damoreluc/ITEM_2223_git_V7/README.md

# Hardware progetto ITEM
## ISIS Bassa Friulana Cervignano del Friuli - ISIS Malignani Udine - Danieli 

Progetto hardware delle schede del sistema di acquisizione dati del _Banco di prova per riduttori meccanici_<br>
Il progetto è realizzato con il cad Eagle.
