damoreluc/ITEM_2223_git_V7/item_2022_Frontend_02_V7_SCH.pdf

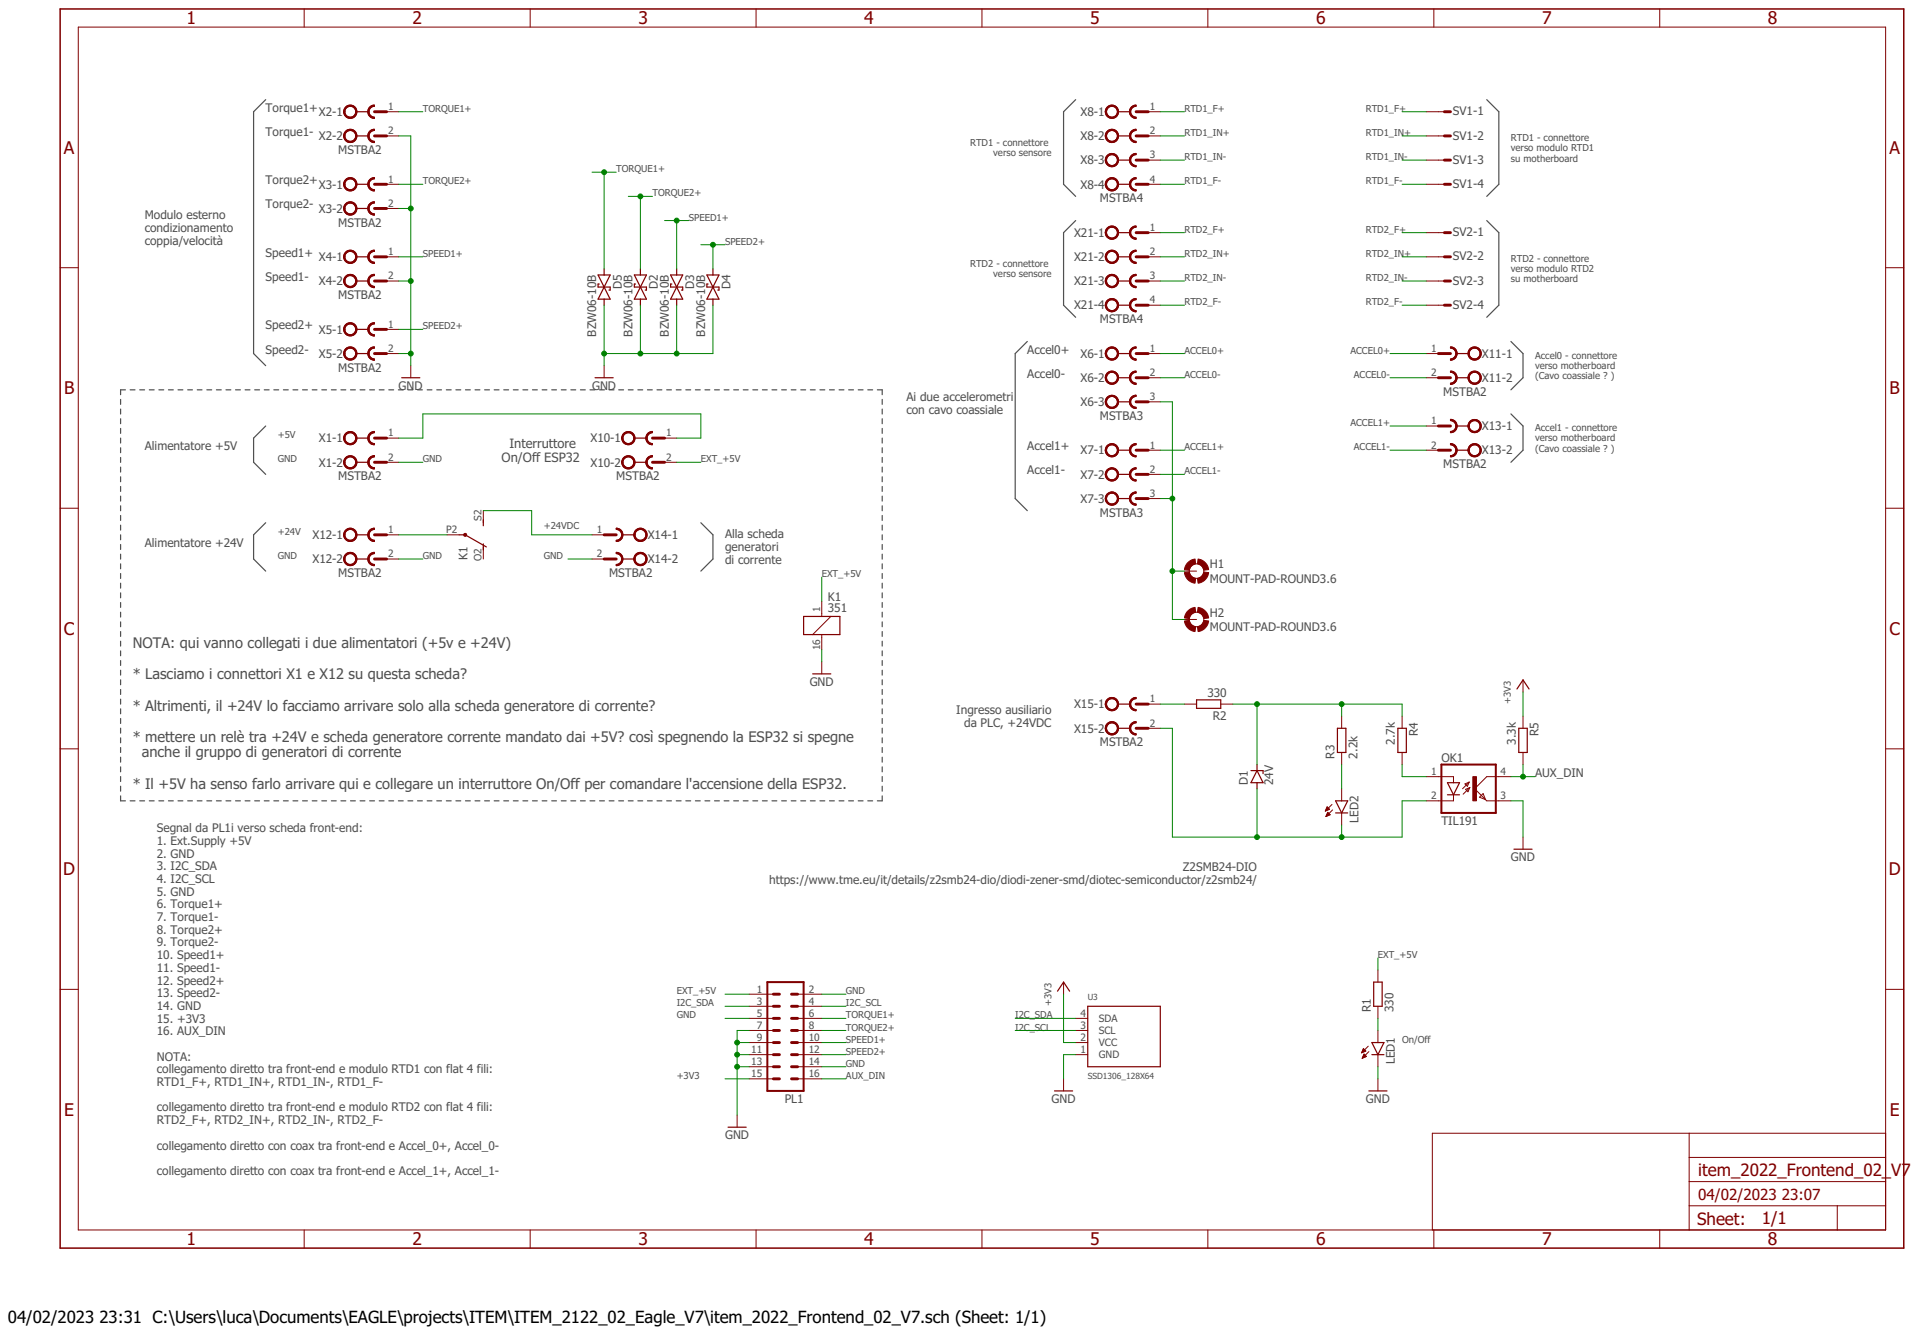
[picture p1: page 1]

TORQUE1+

Ai due accelerometri con cavo coassiale

NOTA: qui vanno collegati i due alimentatori (+5v e +24V) * Lasciamo i connettori X1 e X12 su questa scheda? * Altrimenti, il +24V lo facciamo arrivare solo alla scheda generatore di corrente? * mettere un relè tra +24V e scheda generatore corrente mandato dai +5V? così spegnendo la ESP32 si spegne

Ingresso ausiliario da PLC, +24VDC

anche il gruppo di generatori di corrente * Il +5V ha senso farlo arrivare qui e collegare un interruttore On/Off per comandare l'accensione della ESP32.

Segnal da PL1i verso scheda front-end: 1. Ext.Supply +5V

https://www.tme.eu/it/details/z2smb24-dio/diodi-zener-smd/diotec-semiconductor/z2smb24/

NOTA: collegamento diretto tra front-end e modulo RTD1 con flat 4 fili: RTD1_F+, RTD1_IN+, RTD1_IN-, RTD1_F- collegamento diretto tra front-end e modulo RTD2 con flat 4 fili: RTD2_F+, RTD2_IN+, RTD2_IN-, RTD2_F- collegamento diretto con coax tra front-end e Accel_0+, Accel_0- collegamento diretto con coax tra front-end e Accel_1+, Accel_1-

04/02/2023 23:31 C:\Users\luca\Documents\EAGLE\projects\ITEM\ITEM_2122_02_Eagle_V7\item_2022_Frontend_02_V7.sch (Sheet: 1/1)
