damoreluc/ITEM_2223_git_V7/item_2022_Motherboard_04_V8_SCH.pdf

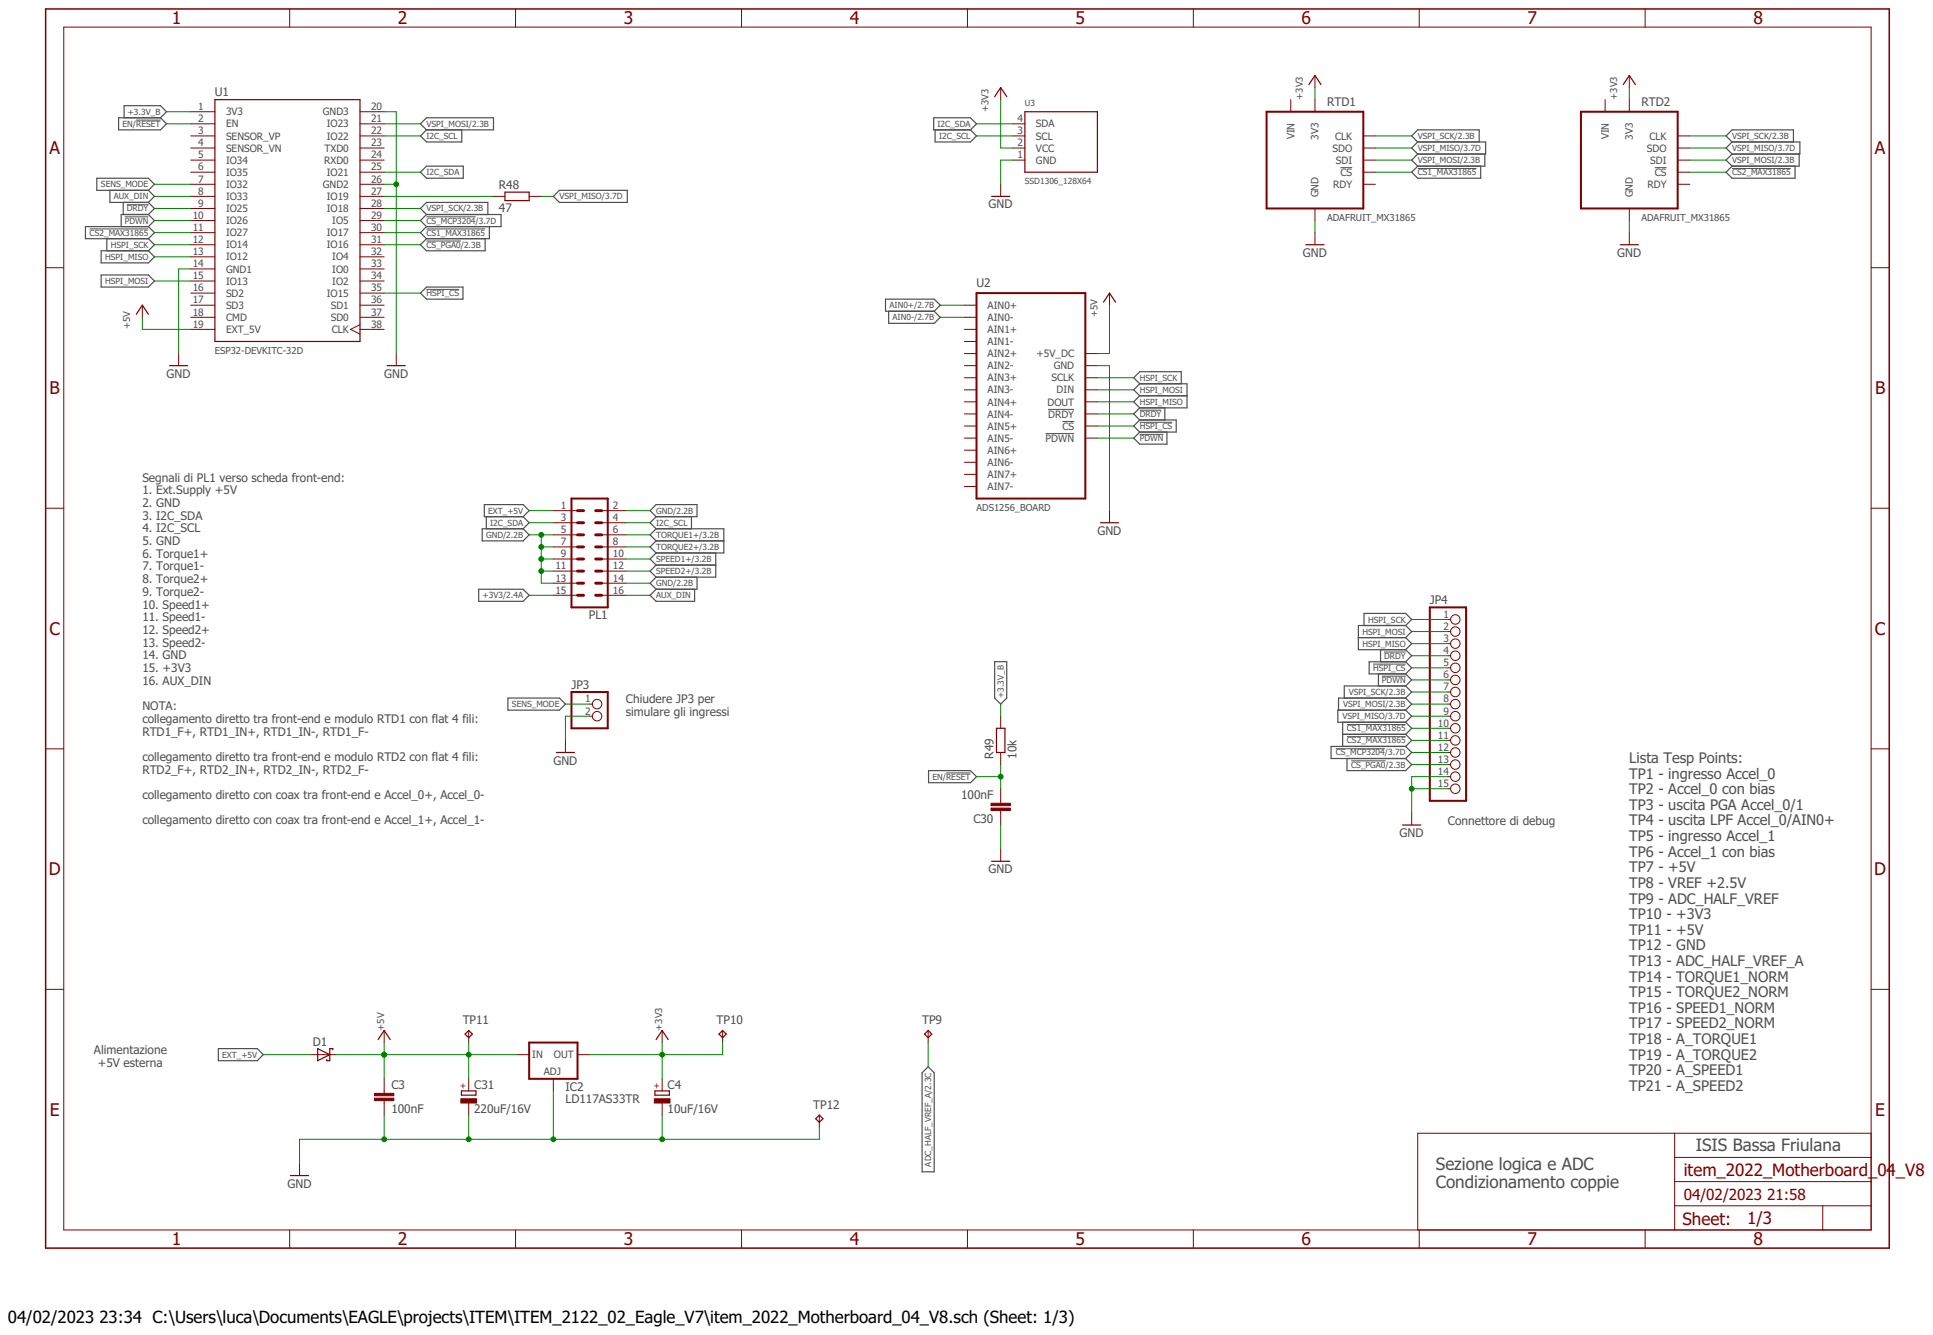
[picture p2: page 1]

Segnali di PL1 verso scheda front-end: 1. Ext.Supply +5V

NOTA: collegamento diretto tra front-end e modulo RTD1 con flat 4 fili: RTD1_F+, RTD1_IN+, RTD1_IN-, RTD1_F- collegamento diretto tra front-end e modulo RTD2 con flat 4 fili: RTD2_F+, RTD2_IN+, RTD2_IN-, RTD2_F- collegamento diretto con coax tra front-end e Accel_0+, Accel_0- collegamento diretto con coax tra front-end e Accel_1+, Accel_1-

Chiudere JP3 per simulare gli ingressi

04/02/2023 23:34 C:\Users\luca\Documents\EAGLE\projects\ITEM\ITEM_2122_02_Eagle_V7\item_2022_Motherboard_04_V8.sch (Sheet: 1/3)

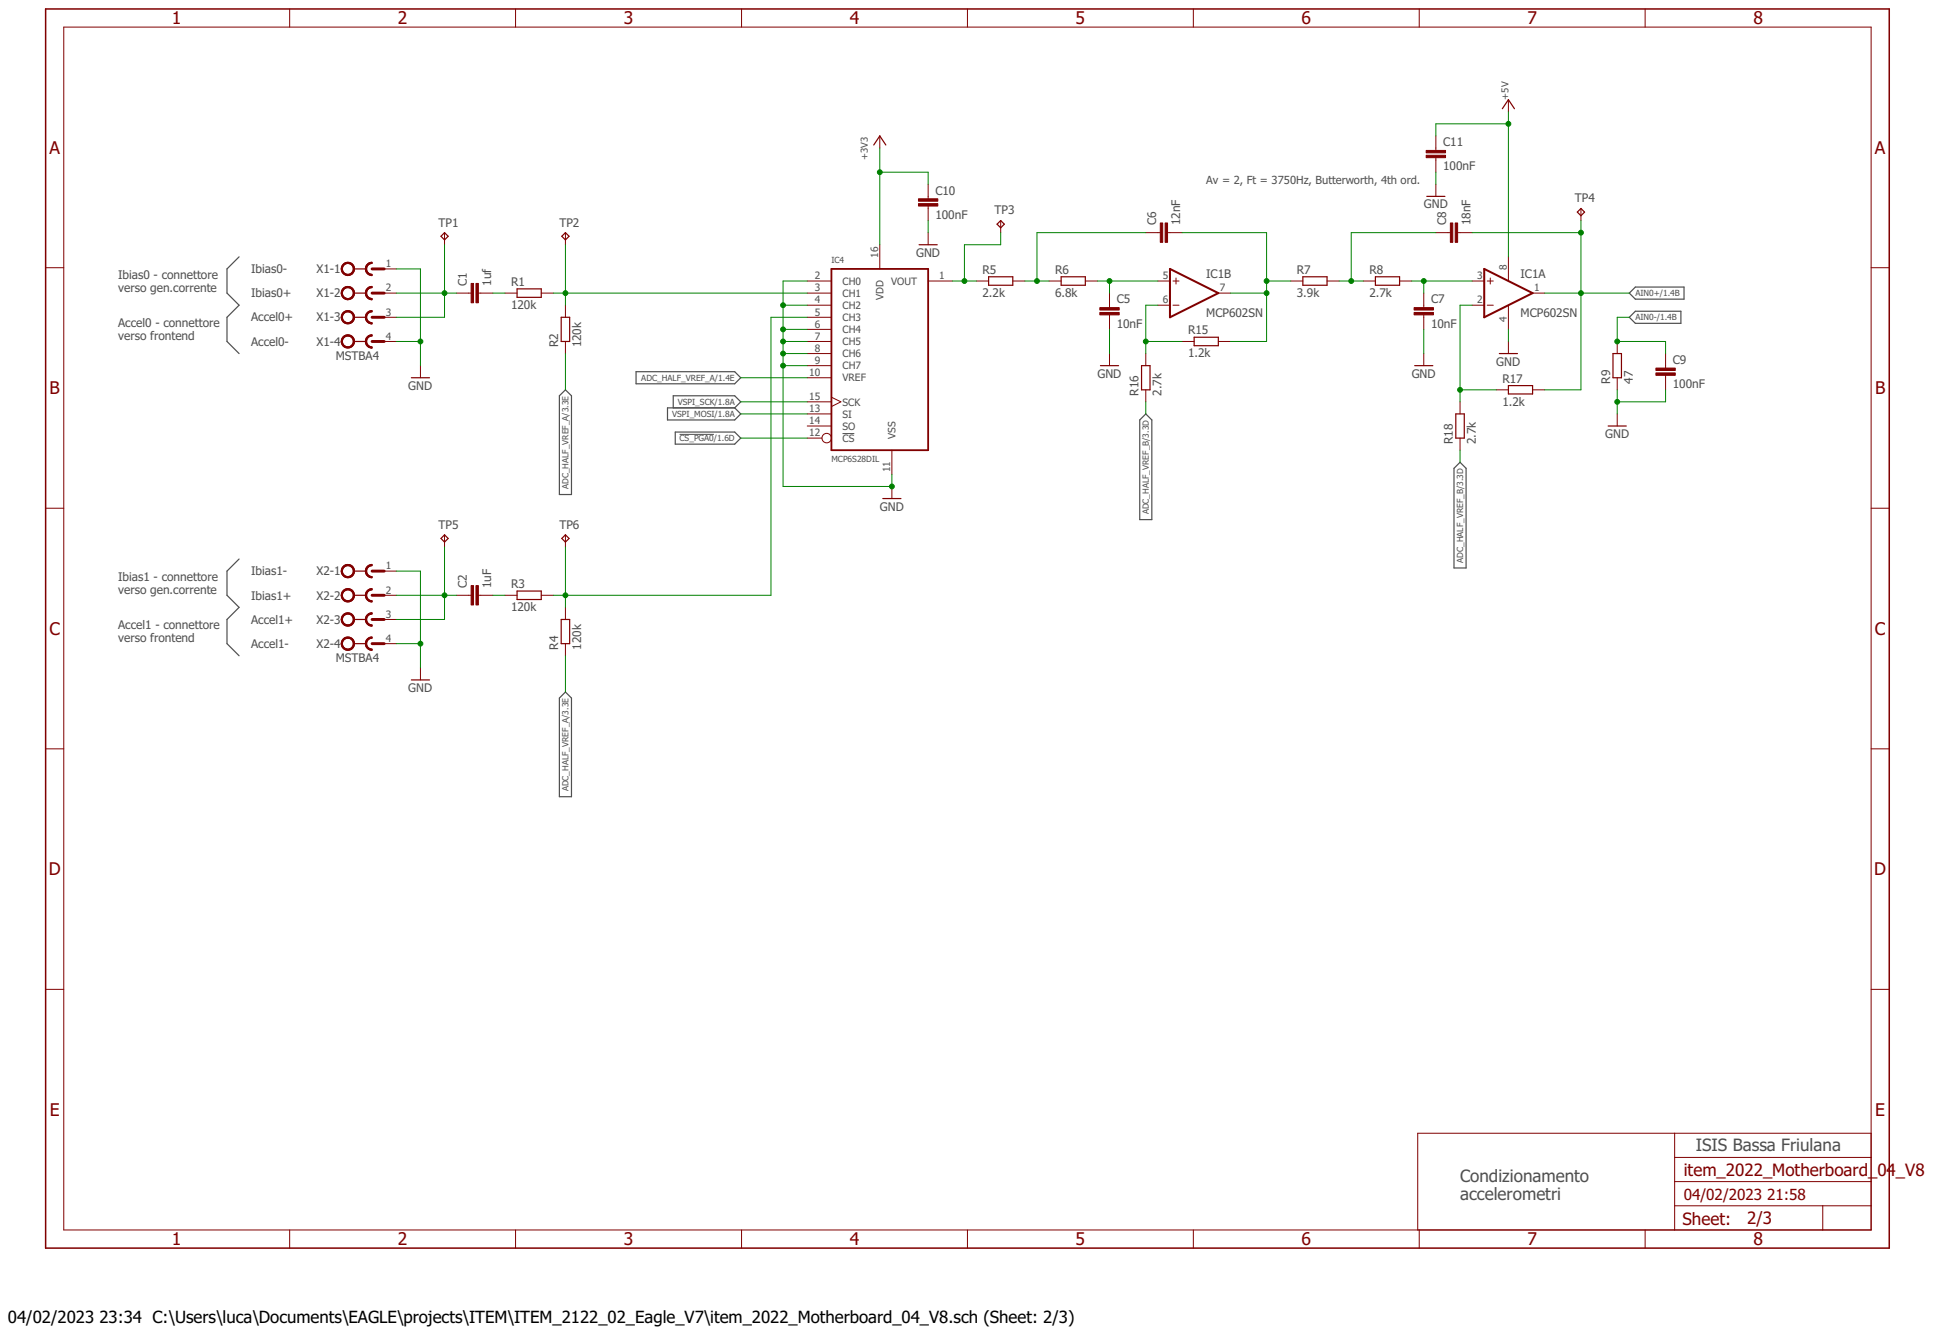
[picture p3: page 2]

Av = 2, Ft = 3750Hz, Butterworth, 4th ord.

15
SI 13

04/02/2023 23:34 C:\Users\luca\Documents\EAGLE\projects\ITEM\ITEM_2122_02_Eagle_V7\item_2022_Motherboard_04_V8.sch (Sheet: 2/3)

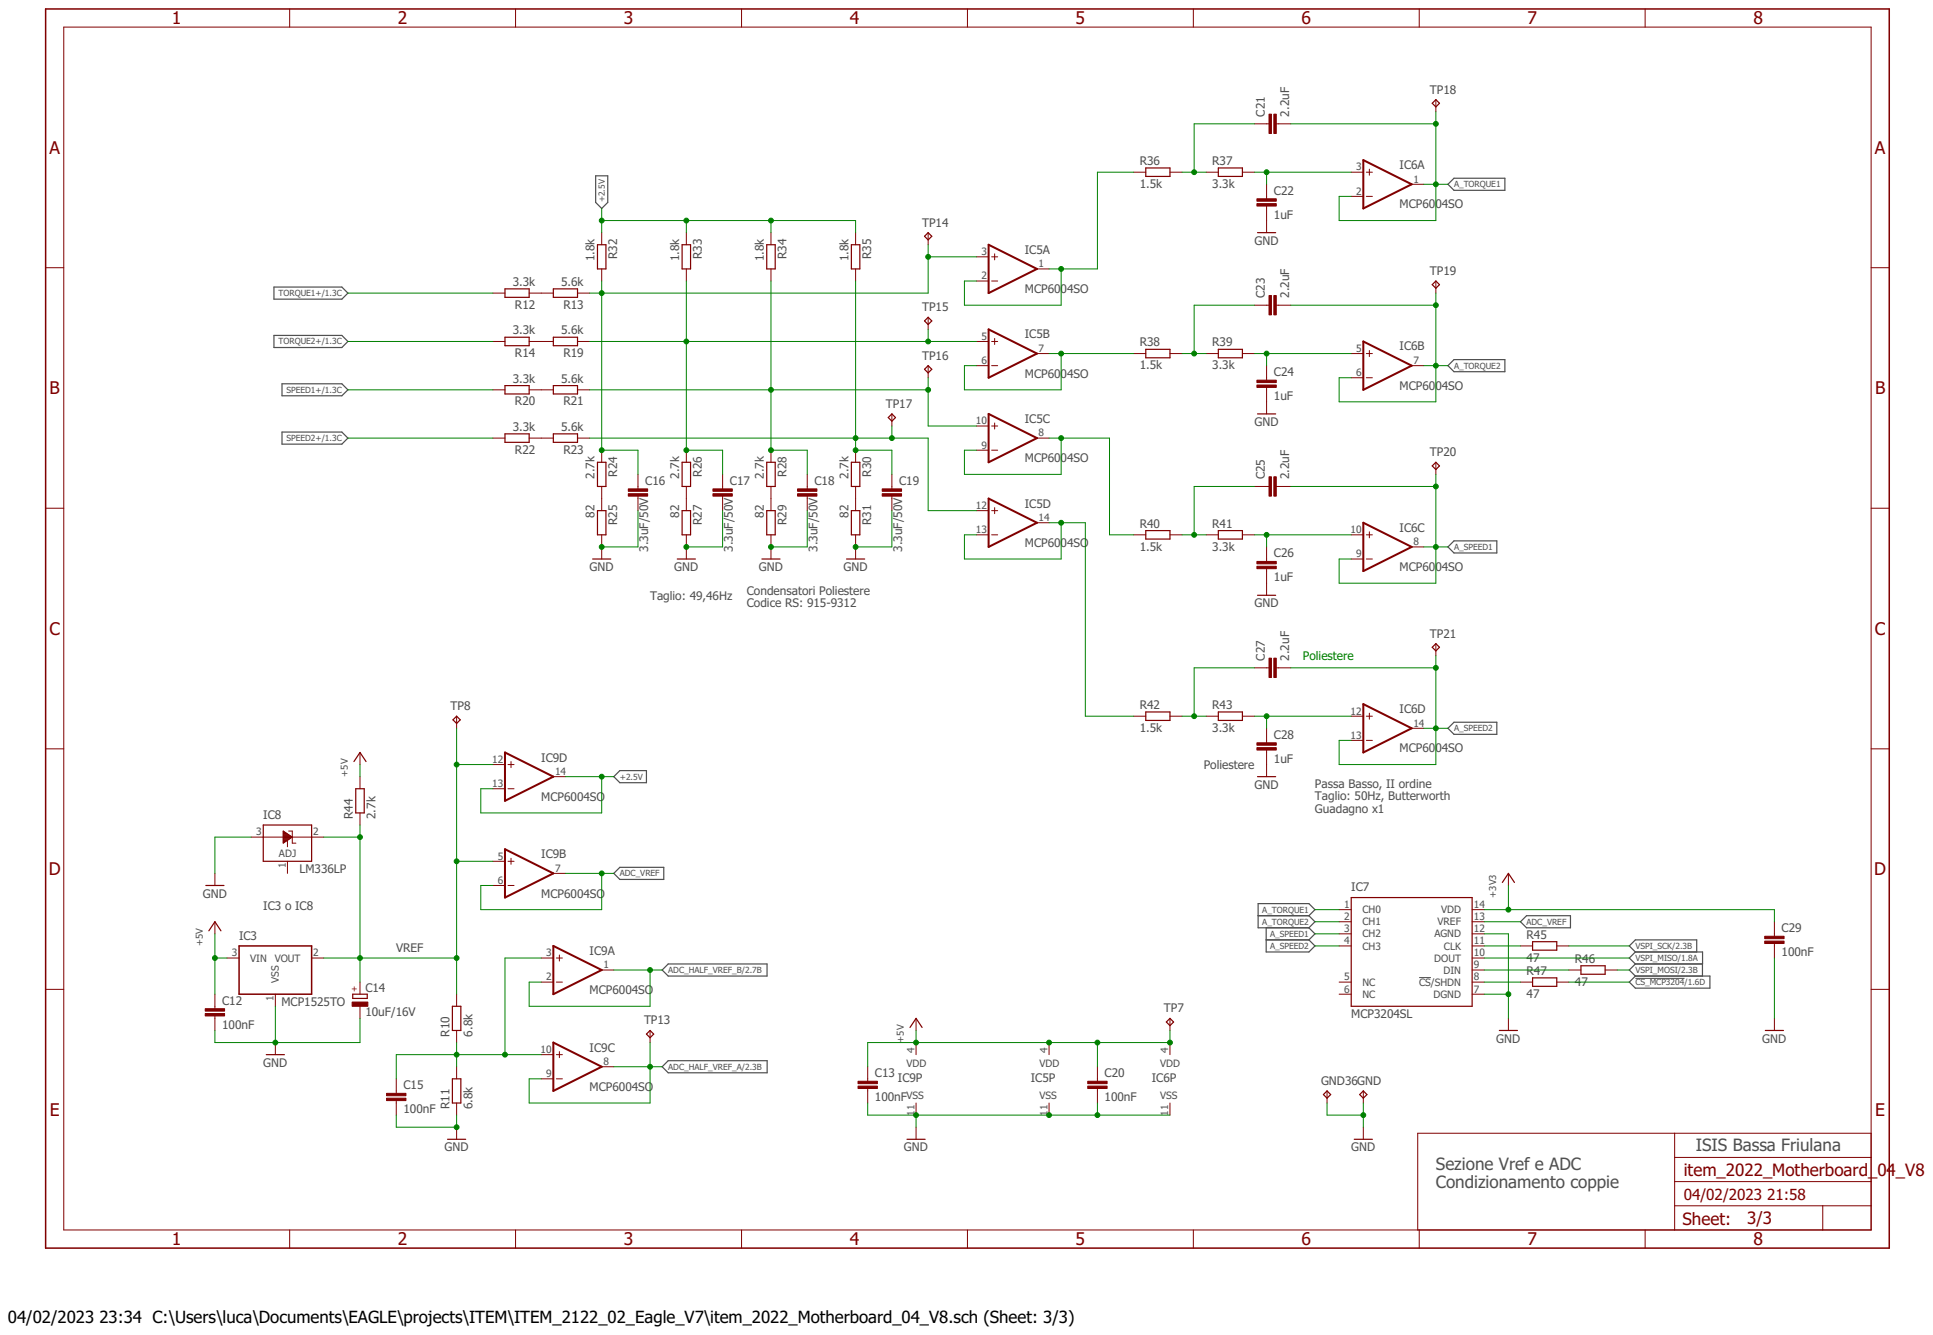
[picture p4: page 3]

Passa Basso, II ordine Taglio: 50Hz, Butterworth

04/02/2023 23:34 C:\Users\luca\Documents\EAGLE\projects\ITEM\ITEM_2122_02_Eagle_V7\item_2022_Motherboard_04_V8.sch (Sheet: 3/3)
