damoreluc/ITEM_2223_git_V7/item_2022_02b.pdf

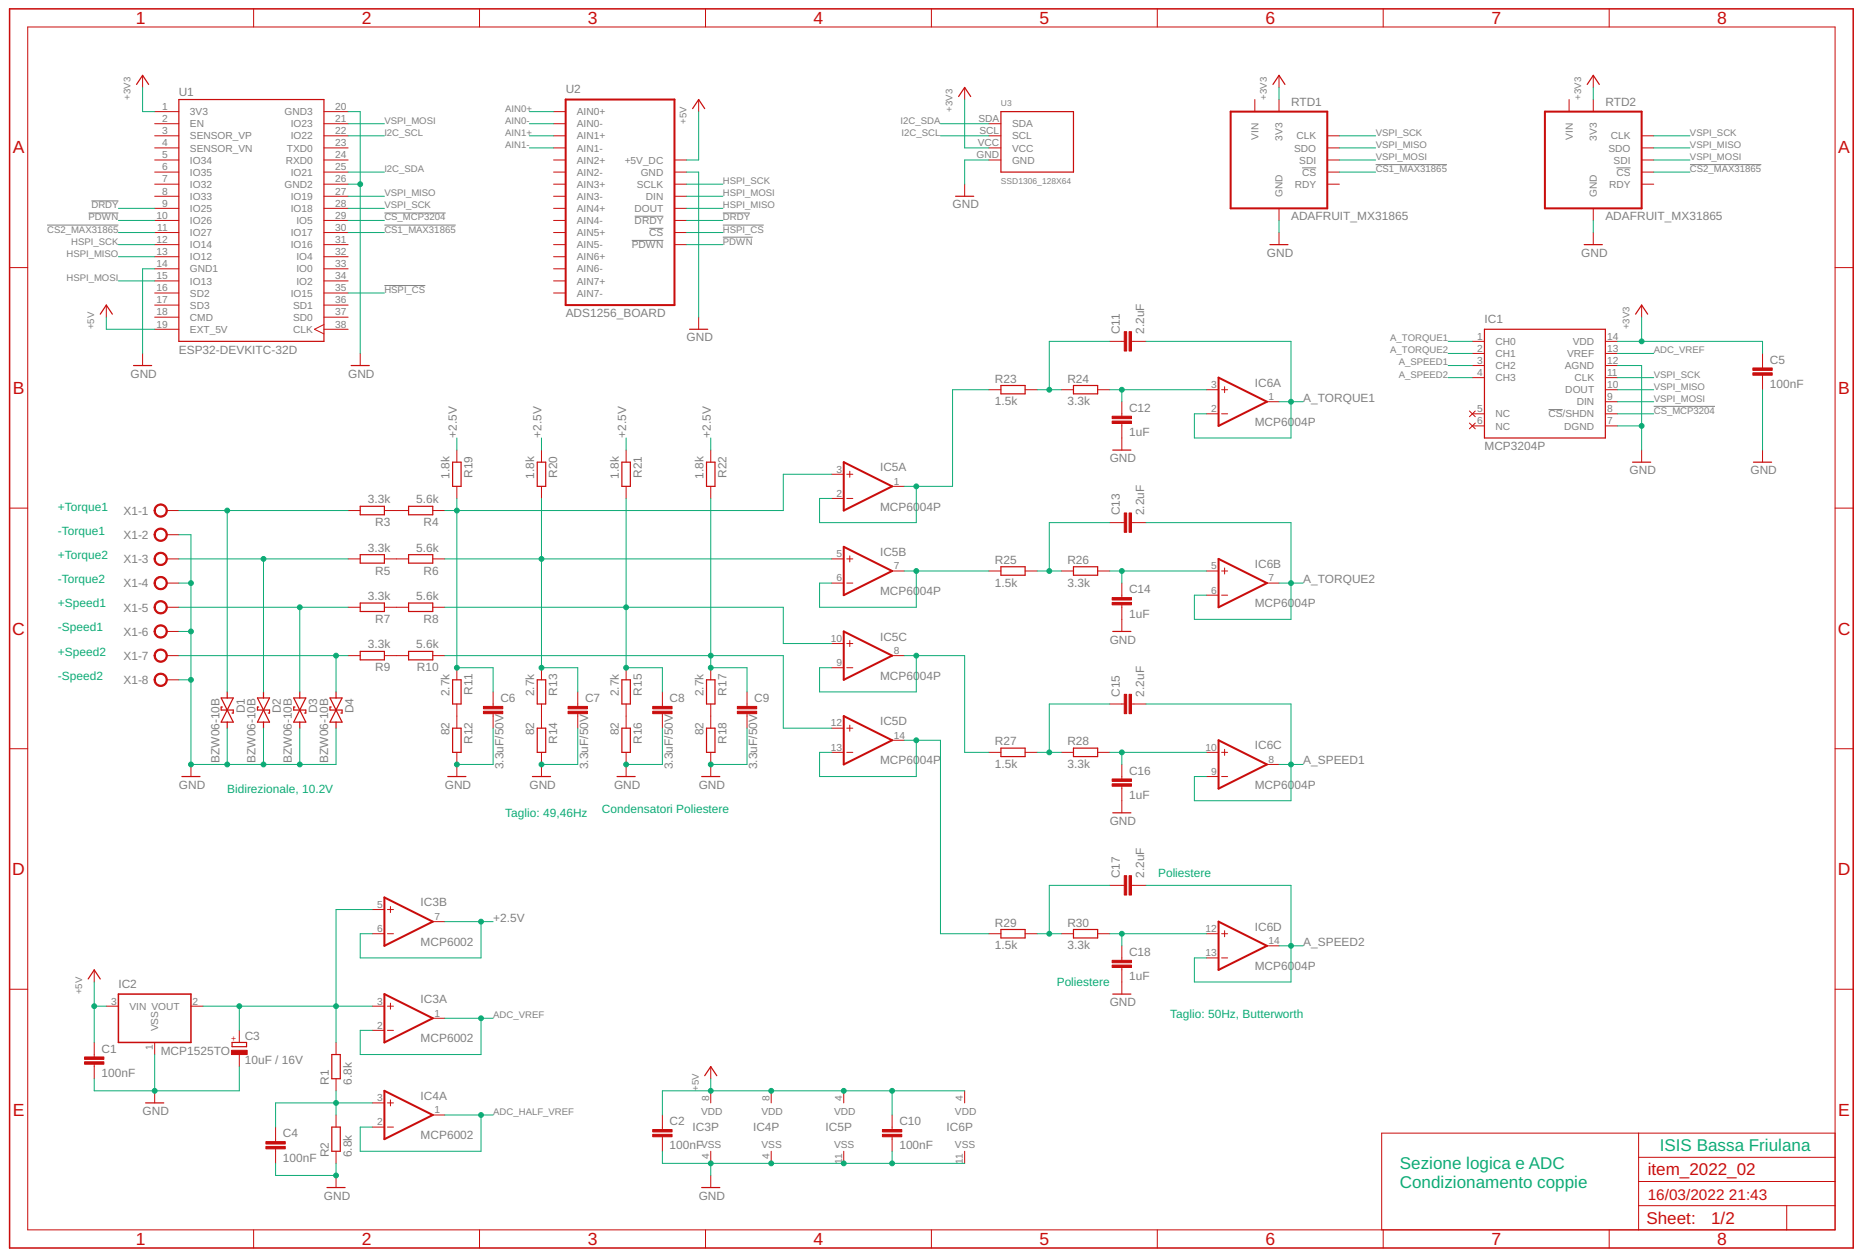
[picture p5: page 1]

Sezione logica e ADC Condizionamento coppie | ISIS Bassa Friulana

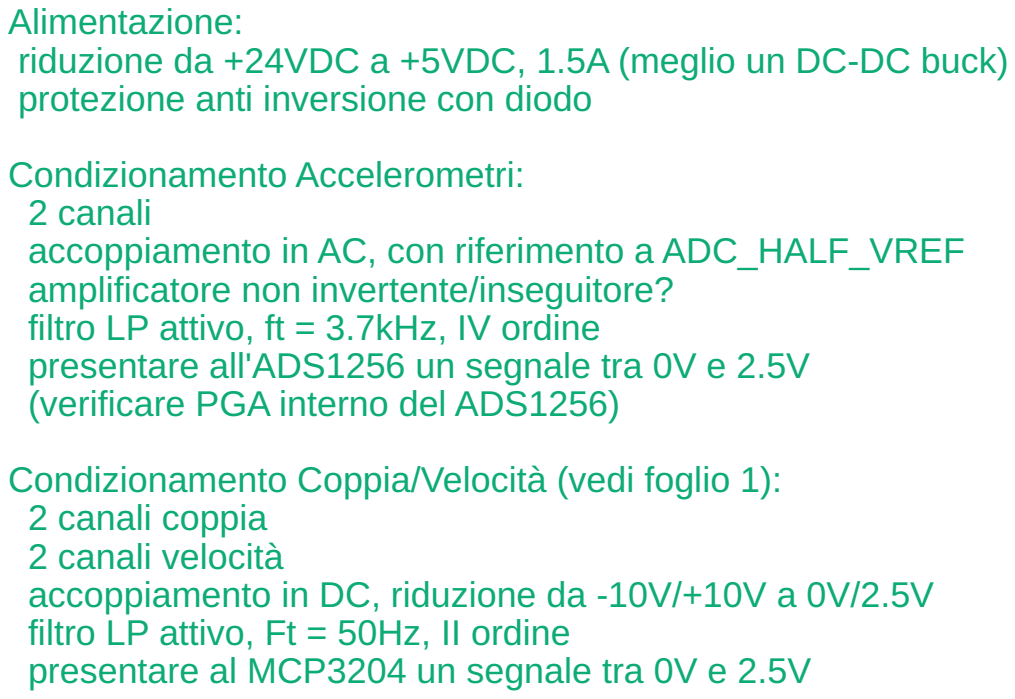
[picture p6: page 2]

Alimentazione:
riduzione da +24VDC a +5VDC, 1.5A (meglio un DC-DC buck)
protezione anti inversione con diodo

Condizionamento Accelerometri:
2 canali
accoppiamento in AC, con riferimento a ADC_HALF_VREF
amplificatore non invertente/inseguitore?
filtro LP attivo, ft = 3.7kHz, IV ordine
presentare all'ADS1256 un segnale tra 0V e 2.5V
(verificare PGA interno del ADS1256)

Condizionamento Coppia/Velocità (vedi foglio 1):

2 canali coppia
2 canali velocità
accoppiamento in DC, riduzione da -10V/+10V a 0V/2.5V
filtro LP attivo, Ft = 50Hz, II ordine
presentare al MCP3204 un segnale tra 0V e 2.5V
