damoreluc/ITEM_2223_git_V7/item_2022_analog_02_top.pdf

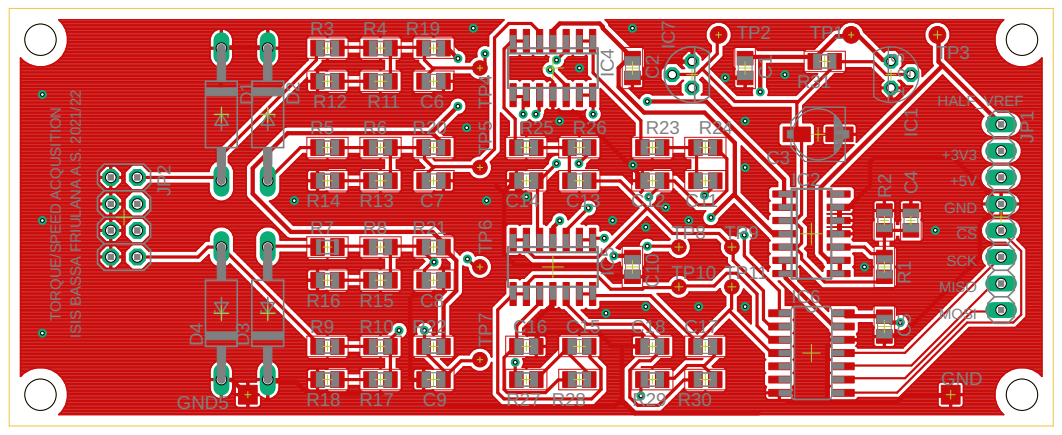
[picture p7: page 1]

2 3 1 MOSI MISO SCKCS GND +5V +3V3 HALF_VREF TORQUE/SPEED ACQUSITION ISIS BASSA FRIULANA A.S. 2021/22 C1 C10 C14 C13 C12 C11 C16 C15 C18 C17 C2 C3 C4 C5 C6 C7 C8C9 D1 D2 D3 D4 IC1 IC4 IC5 IC6 IC7 JP1 R1 R10 R12 R11 R14 R13 R16 R15 R18 R17 R19 R2 R20 R21 R22 R25 R26 R23 R24 R27 R28 R29 R3 R30 R31 R4 R5 R6 R7 R8 R9 IC2 GND GND5 TP2 TP1 TP3 TP4 TP5 TP6 TP7 TP8 TP9 TP10 TP11 JP2
