damoreluc/ITEM_2223_git_V7/item_2022_BlockDiagram_01.pdf

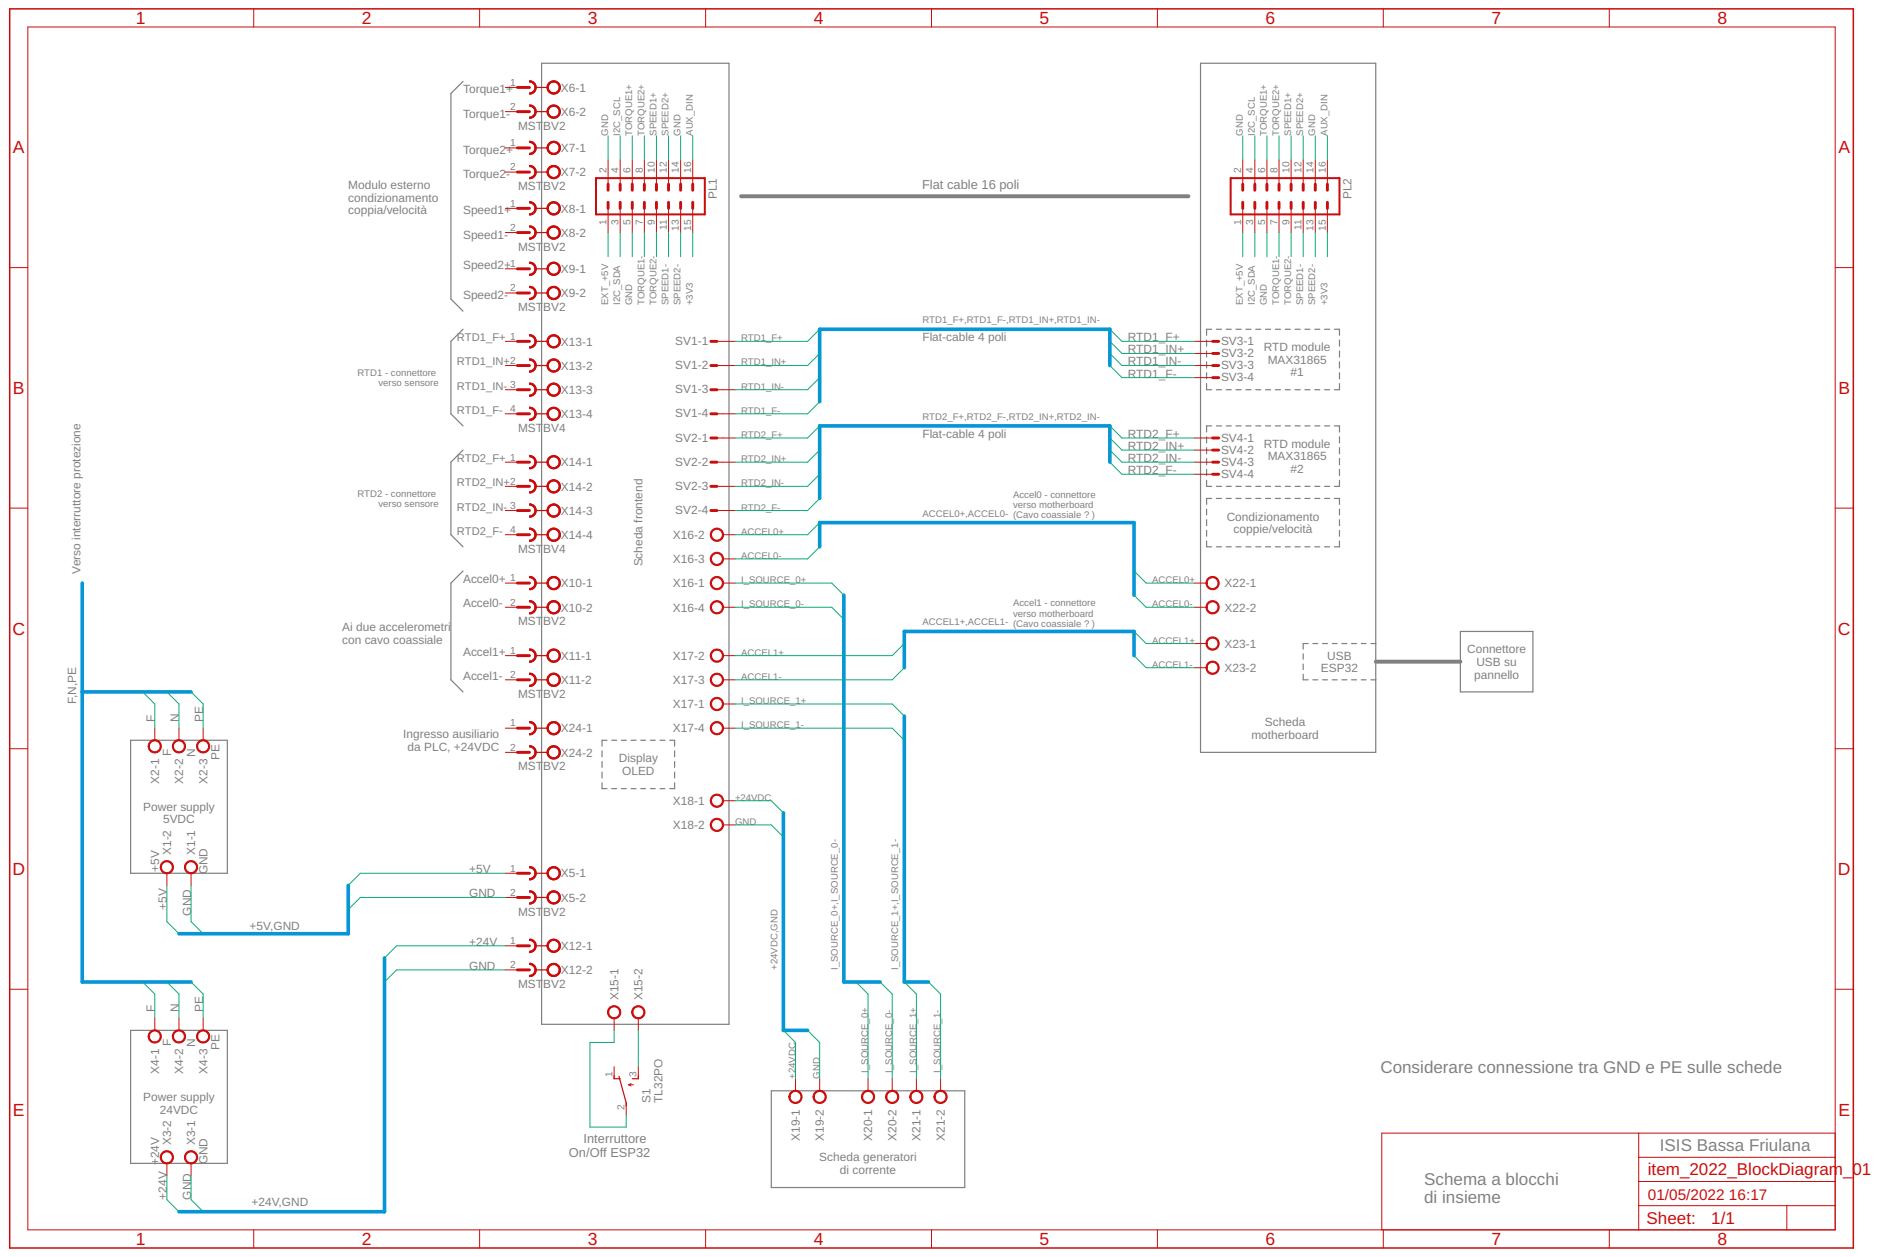
[picture p8: page 1]

Ai due accelerometri con cavo coassiale

Considerare connessione tra GND e PE sulle schede
