damoreluc/ITEM_2223_git_V7/item_2022_BlockDiagram_02.pdf

A

A

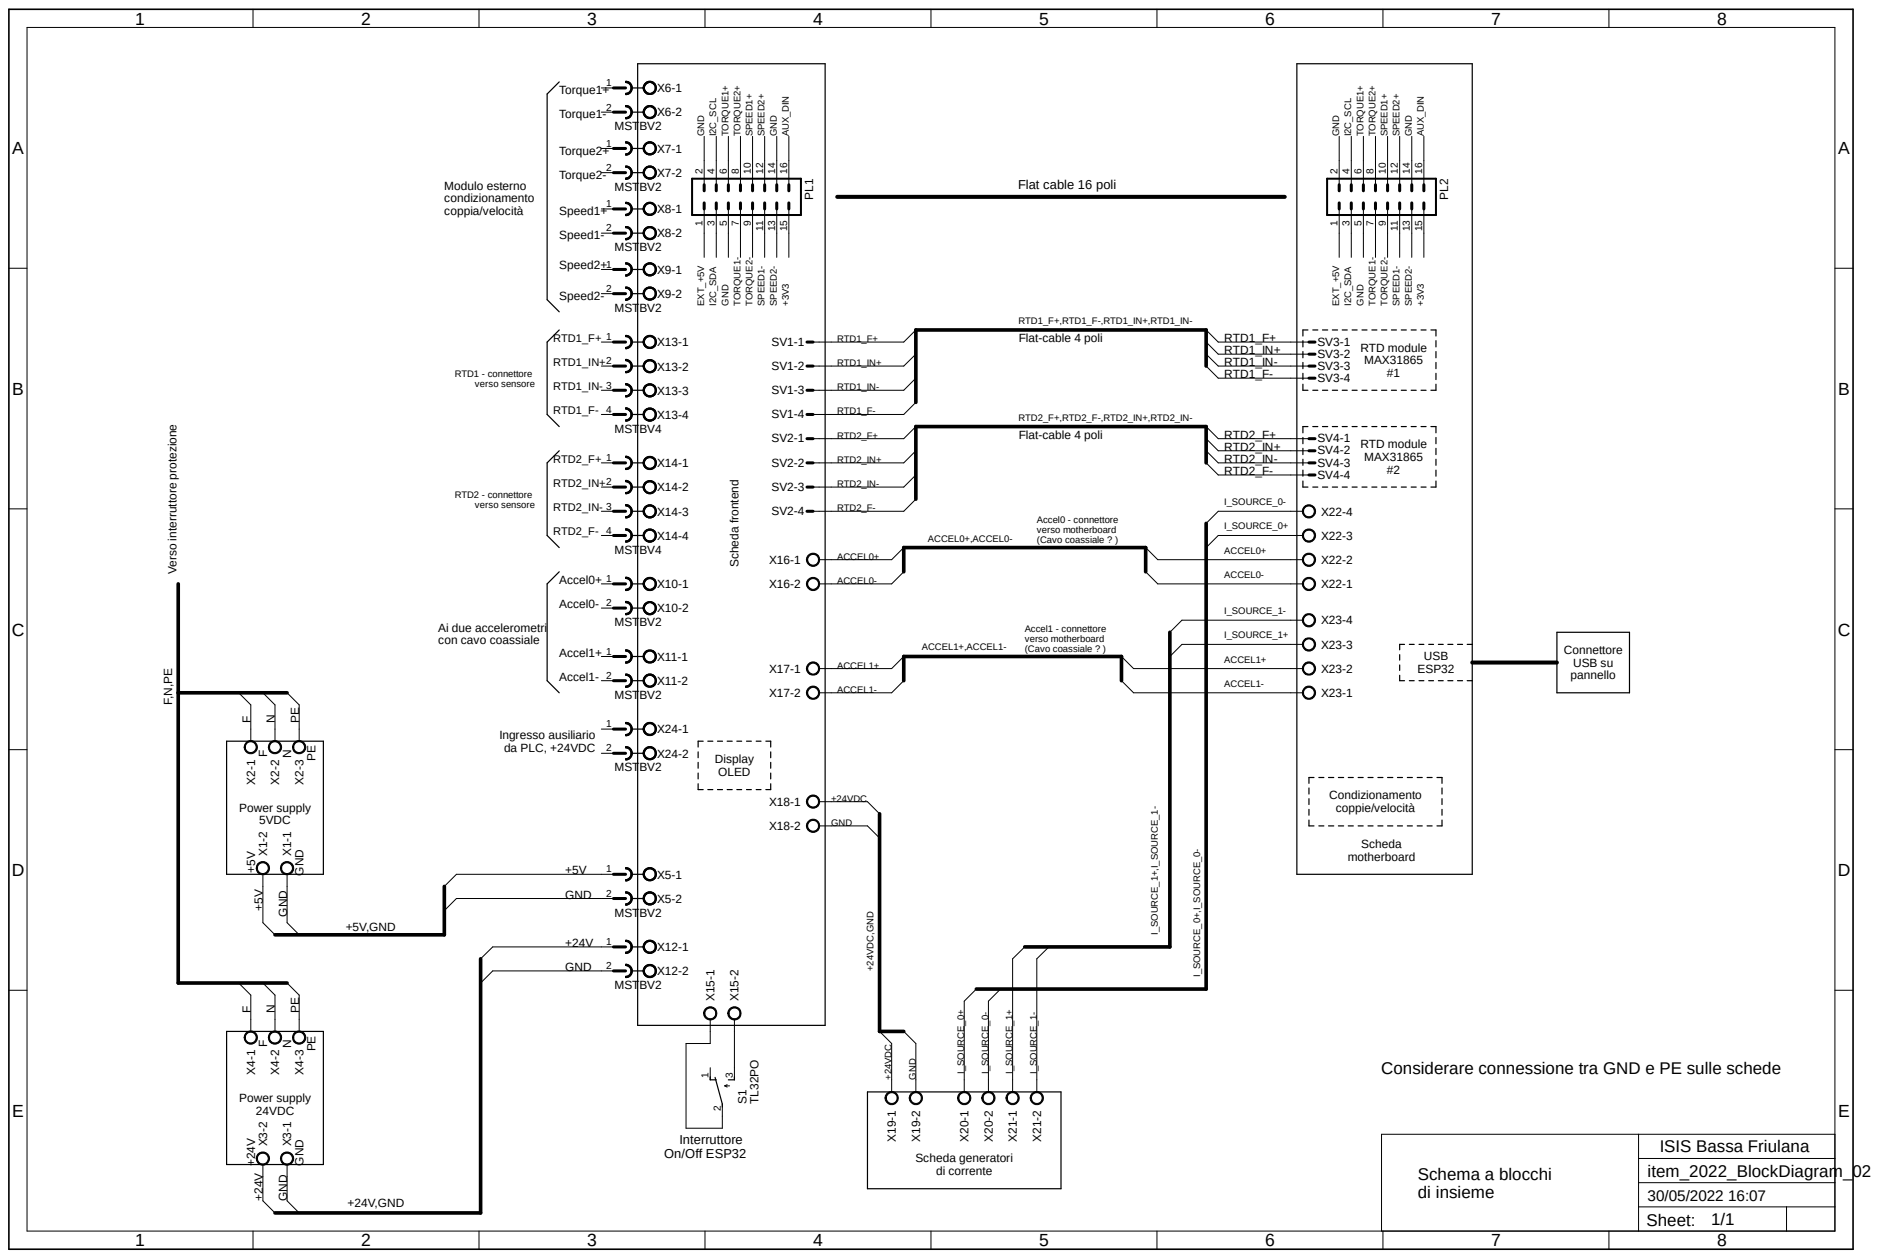
[picture p9: page 1]
ISIS Bassa Friulana; Power supply; 5VDC +5V; GND; FNPE; 24VDC +24V; Torque1+; Torque1-; Torque2+; Torque2-; Speed1+; Speed1-; Speed2+; Speed2-; Modulo esterno condizionamento coppia/velocità; Accel0+; Accel0-; Accel1+; Accel1-; RTD1_F+; RTD1_IN+; RTD1_IN-; RTD1_F-; RTD2_F+; RTD2_F-; RTD2_IN+; RTD2_IN-; Interruttore On/Off ESP32; (Cavo coassiale ? ); Scheda generatori; di corrente Scheda frontend; RTD module MAX31865 #1; RTD module MAX31865 #2; Condizionamento coppie/velocità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

RTD1 - connettore verso sensore RTD2 - connettore verso sensore Ai due accelerometri

Flat cable 16 poli

RTD1_F+,RTD1_F-,RTD1_IN+,RTD1_IN-
Flat-cable 4 poli

RTD2_F+,RTD2_F-,RTD2_IN+,RTD2_IN-

con cavo coassiale Verso interruttore protezione

Accel0 - connettore verso motherboard
(Cavo coassiale ? ) Accel1 - connettore verso motherboard

Considerare connessione tra GND e PE sulle schede
