damoreluc/ITEM_2223_git_V7/item_2022_Frontend_02.pdf

A

A

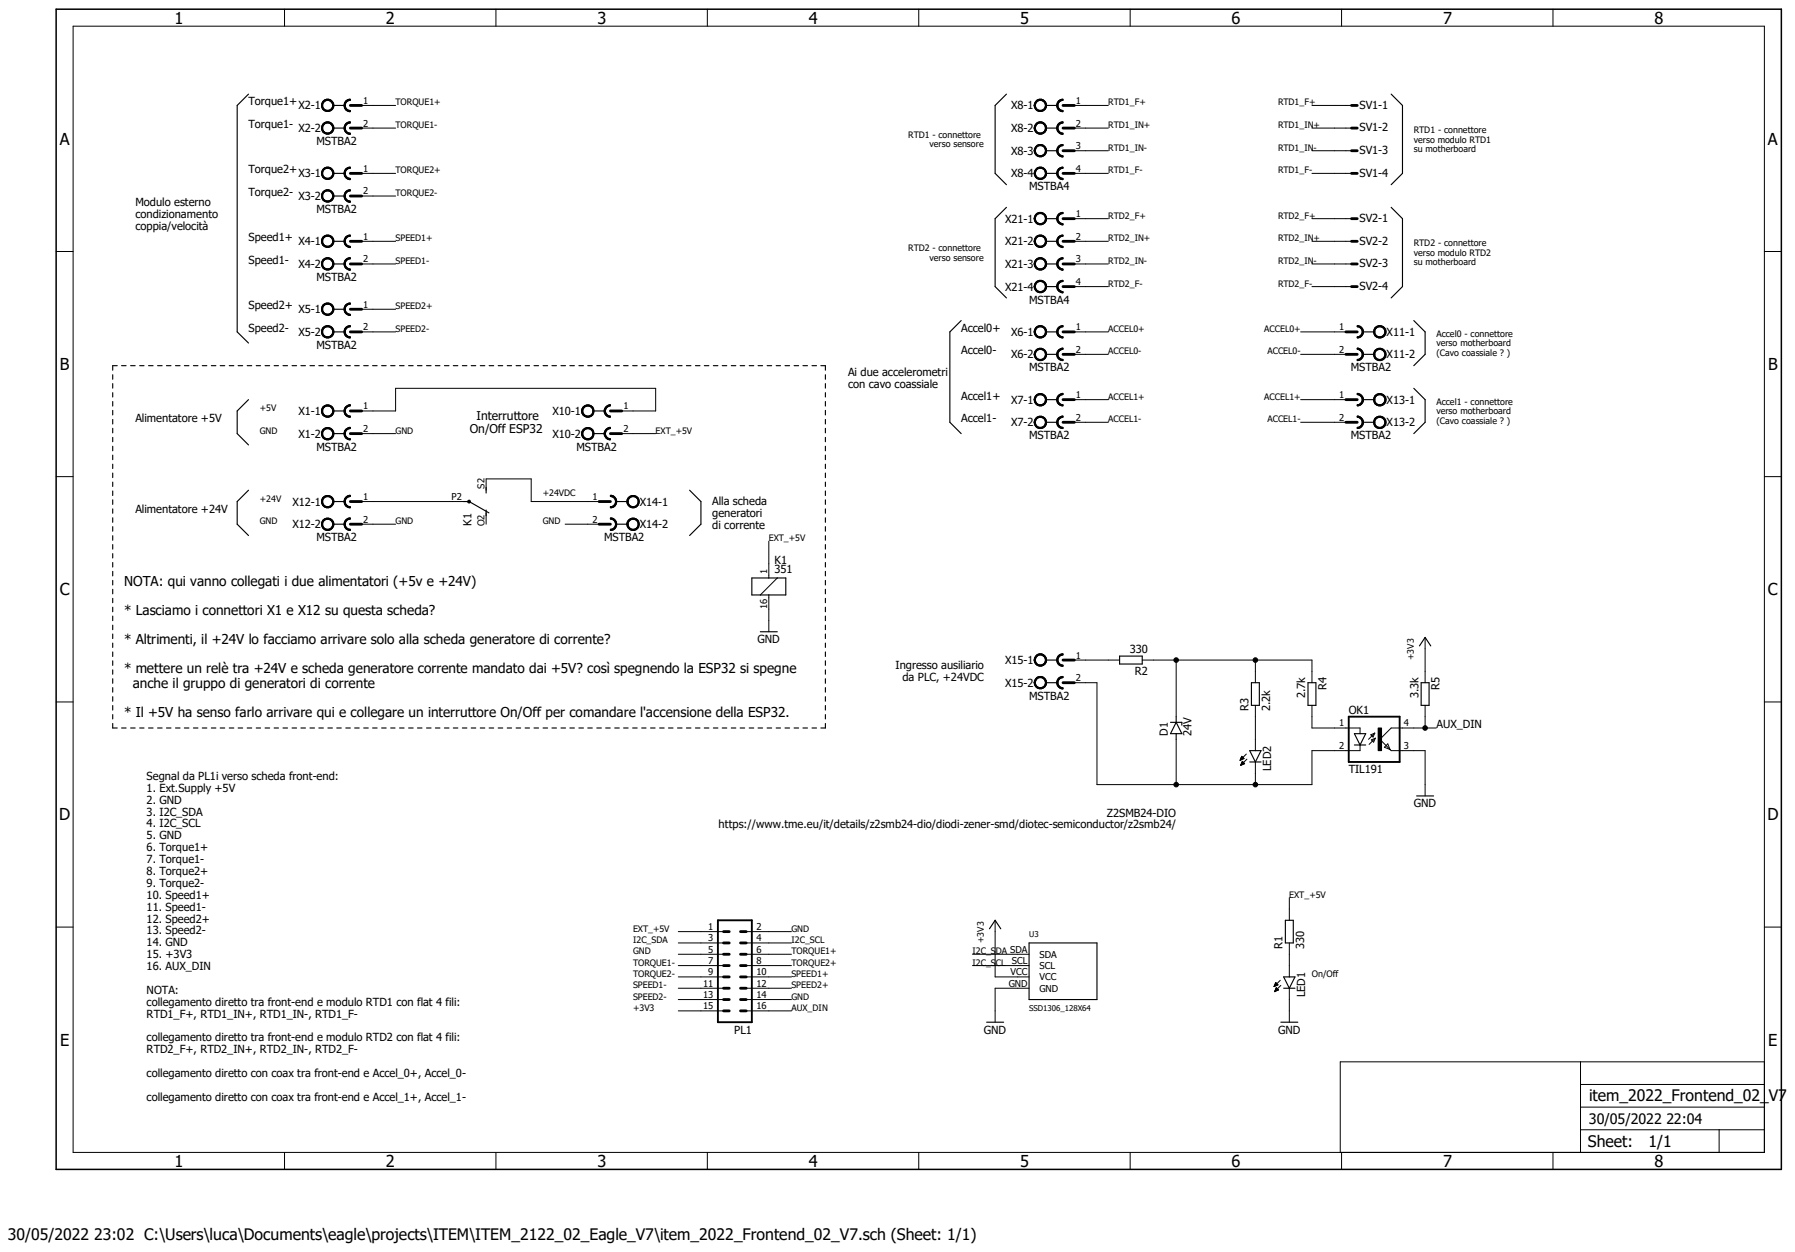
[picture p10: page 1]
Interruttore On/Off ESP32; Alimentatore +5V; +5V GND; Torque1+; Torque1-; Torque2+; Torque2-; Speed1+; Speed1-; Speed2+; Speed2-; Accel0+; Accel0-; Accel1+; Accel1-; RTD1 - connettore verso sensore RTD2 - connettore verso sensore; RTD1 - connettore verso modulo RTD1; Modulo esterno condizionamento coppia/velocità; Alimentatore +24V; +24V GND; (Cavo coassiale ? ); On/Off; Alla scheda generatori di corrente; Ingresso ausiliario da PLC, +24VDC; Z2SMB24-DIO; GND ⁺³V3; GND ³³⁰; GND; TIL191 ².2k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

TORQUE1+

su motherboard RTD2 - connettore verso modulo RTD2

su motherboard Ai due accelerometri

SV2-4 LED¹ R¹ ¹⁶ ¹

Accel0 - connettore verso motherboard
(Cavo coassiale ? ) Accel1 - connettore verso motherboard

con cavo coassiale

NOTA: qui vanno collegati i due alimentatori (+5v e +24V)
* Lasciamo i connettori X1 e X12 su questa scheda?
* Altrimenti, il +24V lo facciamo arrivare solo alla scheda generatore di corrente?
* mettere un relè tra +24V e scheda generatore corrente mandato dai +5V? così spegnendo la ESP32 si spegne
anche il gruppo di generatori di corrente
* Il +5V ha senso farlo arrivare qui e collegare un interruttore On/Off per comandare l'accensione della ESP32.

Segnal da PL1i verso scheda front-end:
1. Ext.Supply +5V
2. GND
3. I2C_SDA
4. I2C_SCL
5. GND
6. Torque1+
7. Torque1-
8. Torque2+
9. Torque2-
10. Speed1+
11. Speed1-
12. Speed2+
13. Speed2-
14. GND
16. AUX_DIN
NOTA:
collegamento diretto tra front-end e modulo RTD1 con flat 4 fili:
RTD1_F+, RTD1_IN+, RTD1_IN-, RTD1_F-
collegamento diretto tra front-end e modulo RTD2 con flat 4 fili:
RTD2_F+, RTD2_IN+, RTD2_IN-, RTD2_F-
collegamento diretto con coax tra front-end e Accel_0+, Accel_0-
collegamento diretto con coax tra front-end e Accel_1+, Accel_1-

https://www.tme.eu/it/details/z2smb24-dio/diodi-zener-smd/diotec-semiconductor/z2smb24/

30/05/2022 23:02 C:\Users\luca\Documents\eagle\projects\ITEM\ITEM_2122_02_Eagle_V7\item_2022_Frontend_02_V7.sch (Sheet: 1/1)
