damoreluc/ITEM_2223_git_V7/item_2022_Motherboard_01.pdf

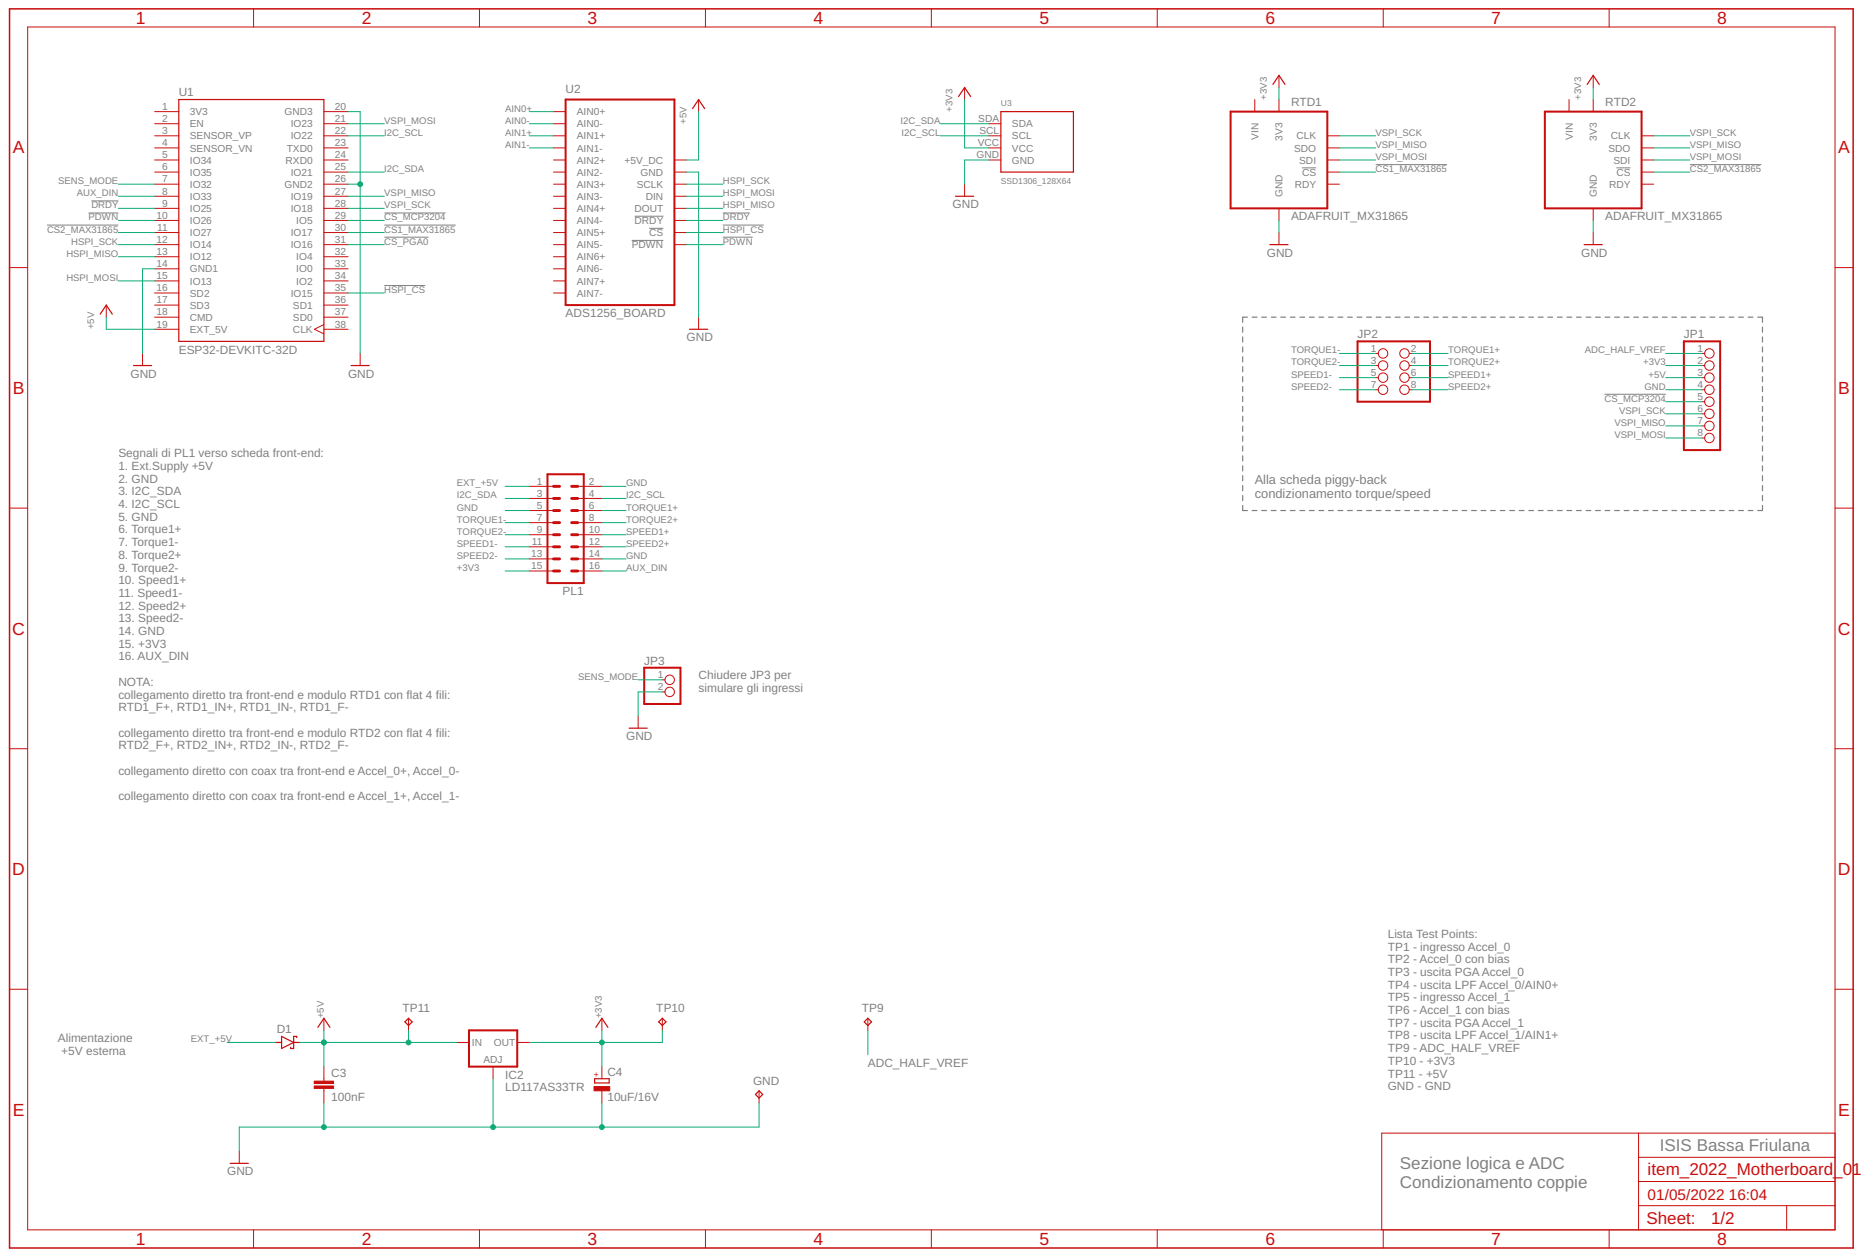
[picture p11: page 1]

Segnali di PL1 verso scheda front-end: 1. Ext.Supply +5V

Alla scheda piggy-back
condizionamento torque/speed

NOTA: collegamento diretto tra front-end e modulo RTD1 con flat 4 fili: RTD1_F+, RTD1_IN+, RTD1_IN-, RTD1_F- collegamento diretto tra front-end e modulo RTD2 con flat 4 fili: RTD2_F+, RTD2_IN+, RTD2_IN-, RTD2_F- collegamento diretto con coax tra front-end e Accel_0+, Accel_0- collegamento diretto con coax tra front-end e Accel_1+, Accel_1-

Chiudere JP3 per simulare gli ingressi

Lista Test Points: TP1 - ingresso Accel_0

TP2 - Accel_0 con bias TP3 - uscita PGA Accel_0

TP6 - Accel_1 con bias TP7 - uscita PGA Accel_1

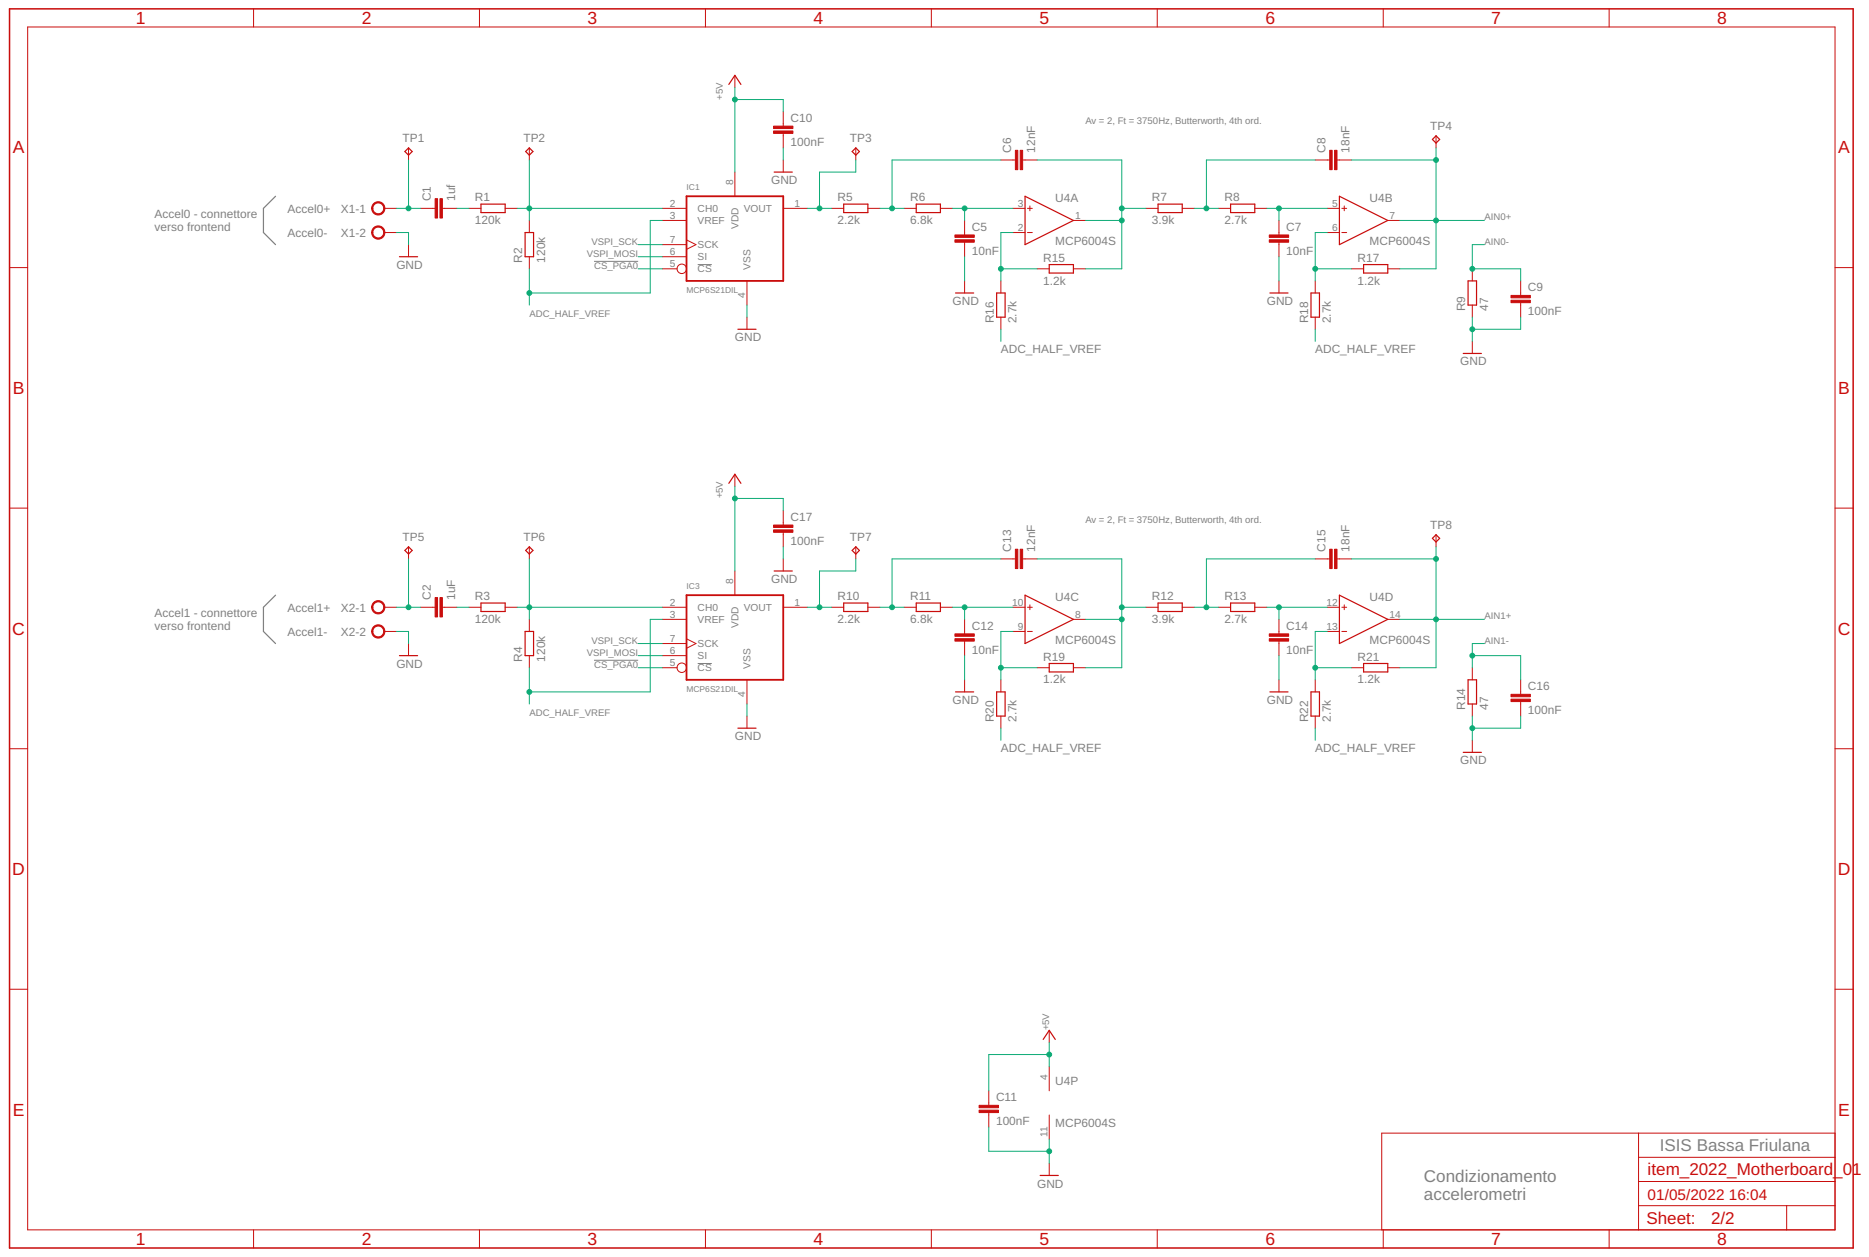
[picture p12: page 2]

Av = 2, Ft = 3750Hz, Butterworth, 4th ord. Accel0 - connettore

Av = 2, Ft = 3750Hz, Butterworth, 4th ord.
