damoreluc/ITEM_2223_git_V7/item_2022_Motherboard_02.pdf

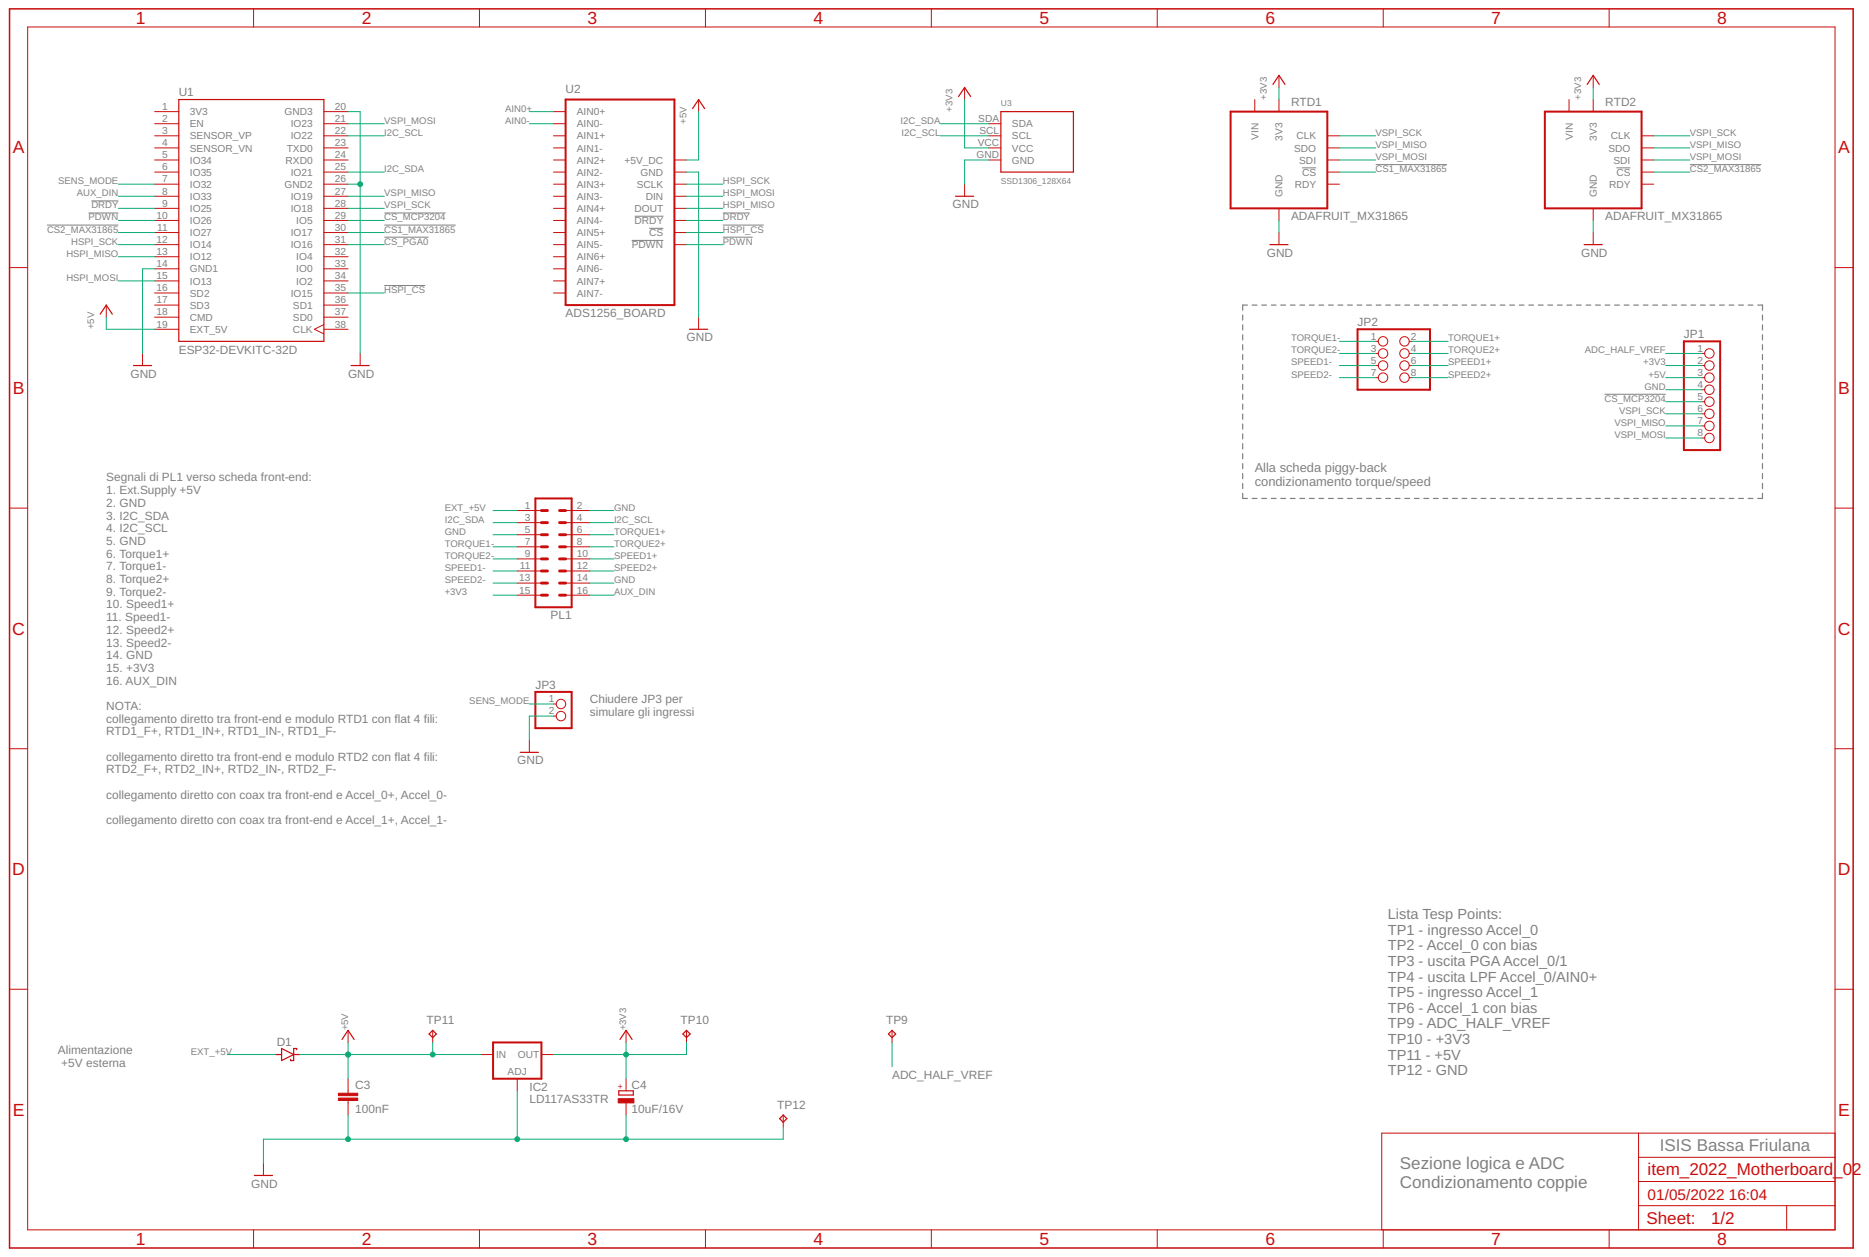
[picture p13: page 1]

Alla scheda piggy-back

condizionamento torque/speed Segnali di PL1 verso scheda front-end: 1. Ext.Supply +5V

NOTA: collegamento diretto tra front-end e modulo RTD1 con flat 4 fili: RTD1_F+, RTD1_IN+, RTD1_IN-, RTD1_F- collegamento diretto tra front-end e modulo RTD2 con flat 4 fili: RTD2_F+, RTD2_IN+, RTD2_IN-, RTD2_F- collegamento diretto con coax tra front-end e Accel_0+, Accel_0- collegamento diretto con coax tra front-end e Accel_1+, Accel_1-

Chiudere JP3 per simulare gli ingressi

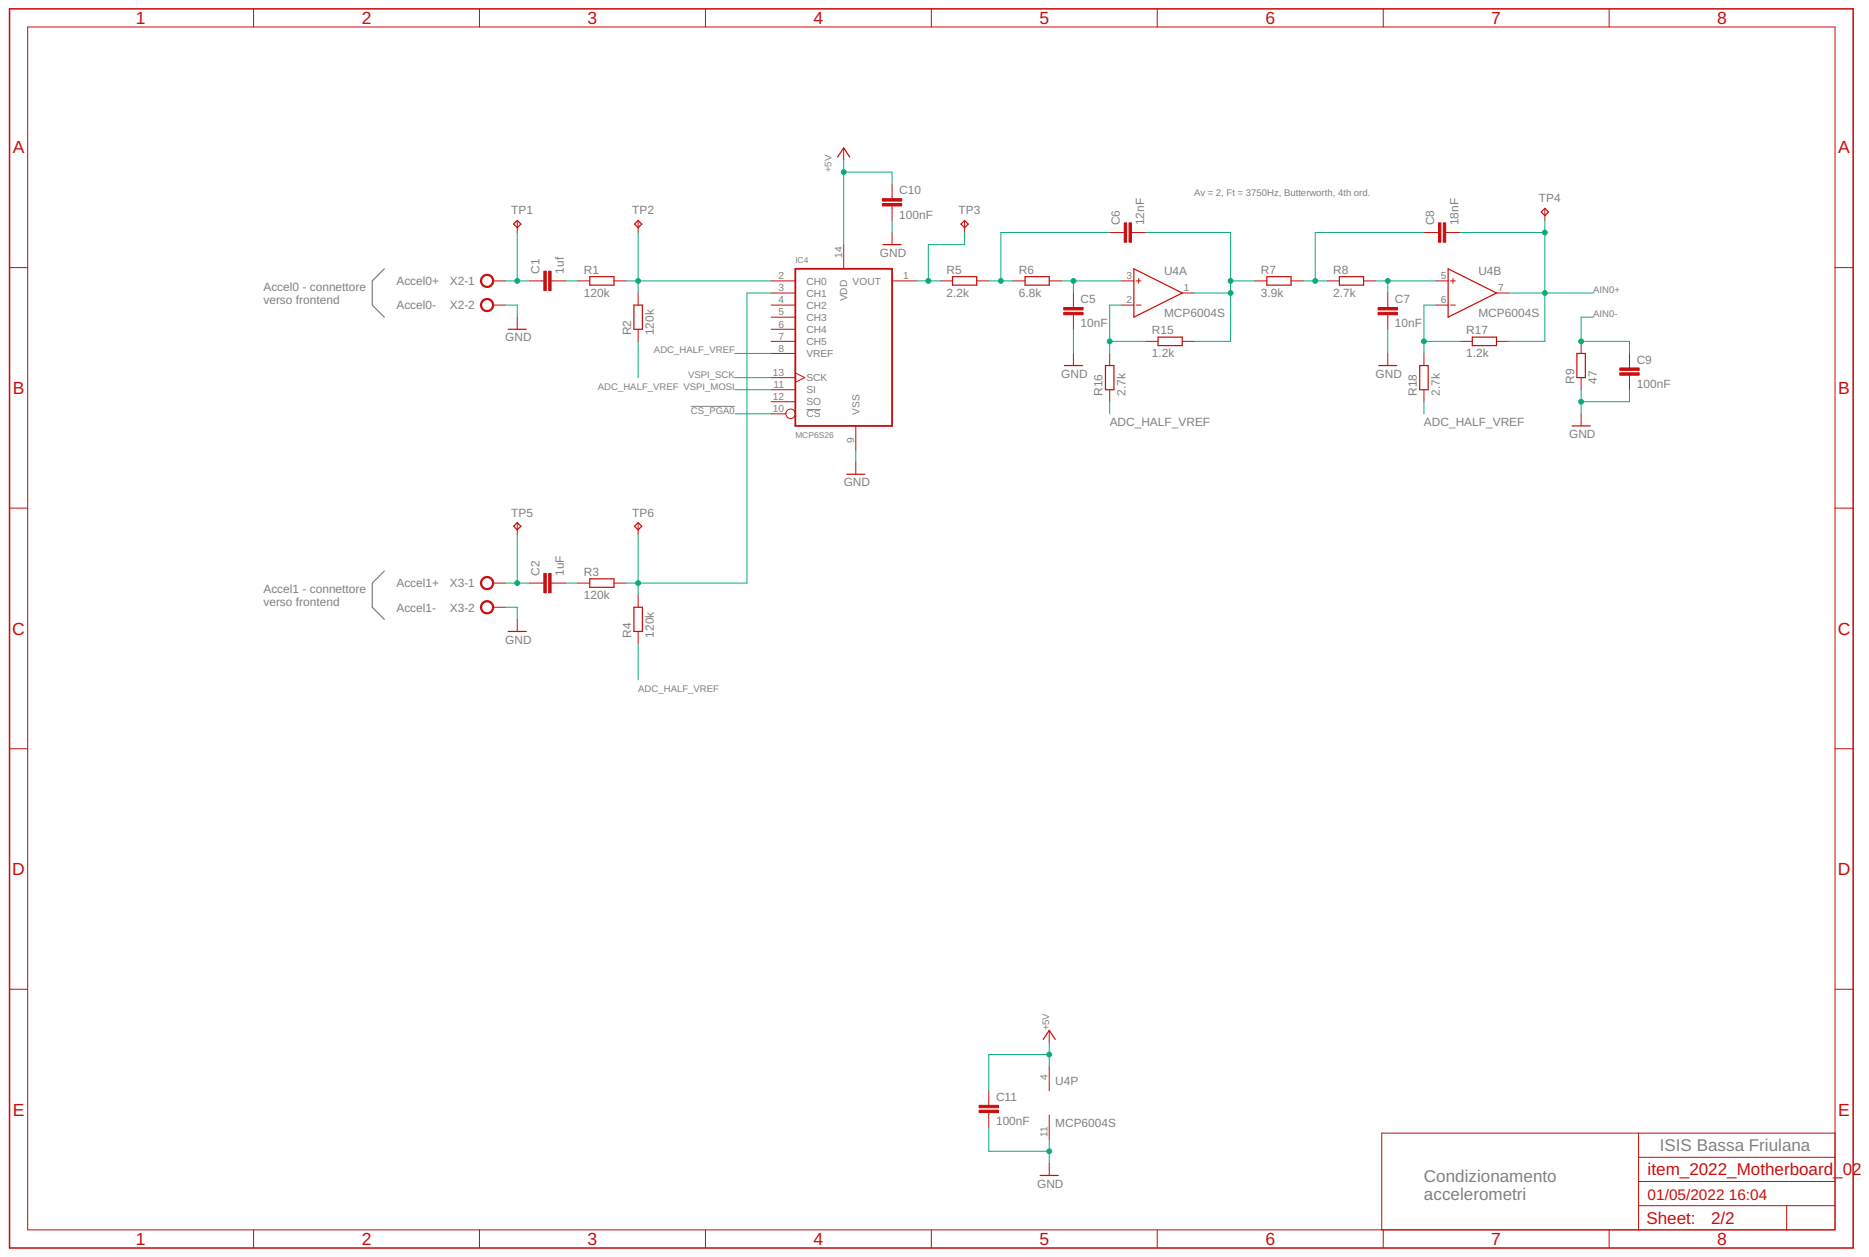
[picture p14: page 2]

Av = 2, Ft = 3750Hz, Butterworth, 4th ord. Accel0 - connettore
