damoreluc/ITEM_2223_git_V7/item_2022_Frontend_02_V7_TOP_Components.pdf

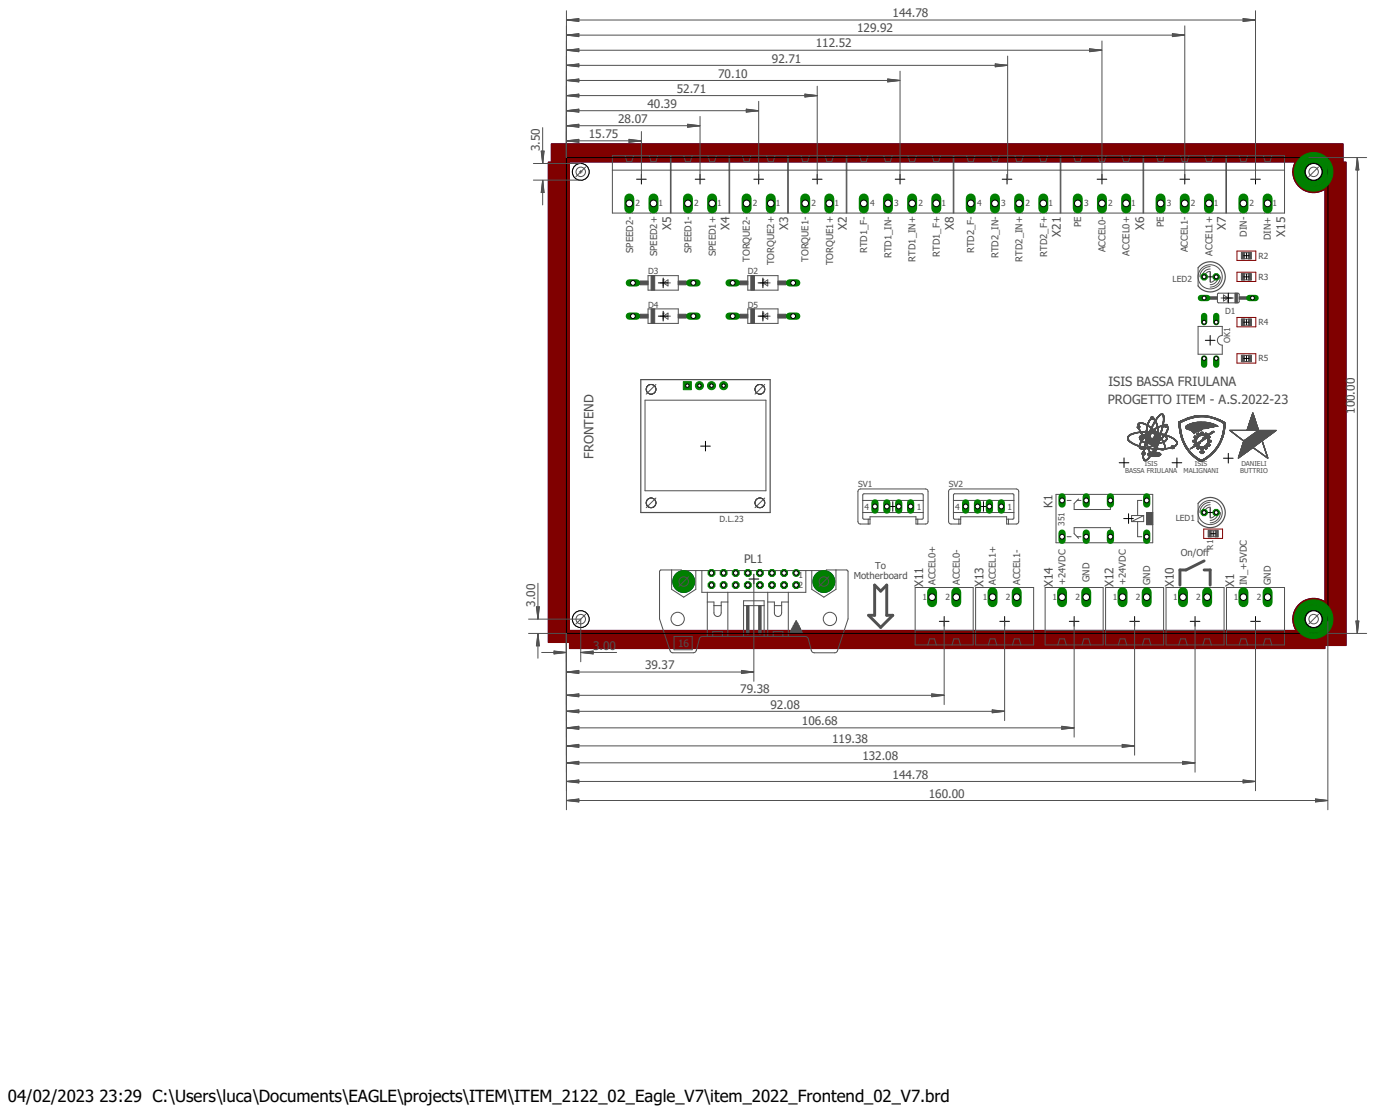
[picture p15: page 1]

On/Off To Motherboard

04/02/2023 23:29 C:\Users\luca\Documents\EAGLE\projects\ITEM\ITEM_2122_02_Eagle_V7\item_2022_Frontend_02_V7.brd
