damoreluc/ITEM_2223_git_V7/item_2022_Frontend_02_bottom_V7.pdf

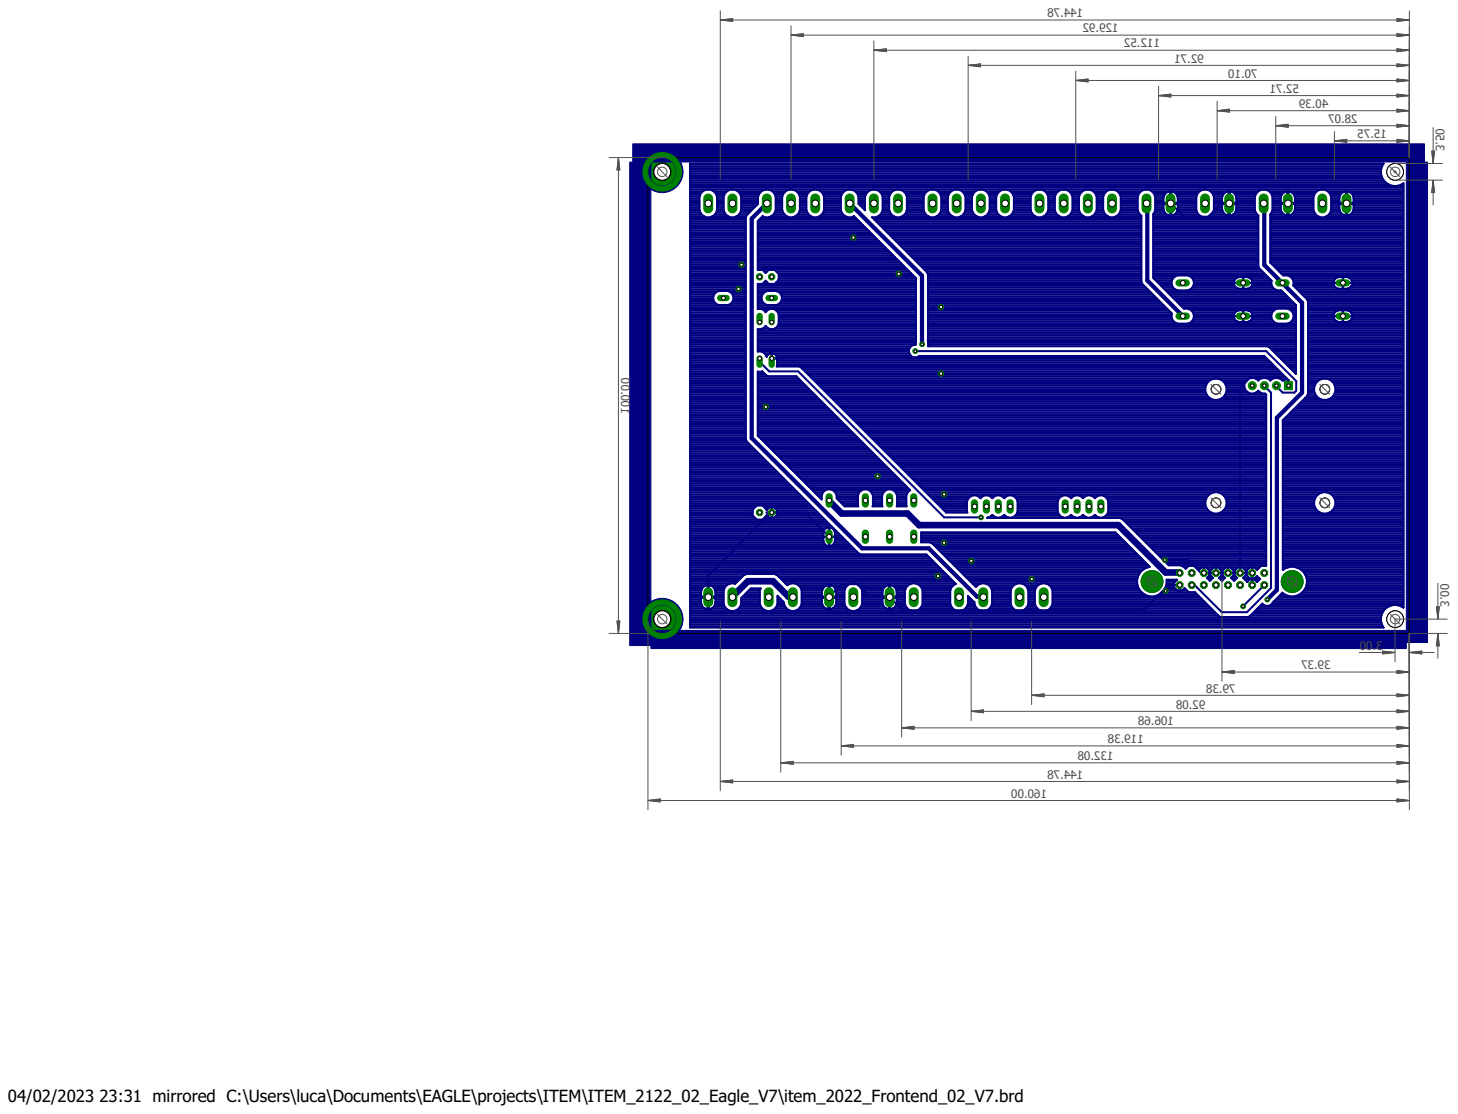
[picture p17: page 1]

04/02/2023 23:31 mirrored C:\Users\luca\Documents\EAGLE\projects\ITEM\ITEM_2122_02_Eagle_V7\item_2022_Frontend_02_V7.brd
