damoreluc/ITEM_2223_git_V7/item_2022_Frontend_02_top_V7.pdf

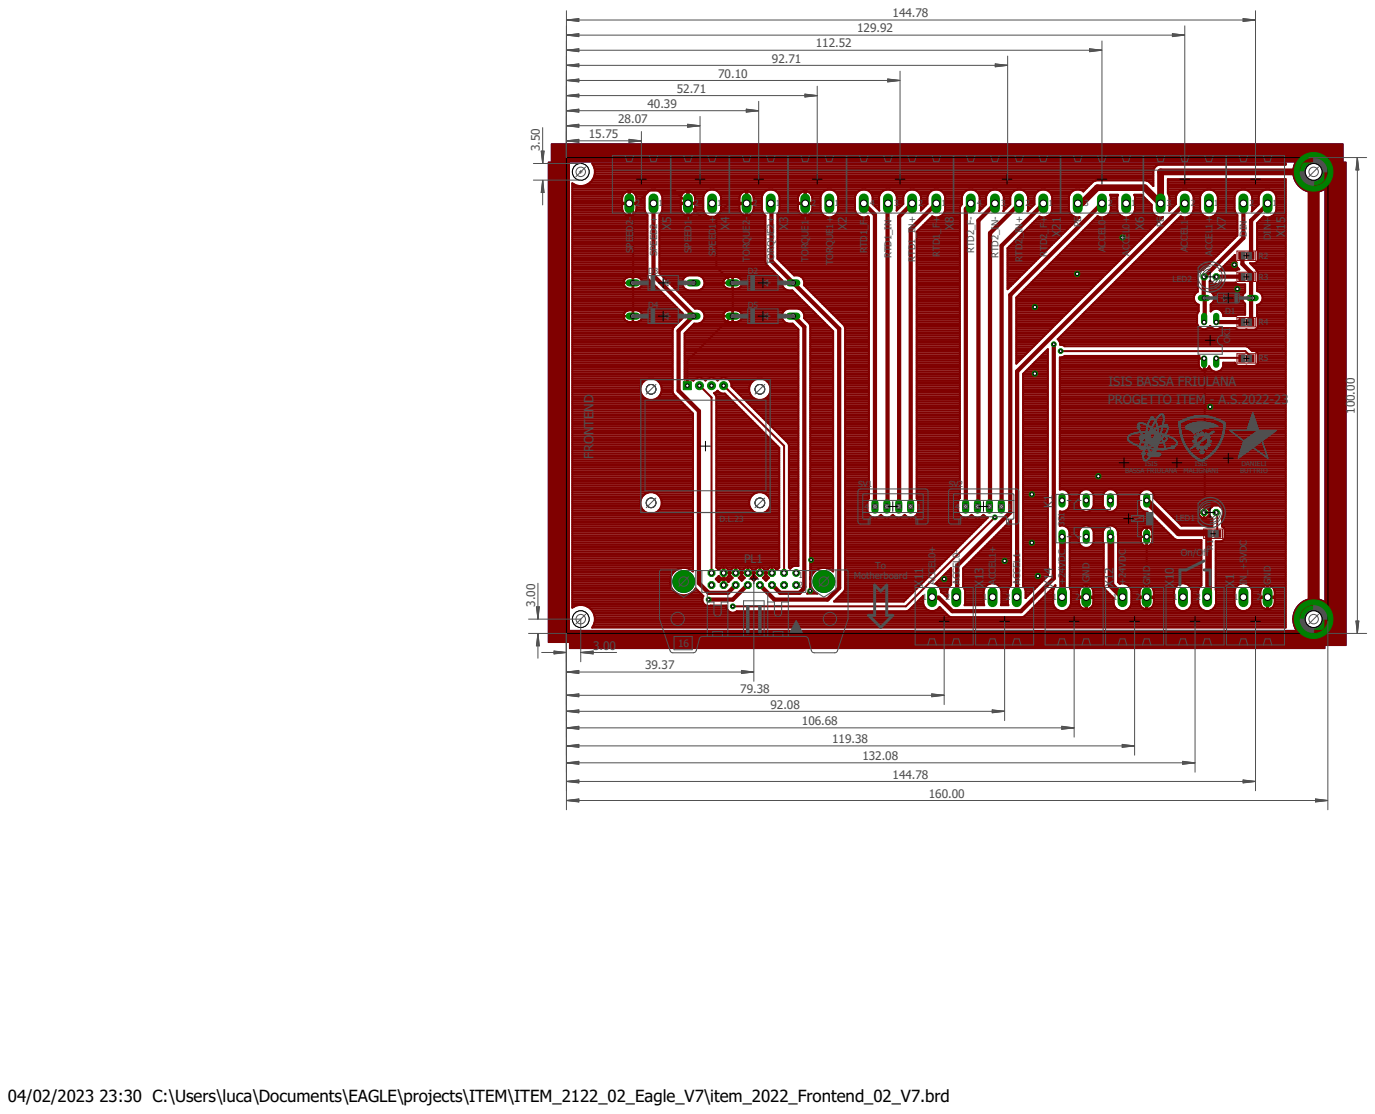
[picture p18: page 1]

ISIS BASSA FRIULANA

On/Off To Motherboard

04/02/2023 23:30 C:\Users\luca\Documents\EAGLE\projects\ITEM\ITEM_2122_02_Eagle_V7\item_2022_Frontend_02_V7.brd
