damoreluc/ITEM_2223_git_V7/item_2022_Motherboard_04_V8.pdf

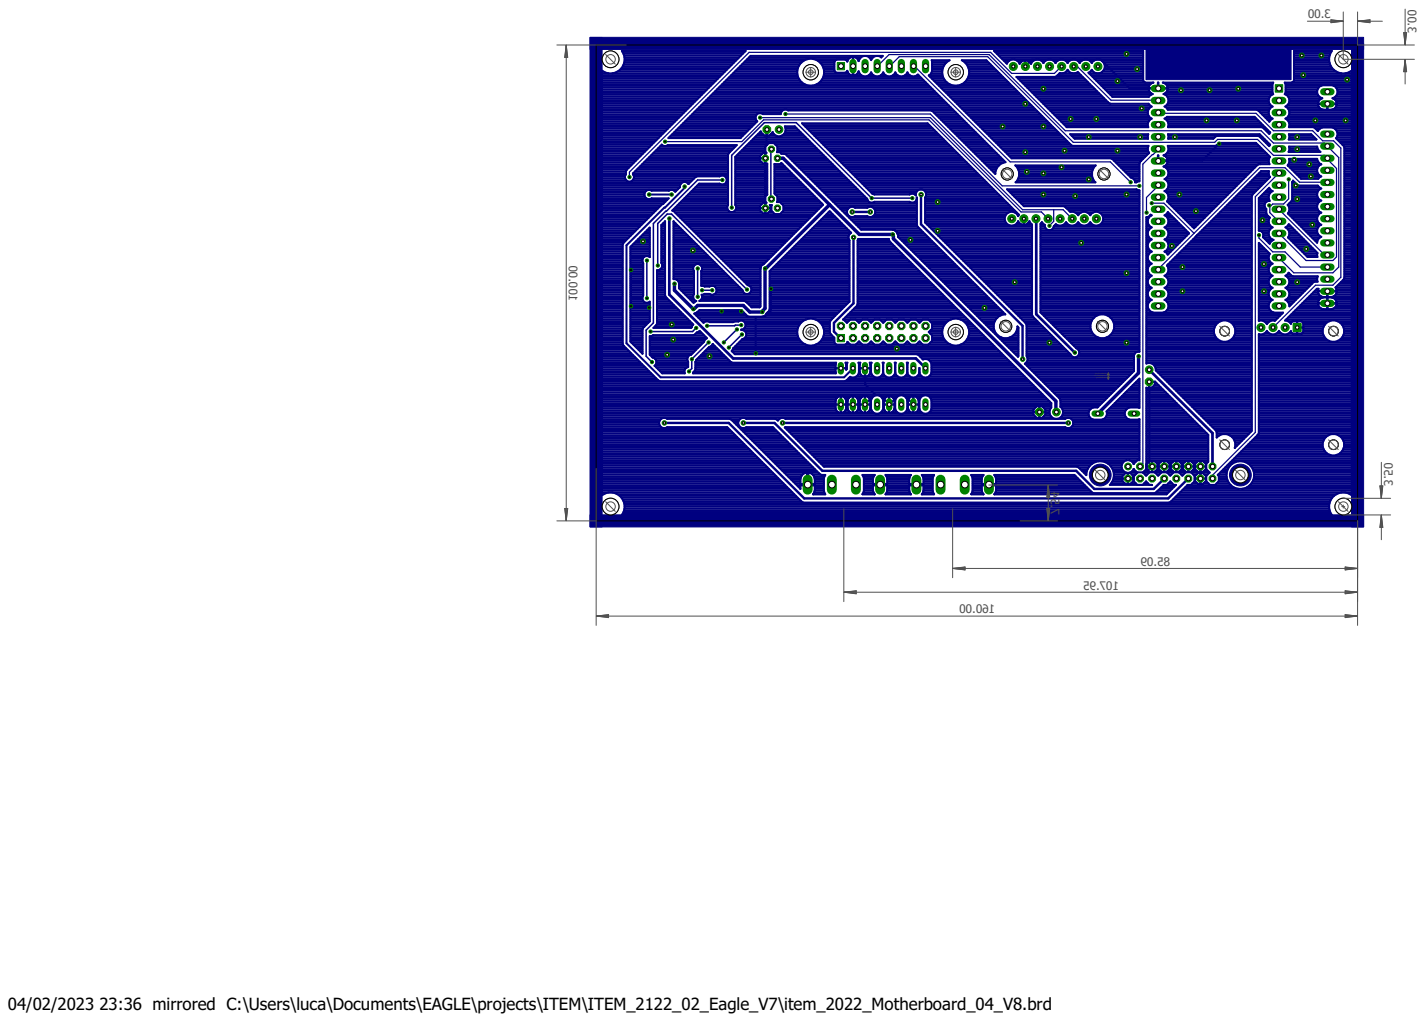
[picture p19: page 1]

04/02/2023 23:36 mirrored C:\Users\luca\Documents\EAGLE\projects\ITEM\ITEM_2122_02_Eagle_V7\item_2022_Motherboard_04_V8.brd
