damoreluc/ITEM_2223_git_V7/item_2022_Motherboard_04_V8_top.pdf

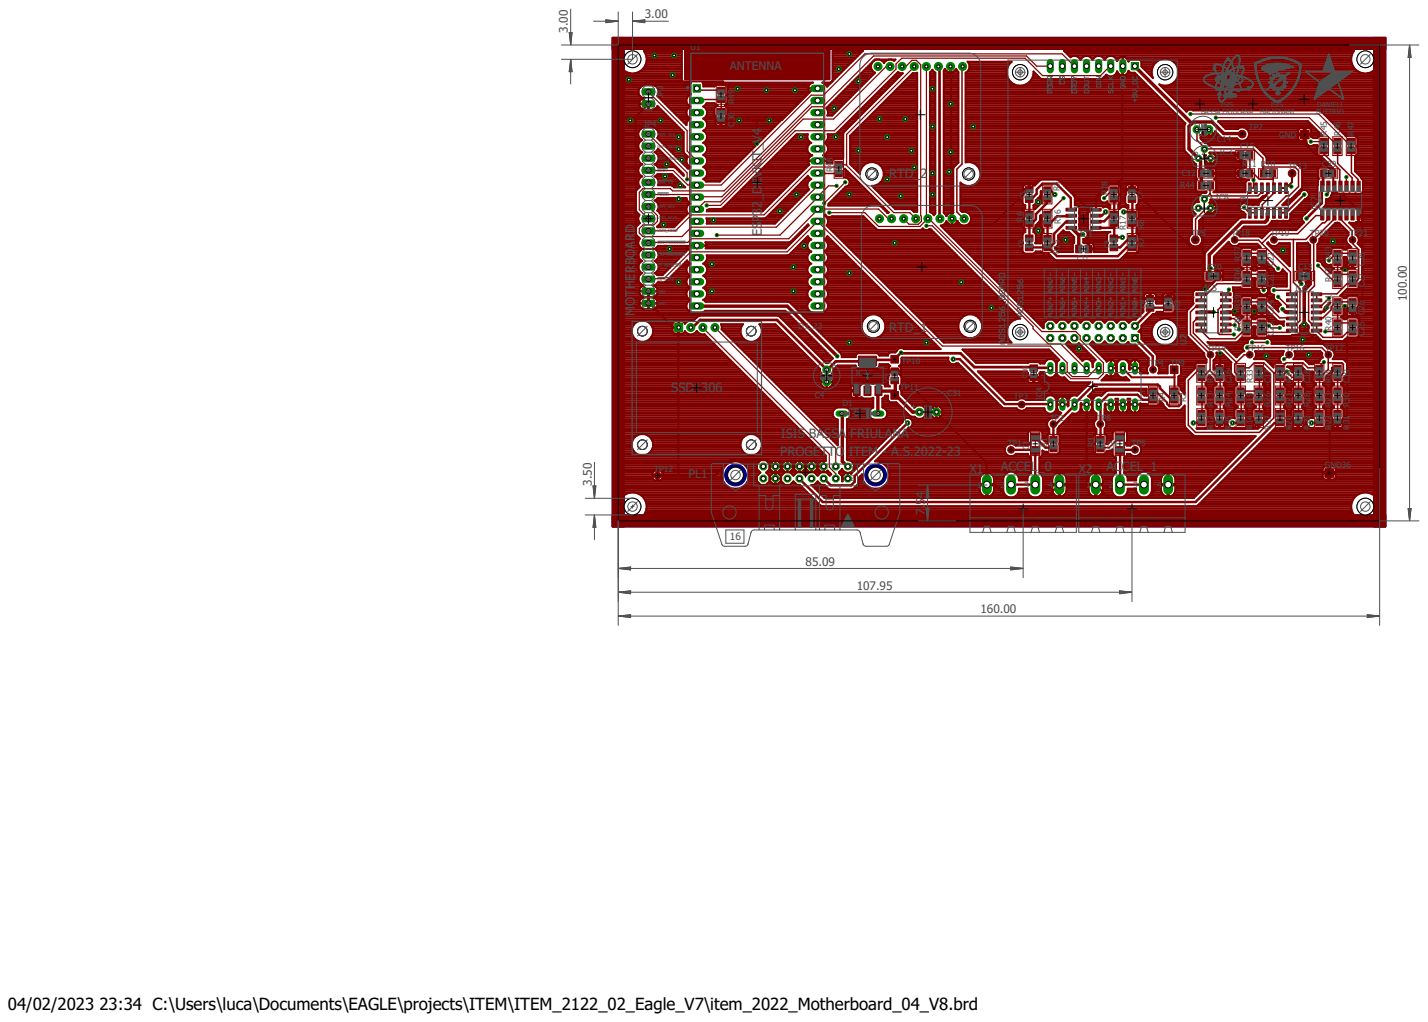
[picture p20: page 1]

04/02/2023 23:34 C:\Users\luca\Documents\EAGLE\projects\ITEM\ITEM_2122_02_Eagle_V7\item_2022_Motherboard_04_V8.brd
