damoreluc/ITEM_2223_git_V7/item_2022_Motherboard_04_V8_BOTTOM.pdf

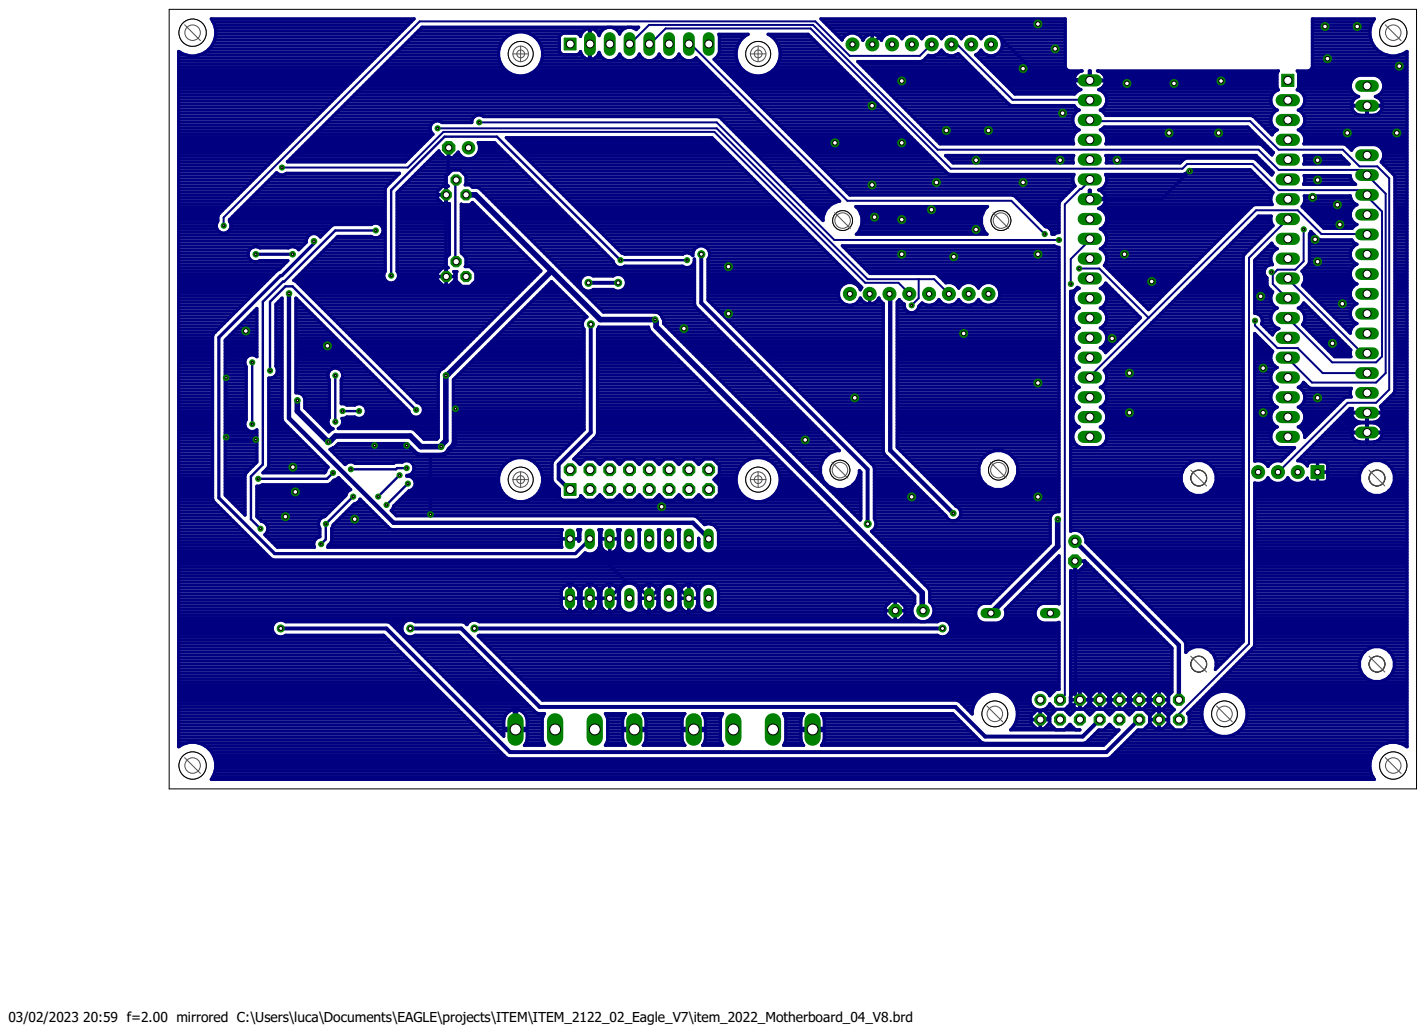
[picture p21: page 1]

03/02/2023 20:59 f=2.00 mirrored C:\Users\luca\Documents\EAGLE\projects\ITEM\ITEM_2122_02_Eagle_V7\item_2022_Motherboard_04_V8.brd
