damoreluc/ITEM_2223_git_V7/item_2022_analog_01a.pdf

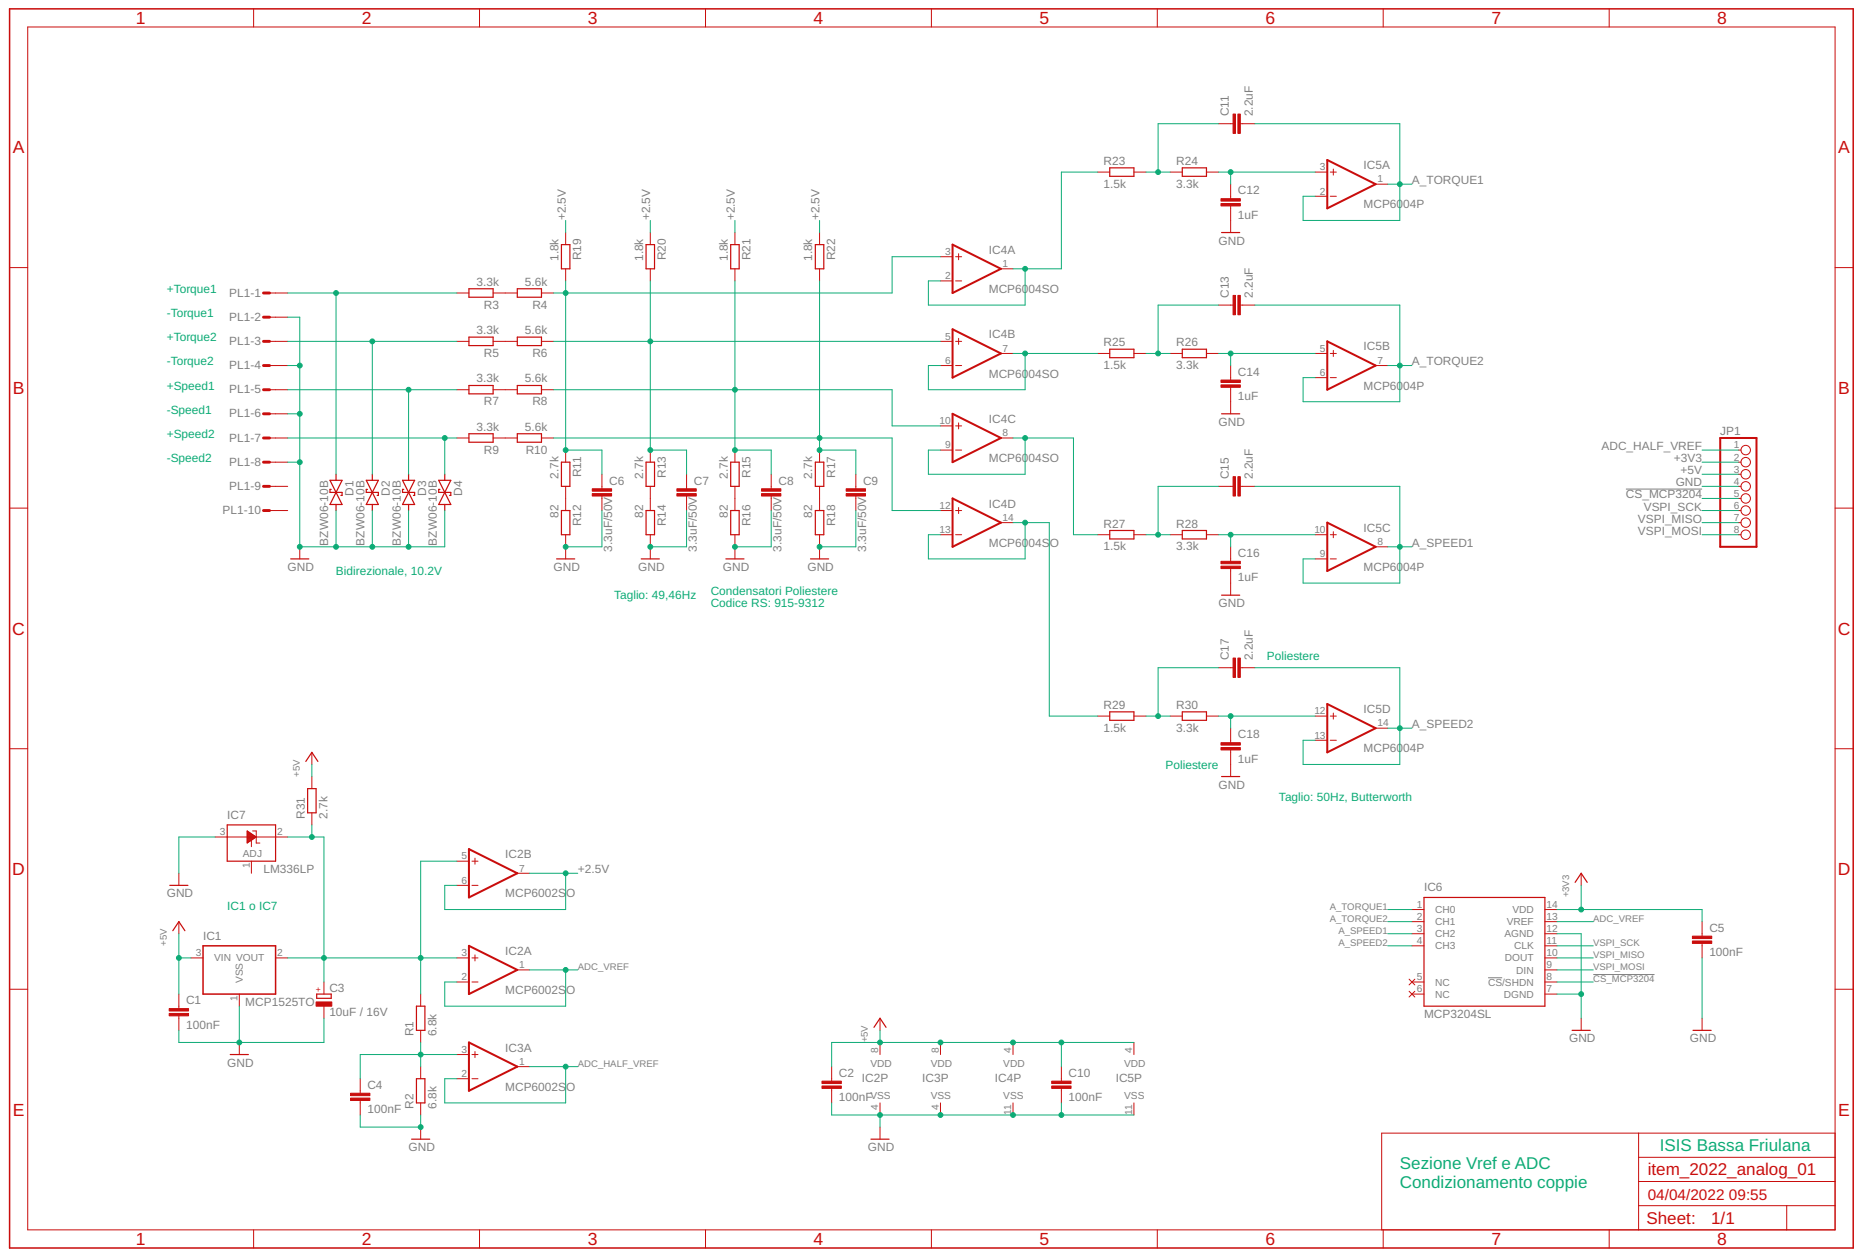
[picture p22: page 1]
