damoreluc/ITEM_2223_git_V7/item_2022_analog_02_bottom.pdf

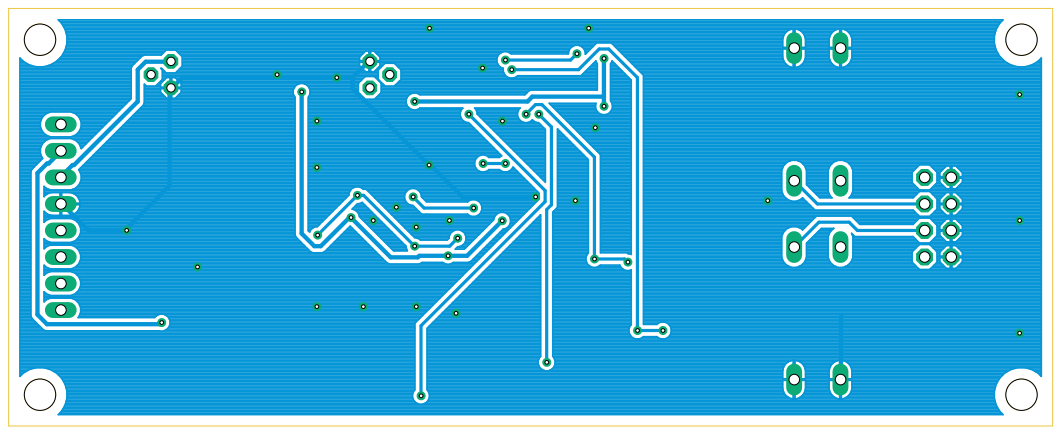
[picture p23: page 1]
