damoreluc/ITEM_2223_git_V7/item_2022_Motherboard_04_V7_PCB_TOP.pdf

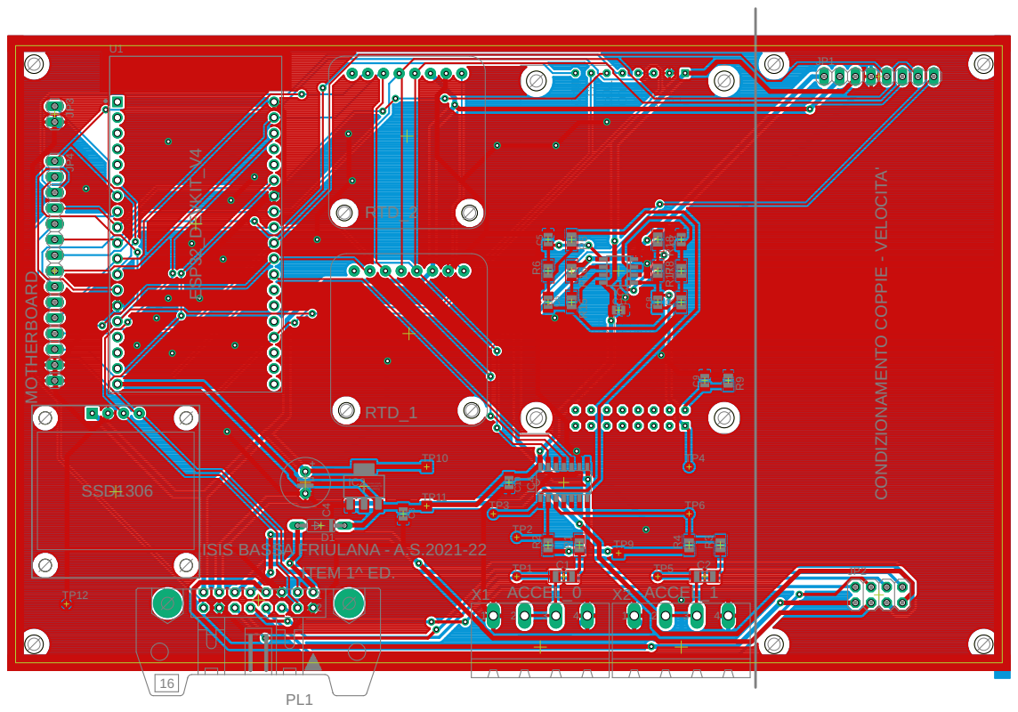
[picture p24: page 1]
