damoreluc/ITEM_2223_git_V7/item_2022_Motherboard_04_V8.brd

## EAGLE design item_2022_Motherboard_04_V8.brd (2023-02-04)

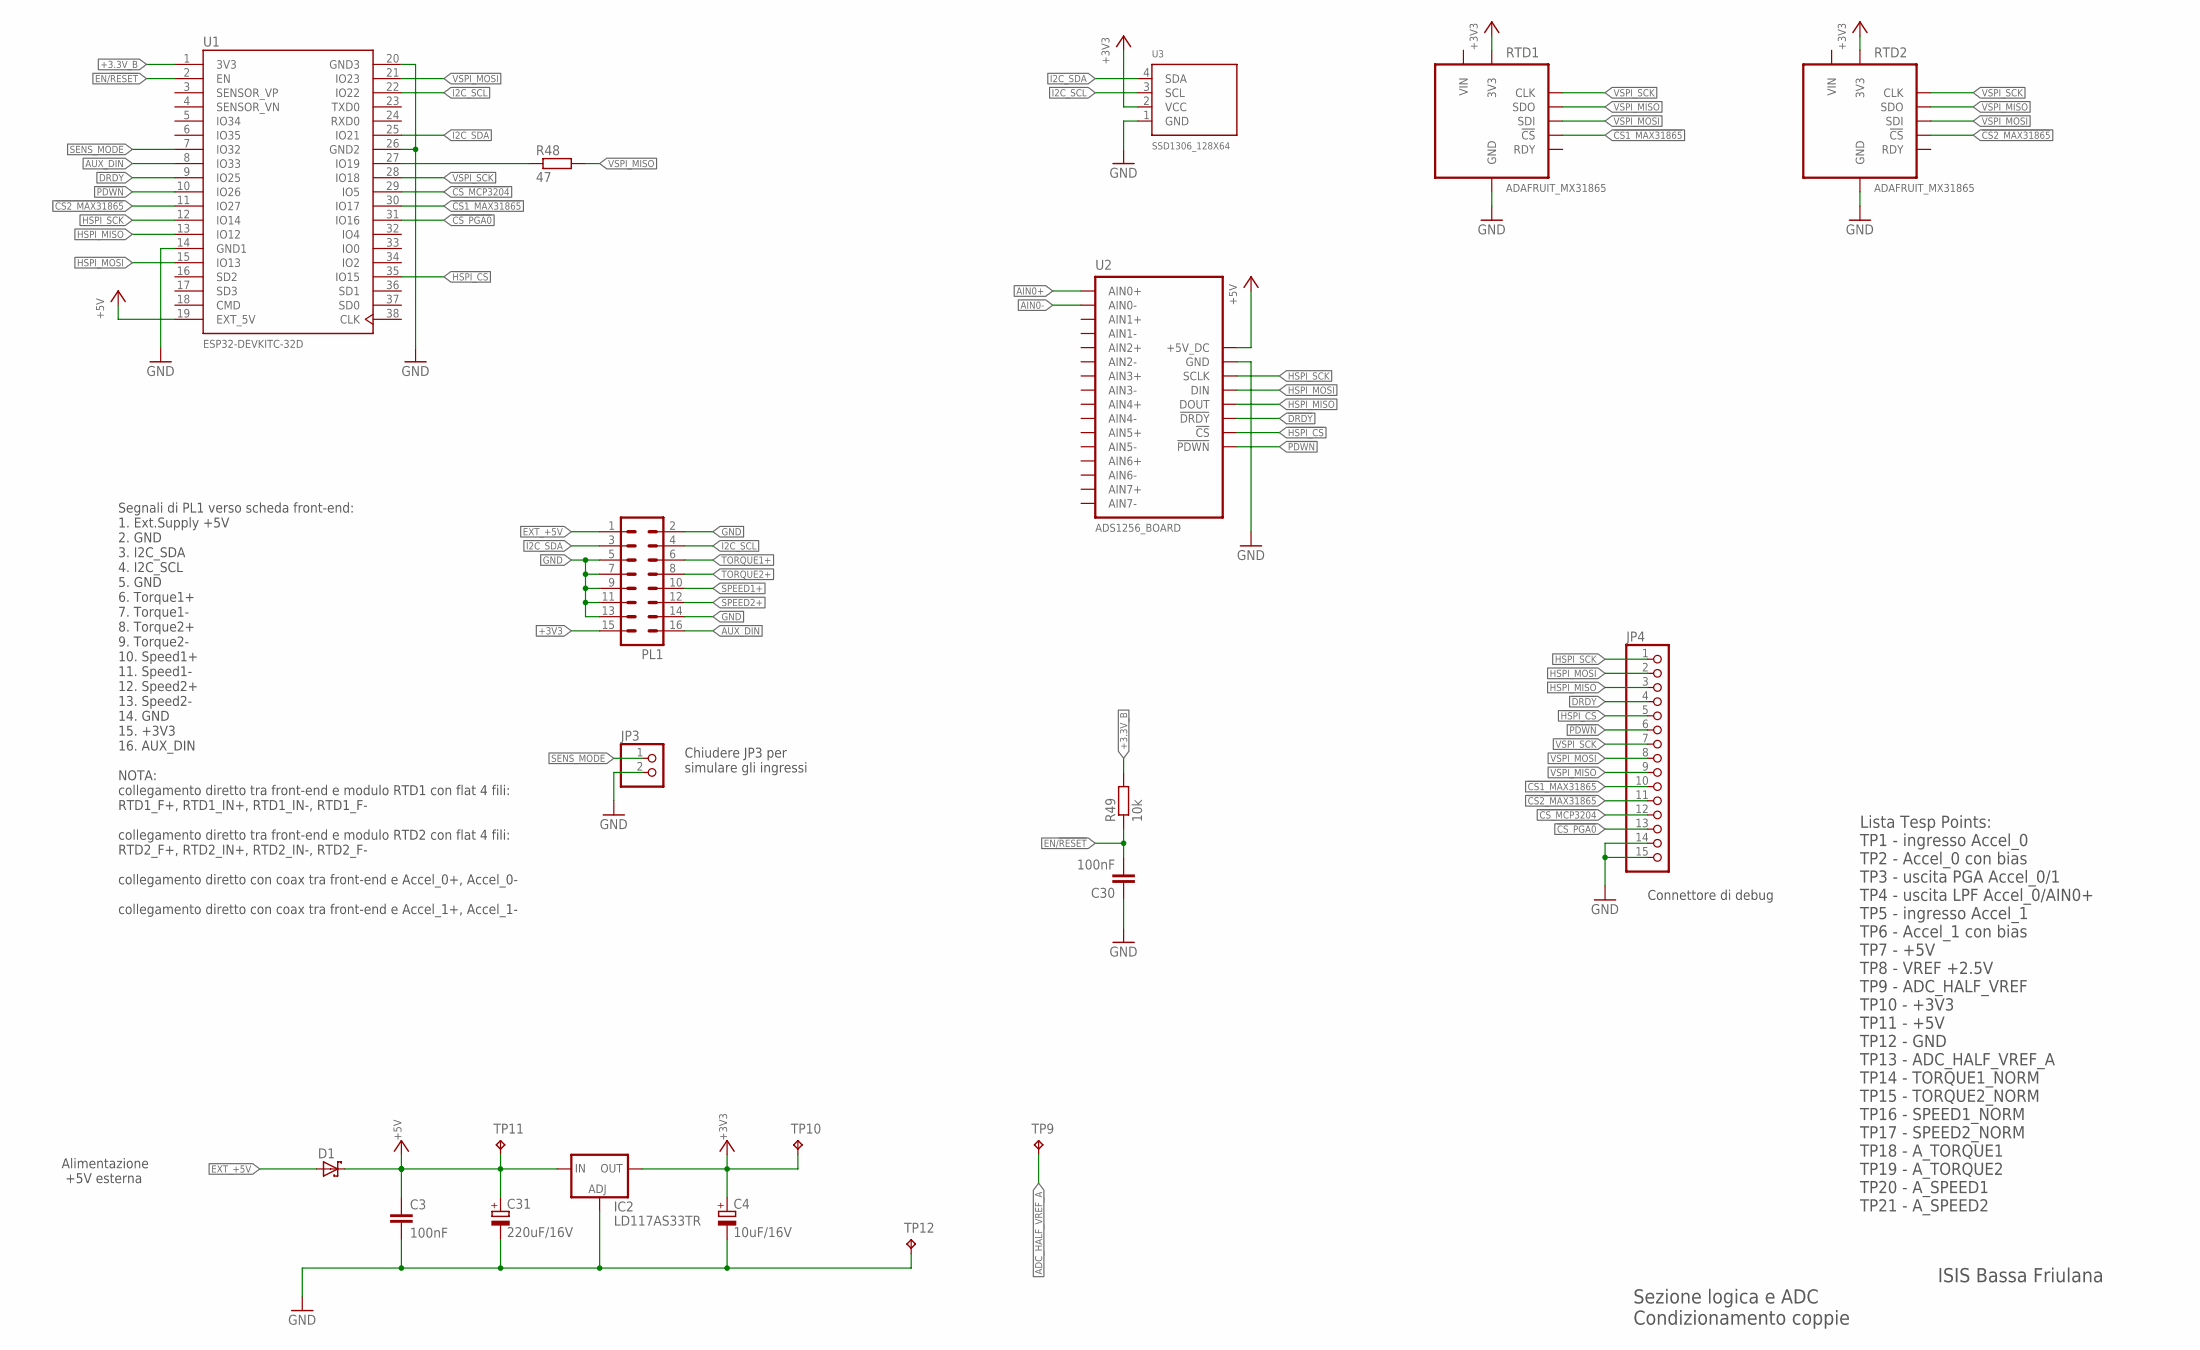
[picture p27: schematic item_2022_Motherboard_04_V8.sch, sheet 1]

Parts:
C3: 100nF; C0805K
C4: 10uF/16V; E2,5-6
C30: 100nF; C0805
C31: 220uF/16V; E3,5-10
D1: SCHOTTKY-DIODEDO35-7; DO35-7
IC2: LD117AS33TR; SOT223
JP3: PINHD-1X2; 1X02
JP4: PINHD-1X15; 1X15
PL1: 16H
R48: 47; R0805
R49: 10k; R0805
RTD1, RTD2: ADAFRUIT_MX31865; ADAFRUIT_MAX31865
TP9, TP10, TP11: TPTP16SQ; TP16SQ
TP12: TPTP14R; TP14R
U1: ESP32-DEVKITC-32D; MODULE_ESP32-DEVKITC-32D
U2: ADS1256_BOARD
U3: SSD1306_128X64; 128X64

Connections:
!CS1_MAX31865!: JP4.10, RTD1.P7 (!CS!), U1.30 (IO17)
!CS2_MAX31865!: JP4.11, RTD2.P7 (!CS!), U1.11 (IO27)
!CS_MCP3204!: JP4.12, U1.29 (IO5); also elsewhere on the board
!CS_PGA0!: JP4.13, U1.31 (IO16); also elsewhere on the board
!DRDY!: JP4.4, U1.9 (IO25), U2.!DRDY!
!HSPI_CS!: JP4.5, U1.35 (IO15), U2.!CS!
!PDWN!: JP4.6, U1.10 (IO26), U2.PDWN (!PDWN!)
+3.3V_B: R49.2, U1.1 (3V3)
+3V3: C4.+, IC2.4 (OUT), PL1.15, RTD1.P3 (3V3), RTD2.P3 (3V3), TP10.TP, U3.2 (VCC); also elsewhere on the board
+5V: C3.1, C31.+, D1.C, IC2.3 (IN), TP11.TP, U1.19 (EXT_5V), U2.5V_DC (+5V_DC); also elsewhere on the board
ADC_HALF_VREF_A: TP9.TP; also elsewhere on the board
AIN0+: U2.AIN0+; also elsewhere on the board
AIN0-: U2.AIN0-; also elsewhere on the board
AUX_DIN: PL1.16, U1.8 (IO33)
EN/!RESET!: C30.2, R49.1, U1.2 (EN)
EXT_+5V: D1.A, PL1.1
GND: C3.2, C4.-, C30.1, C31.-, IC2.1 (ADJ), JP3.2, JP4.14, JP4.15, PL1.2, PL1.5, PL1.7, PL1.9, PL1.11, PL1.13, PL1.14, RTD1.P2 (GND), RTD2.P2 (GND), TP12.TP, U1.14 (GND1), U1.20 (GND3), U1.26 (GND2), U2.GND, U3.1 (GND); also elsewhere on the board
HSPI_MISO: JP4.3, U1.13 (IO12), U2.DOUT
HSPI_MOSI: JP4.2, U1.15 (IO13), U2.DIN
HSPI_SCK: JP4.1, U1.12 (IO14), U2.SCLK
I2C_SCL: PL1.4, U1.22 (IO22), U3.3 (SCL)
I2C_SDA: PL1.3, U1.25 (IO21), U3.4 (SDA)
unnamed: R48.1, U1.27 (IO19)
SENS_MODE: JP3.1, U1.7 (IO32)
SPEED1+: PL1.10; also elsewhere on the board
SPEED2+: PL1.12; also elsewhere on the board
TORQUE1+: PL1.6; also elsewhere on the board
TORQUE2+: PL1.8; also elsewhere on the board
VIN: RTD1.P1 (VIN), RTD2.P1 (VIN)
VSPI_MISO: JP4.9, R48.2, RTD1.P5 (SDO), RTD2.P5 (SDO); also elsewhere on the board
VSPI_MOSI: JP4.8, RTD1.P6 (SDI), RTD2.P6 (SDI), U1.21 (IO23); also elsewhere on the board
VSPI_SCK: JP4.7, RTD1.P4 (CLK), RTD2.P4 (CLK), U1.28 (IO18); also elsewhere on the board

Notes on the sheet:
Sezione logica e ADC Condizionamento coppie
ISIS Bassa Friulana
Lista Tesp Points: TP1 - ingresso Accel_0 TP2 - Accel_0 con bias TP3 - uscita PGA Accel_0/1 TP4 - uscita LPF Accel_0/AIN0+ TP5 - ingresso Accel_1 TP6 - Accel_1 con bias TP7 - +5V TP8 - VREF +2.5V TP9 - ADC_HALF_VREF TP10 - +3V3 TP11 - +5V TP12 - GND TP13 - ADC_HALF_VREF_A TP14 - TORQUE1_NORM TP15 -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
Segnali di PL1 verso scheda front-end: 1. Ext.Supply +5V 2. GND 3. I2C_SDA 4. I2C_SCL 5. GND 6. Torque1+ 7. Torque1- 8. Torque2+ 9. Torque2- 10. Speed1+ 11. Speed1- 12. Speed2+ 13. Speed2- 14. GND 15. +3V3 16. AUX_DIN NOTA: collegamento diretto tra front-end e modulo RTD1 con flat 4 fili: RTD1_F+, 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
Alimentazione +5V esterna
Chiudere JP3 per simulare gli ingressi
Connettore di debug

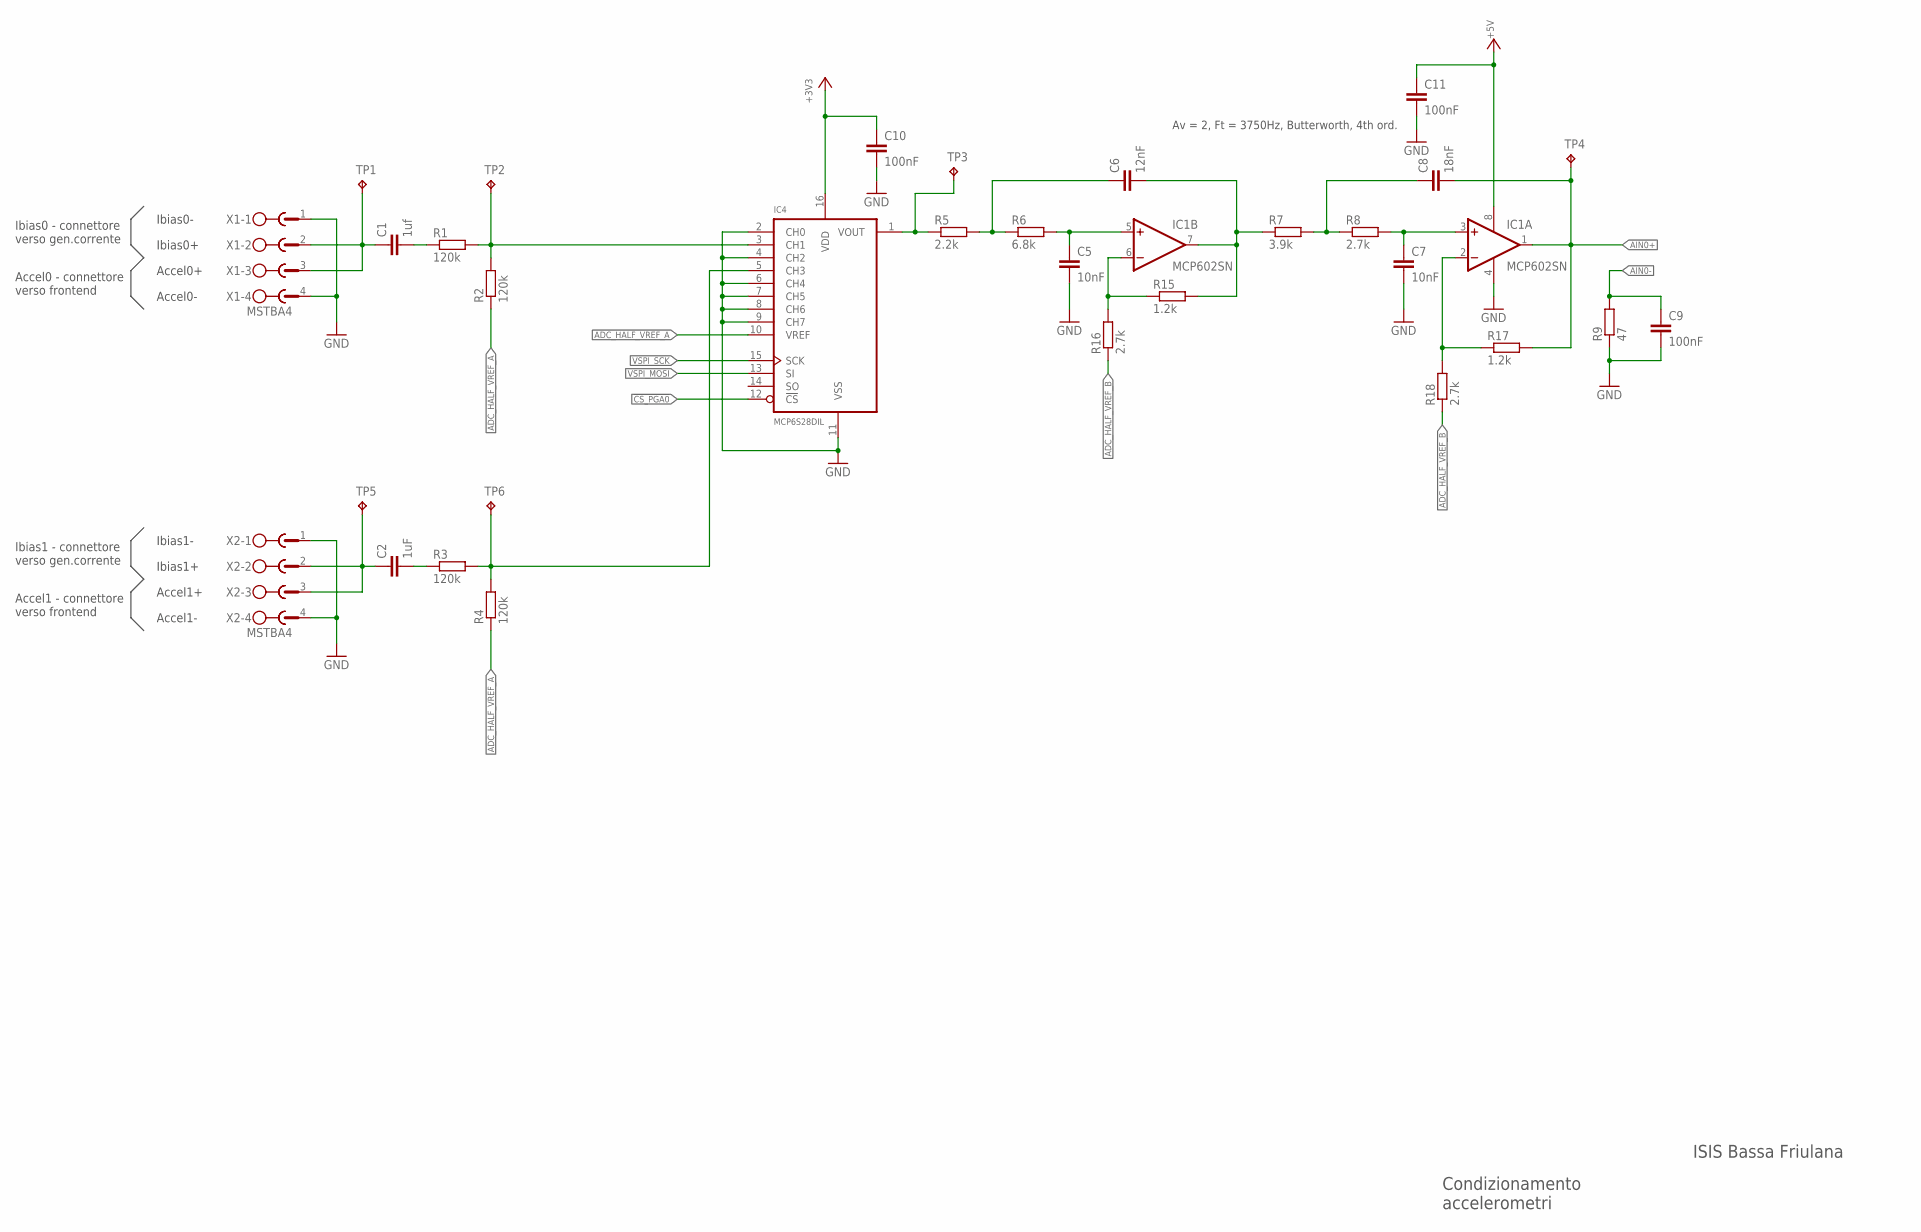
[picture p28: schematic item_2022_Motherboard_04_V8.sch, sheet 2]

Parts:
C1: 1uf; C1206
C2: 1uF; C1206
C5, C7: 10nF; C0805K
C6: 12nF; C0805K
C8: 18nF; C0805K
C9, C10, C11: 100nF; C0805K
IC1: MCP602SN; SO08
IC4: MCP6S28DIL; DIL16
R1, R2, R3, R4: 120k; R0805
R5: 2.2k; R0805
R6: 6.8k; R0805
R7: 3.9k; R0805
R8, R16, R18: 2.7k; R0805
R9: 47; R0805
R15, R17: 1.2k; R0805
TP1, TP2, TP3, TP4, TP5, TP6: TPTP14R; TP14R
X1, X2: MSTBA4

Connections:
!CS_PGA0!: IC4.12 (!CS!); also elsewhere on the board
+3V3: C10.1, IC4.16 (VDD); also elsewhere on the board
+5V: C11.1, IC1.8 (V+); also elsewhere on the board
ADC_HALF_VREF_A: IC4.10 (VREF), R2.1, R4.1; also elsewhere on the board
ADC_HALF_VREF_B: R16.1, R18.1; also elsewhere on the board
AIN0+: C8.2, IC1.1 (OUT), R17.2, TP4.TP; also elsewhere on the board
AIN0-: C9.1, R9.2; also elsewhere on the board
GND: C5.2, C7.2, C9.2, C10.2, C11.2, IC1.4 (V-), IC4.2 (CH0), IC4.4 (CH2), IC4.6 (CH4), IC4.7 (CH5), IC4.8 (CH6), IC4.9 (CH7), IC4.11 (VSS), R9.1, X1.1, X1.4, X2.1, X2.4; also elsewhere on the board
unnamed: C1.1, TP1.TP, X1.2, X1.3
unnamed: C2.1, TP5.TP, X2.2, X2.3
unnamed: IC4.3 (CH1), R1.2, R2.2, TP2.TP
unnamed: IC4.1 (VOUT), R5.1, TP3.TP
unnamed: C1.2, R1.1
unnamed: C2.2, R3.1
unnamed: IC1.6 (-IN), R15.1, R16.2
unnamed: C6.1, R5.2, R6.1
unnamed: C5.1, IC1.5 (+IN), R6.2
unnamed: C6.2, IC1.7 (OUT), R7.1, R15.2
unnamed: C8.1, R7.2, R8.1
unnamed: C7.1, IC1.3 (+IN), R8.2
unnamed: IC4.5 (CH3), R3.2, R4.2, TP6.TP
unnamed: IC1.2 (-IN), R17.1, R18.2
VSPI_MOSI: IC4.13 (SI); also elsewhere on the board
VSPI_SCK: IC4.15 (SCK); also elsewhere on the board

Notes on the sheet:
Condizionamento accelerometri
ISIS Bassa Friulana
Av = 2, Ft = 3750Hz, Butterworth, 4th ord.
Accel0 - connettore verso frontend
Accel0+
Accel0-
Ibias0 - connettore verso gen.corrente
Ibias0-
Ibias0+
Accel1 - connettore verso frontend
Accel1+
Accel1-
Ibias1 - connettore verso gen.corrente
Ibias1-
Ibias1+

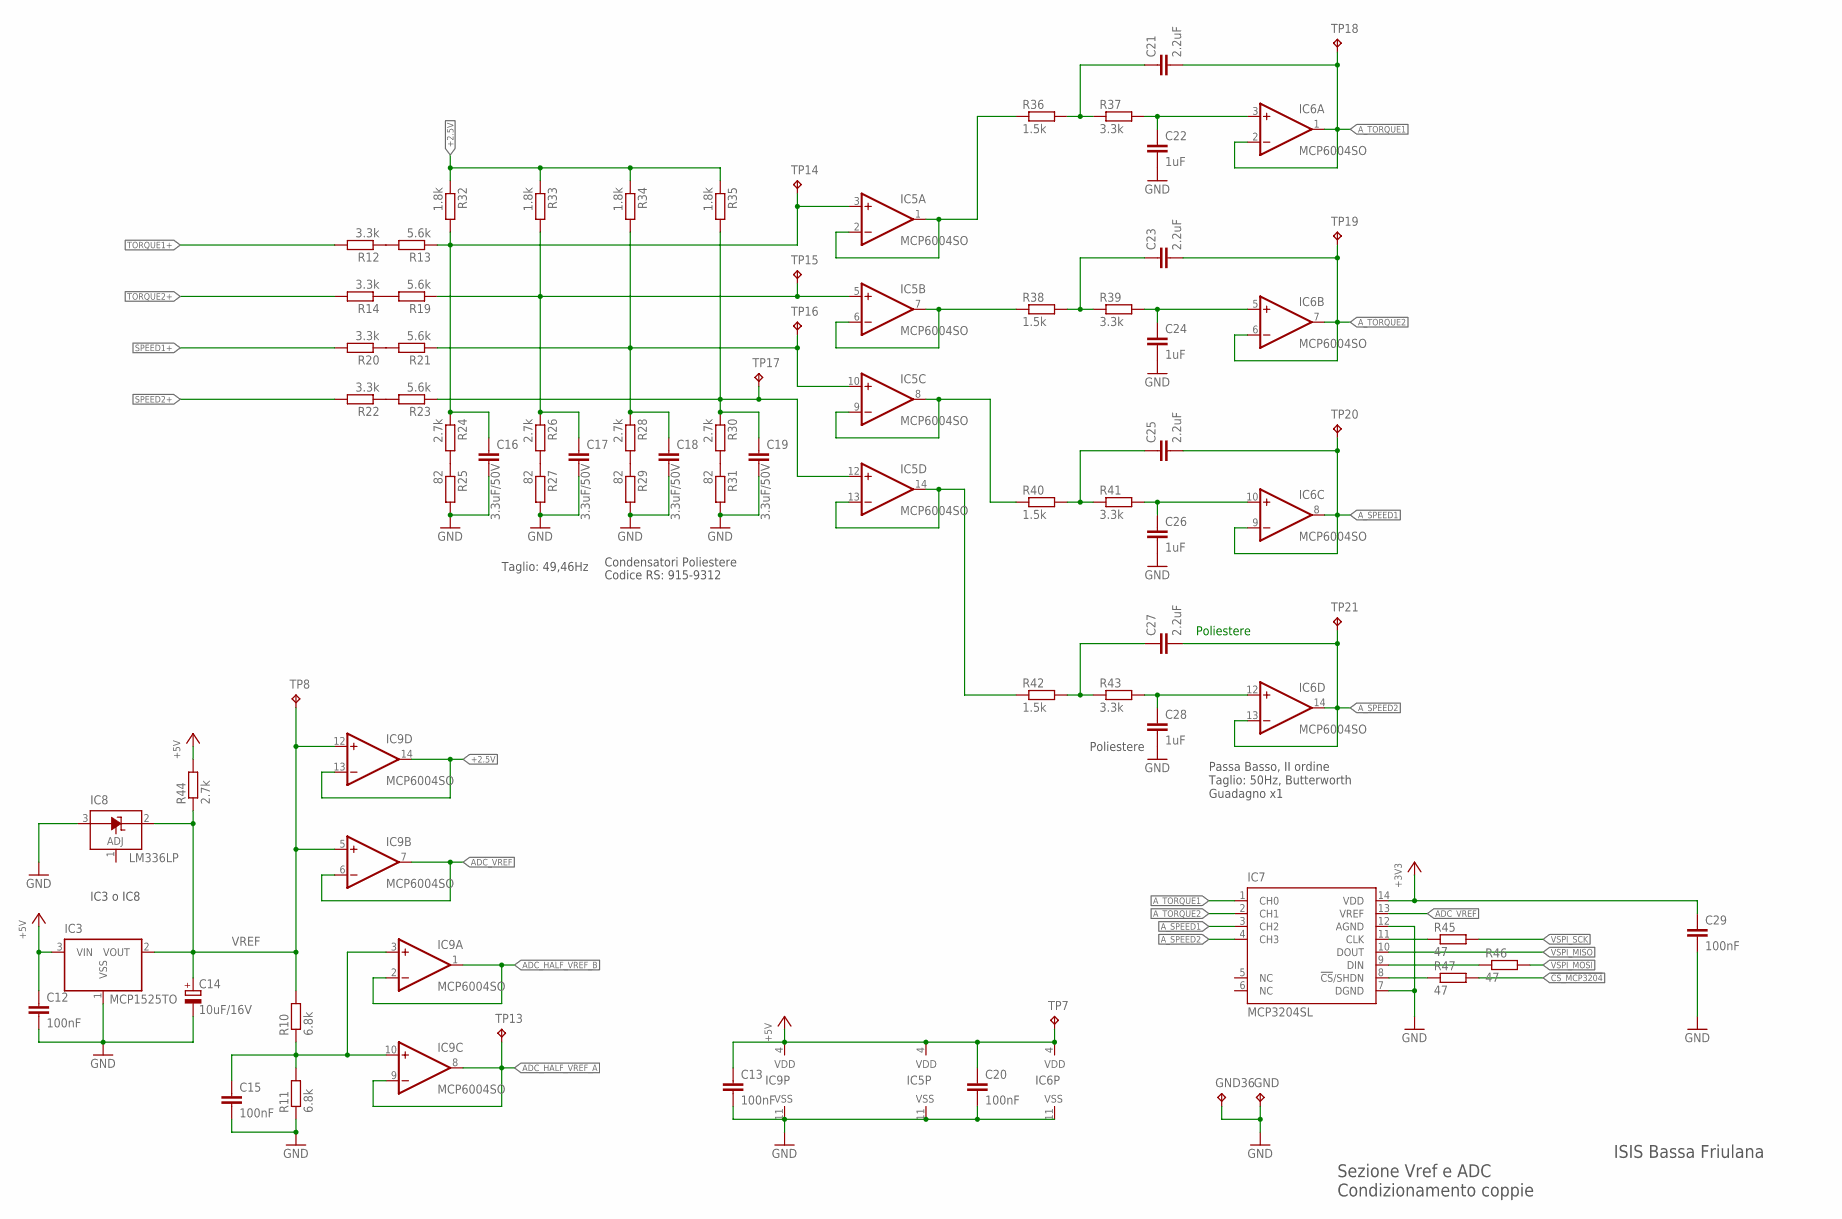
[picture p29: schematic item_2022_Motherboard_04_V8.sch, sheet 3]

Parts:
C12, C13, C15, C20, C29: 100nF; C0805
C14: 10uF/16V; E2,5-6
C16, C17, C18, C19: 3.3uF/50V; C0805
C21, C23, C25, C27: 2.2uF; C0805
C22, C24, C26, C28: 1uF; C0805
GND, GND36: TPTP18SQ; TP18SQ
IC3: MCP1525TO; TO92
IC5, IC6, IC9: MCP6004SO; SO14
IC7: MCP3204SL; SO14
IC8: LM336LP; TO92
R10, R11: 6.8k; R0805
R12, R14, R22, R37, R39, R41, R43: 3.3k; R0805
R13, R19, R21, R23: 5.6k; R0805
R20: 3.3k; M0805
R24, R26, R28, R30, R44: 2.7k; R0805
R25, R27, R29, R31: 82; R0805
R32, R33, R34, R35: 1.8k; R0805
R36, R38, R40, R42: 1.5k; R0805
R45, R46, R47: 47; R0805
TP7, TP8, TP13: TPTP16R; TP16R
TP14, TP15, TP16, TP17, TP18, TP19, TP20, TP21: TPTP14R; TP14R

Connections:
!CS_MCP3204!: R47.2; also elsewhere on the board
+2.5V: IC9.13 (-IN), IC9.14 (OUT), R32.1, R33.1, R34.1, R35.1
+3V3: C29.1, IC7.14 (VDD); also elsewhere on the board
+5V: C12.1, C13.1, C20.1, IC3.3 (VIN), IC5.4 (VDD), IC6.4 (VDD), IC9.4 (VDD), R44.2, TP7.TP; also elsewhere on the board
ADC_HALF_VREF_A: IC9.8 (OUT), IC9.9 (-IN), TP13.TP; also elsewhere on the board
ADC_HALF_VREF_B: IC9.1 (OUT), IC9.2 (-IN); also elsewhere on the board
ADC_VREF: IC7.13 (VREF), IC9.6 (-IN), IC9.7 (OUT)
A_SPEED1: C25.2, IC6.8 (OUT), IC6.9 (-IN), IC7.3 (CH2), TP20.TP
A_SPEED2: C27.2, IC6.13 (-IN), IC6.14 (OUT), IC7.4 (CH3), TP21.TP
A_TORQUE1: C21.2, IC6.1 (OUT), IC6.2 (-IN), IC7.1 (CH0), TP18.TP
A_TORQUE2: C23.2, IC6.6 (-IN), IC6.7 (OUT), IC7.2 (CH1), TP19.TP
GND: C12.2, C13.2, C14.-, C15.2, C16.2, C17.2, C18.2, C19.2, C20.2, C22.2, C24.2, C26.2, C28.2, C29.2, GND.TP, GND36.TP, IC3.1 (VSS), IC5.11 (VSS), IC6.11 (VSS), IC7.7 (DGND), IC7.12 (AGND), IC8.3 (A), IC9.11 (VSS), R11.1, R25.2, R27.2, R29.2, R31.2; also elsewhere on the board
unnamed: C15.1, IC9.3 (+IN), IC9.10 (+IN), R10.1, R11.2
unnamed: R12.1, R13.2
unnamed: R14.1, R19.2
unnamed: R20.1, R21.2
unnamed: R22.1, R23.2
unnamed: R24.2, R25.1
unnamed: C16.1, IC5.3 (+IN), R13.1, R24.1, R32.2, TP14.TP
unnamed: R26.2, R27.1
unnamed: R28.2, R29.1
unnamed: R30.2, R31.1
unnamed: C17.1, IC5.5 (+IN), R19.1, R26.1, R33.2, TP15.TP
unnamed: C18.1, IC5.10 (+IN), R21.1, R28.1, R34.2, TP16.TP
unnamed: C19.1, IC5.12 (+IN), R23.1, R30.1, R35.2, TP17.TP
unnamed: IC5.1 (OUT), IC5.2 (-IN), R36.1
unnamed: IC5.6 (-IN), IC5.7 (OUT), R38.1
unnamed: IC5.8 (OUT), IC5.9 (-IN), R40.1
unnamed: IC5.13 (-IN), IC5.14 (OUT), R42.1
unnamed: C21.1, R36.2, R37.1
unnamed: C22.1, IC6.3 (+IN), R37.2
unnamed: C23.1, R38.2, R39.1
unnamed: C24.1, IC6.5 (+IN), R39.2
unnamed: C25.1, R40.2, R41.1
unnamed: C26.1, IC6.10 (+IN), R41.2
unnamed: C27.1, R42.2, R43.1
unnamed: C28.1, IC6.12 (+IN), R43.2
unnamed: IC7.11 (CLK), R45.1
unnamed: IC7.9 (DIN), R46.1
unnamed: IC7.8 (!CS!/SHDN), R47.1
SPEED1+: R20.2; also elsewhere on the board
SPEED2+: R22.2; also elsewhere on the board
TORQUE1+: R12.2; also elsewhere on the board
TORQUE2+: R14.2; also elsewhere on the board
VREF: C14.+, IC3.2 (VOUT), IC8.2 (C), IC9.5 (+IN), IC9.12 (+IN), R10.2, R44.1, TP8.TP
VSPI_MISO: IC7.10 (DOUT); also elsewhere on the board
VSPI_MOSI: R46.2; also elsewhere on the board
VSPI_SCK: R45.2; also elsewhere on the board

Notes on the sheet:
Sezione Vref e ADC Condizionamento coppie
ISIS Bassa Friulana
Condensatori Poliestere
Passa Basso, II ordine Taglio: 50Hz, Butterworth Guadagno x1
Poliestere
Taglio: 49,46Hz
Codice RS: 915-9312
IC3 o IC8

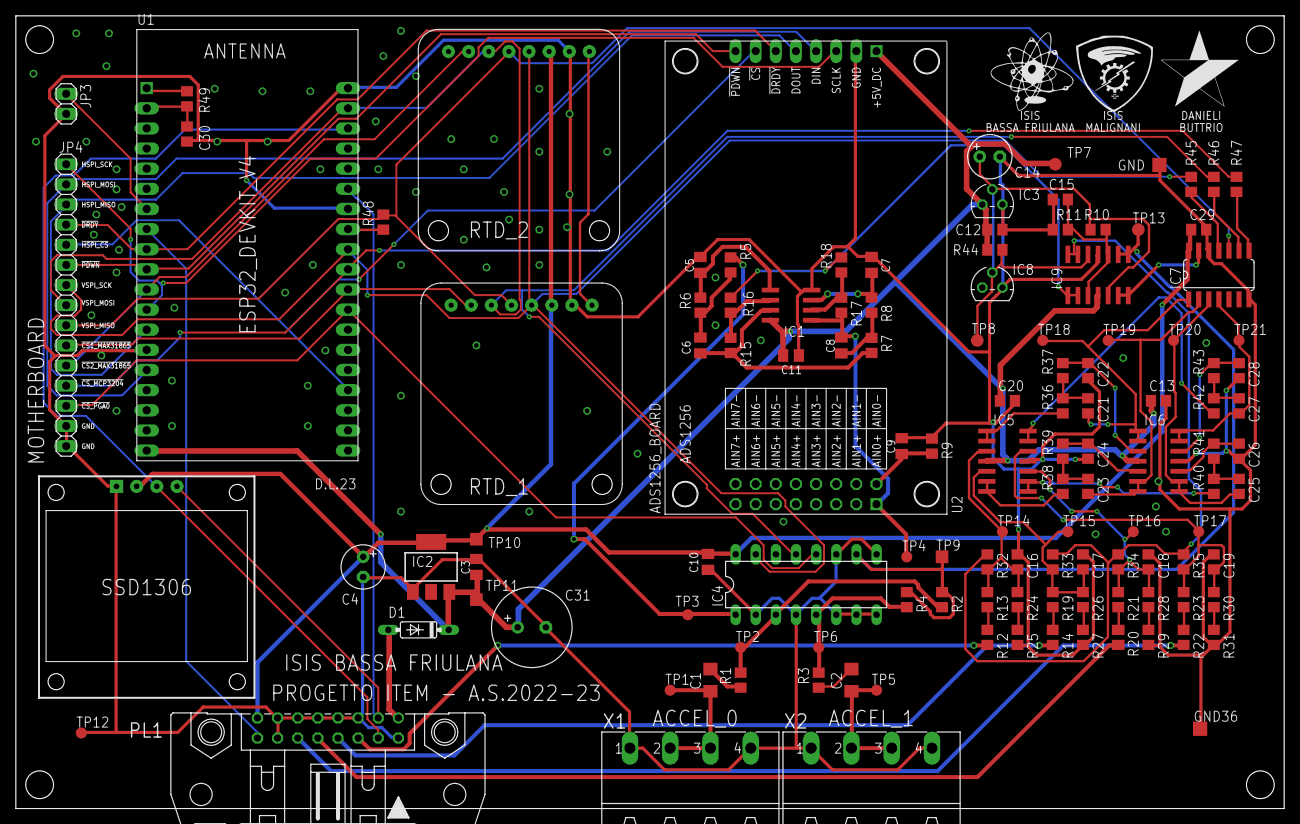
[picture p30: board item_2022_Motherboard_04_V8.brd from above]

Board: 2 copper layers, 160.0 x 100.0 mm, 126 parts (1 on the bottom side), 82 nets.

Other parts of the board:
U$1: BASSA
U$2: UDINE
U$3: DANIELI
