damoreluc/ITEM_2223_git_V7/item_2022_Frontend_02_V7.brd

## EAGLE design item_2022_Frontend_02_V7.brd (2023-02-04)

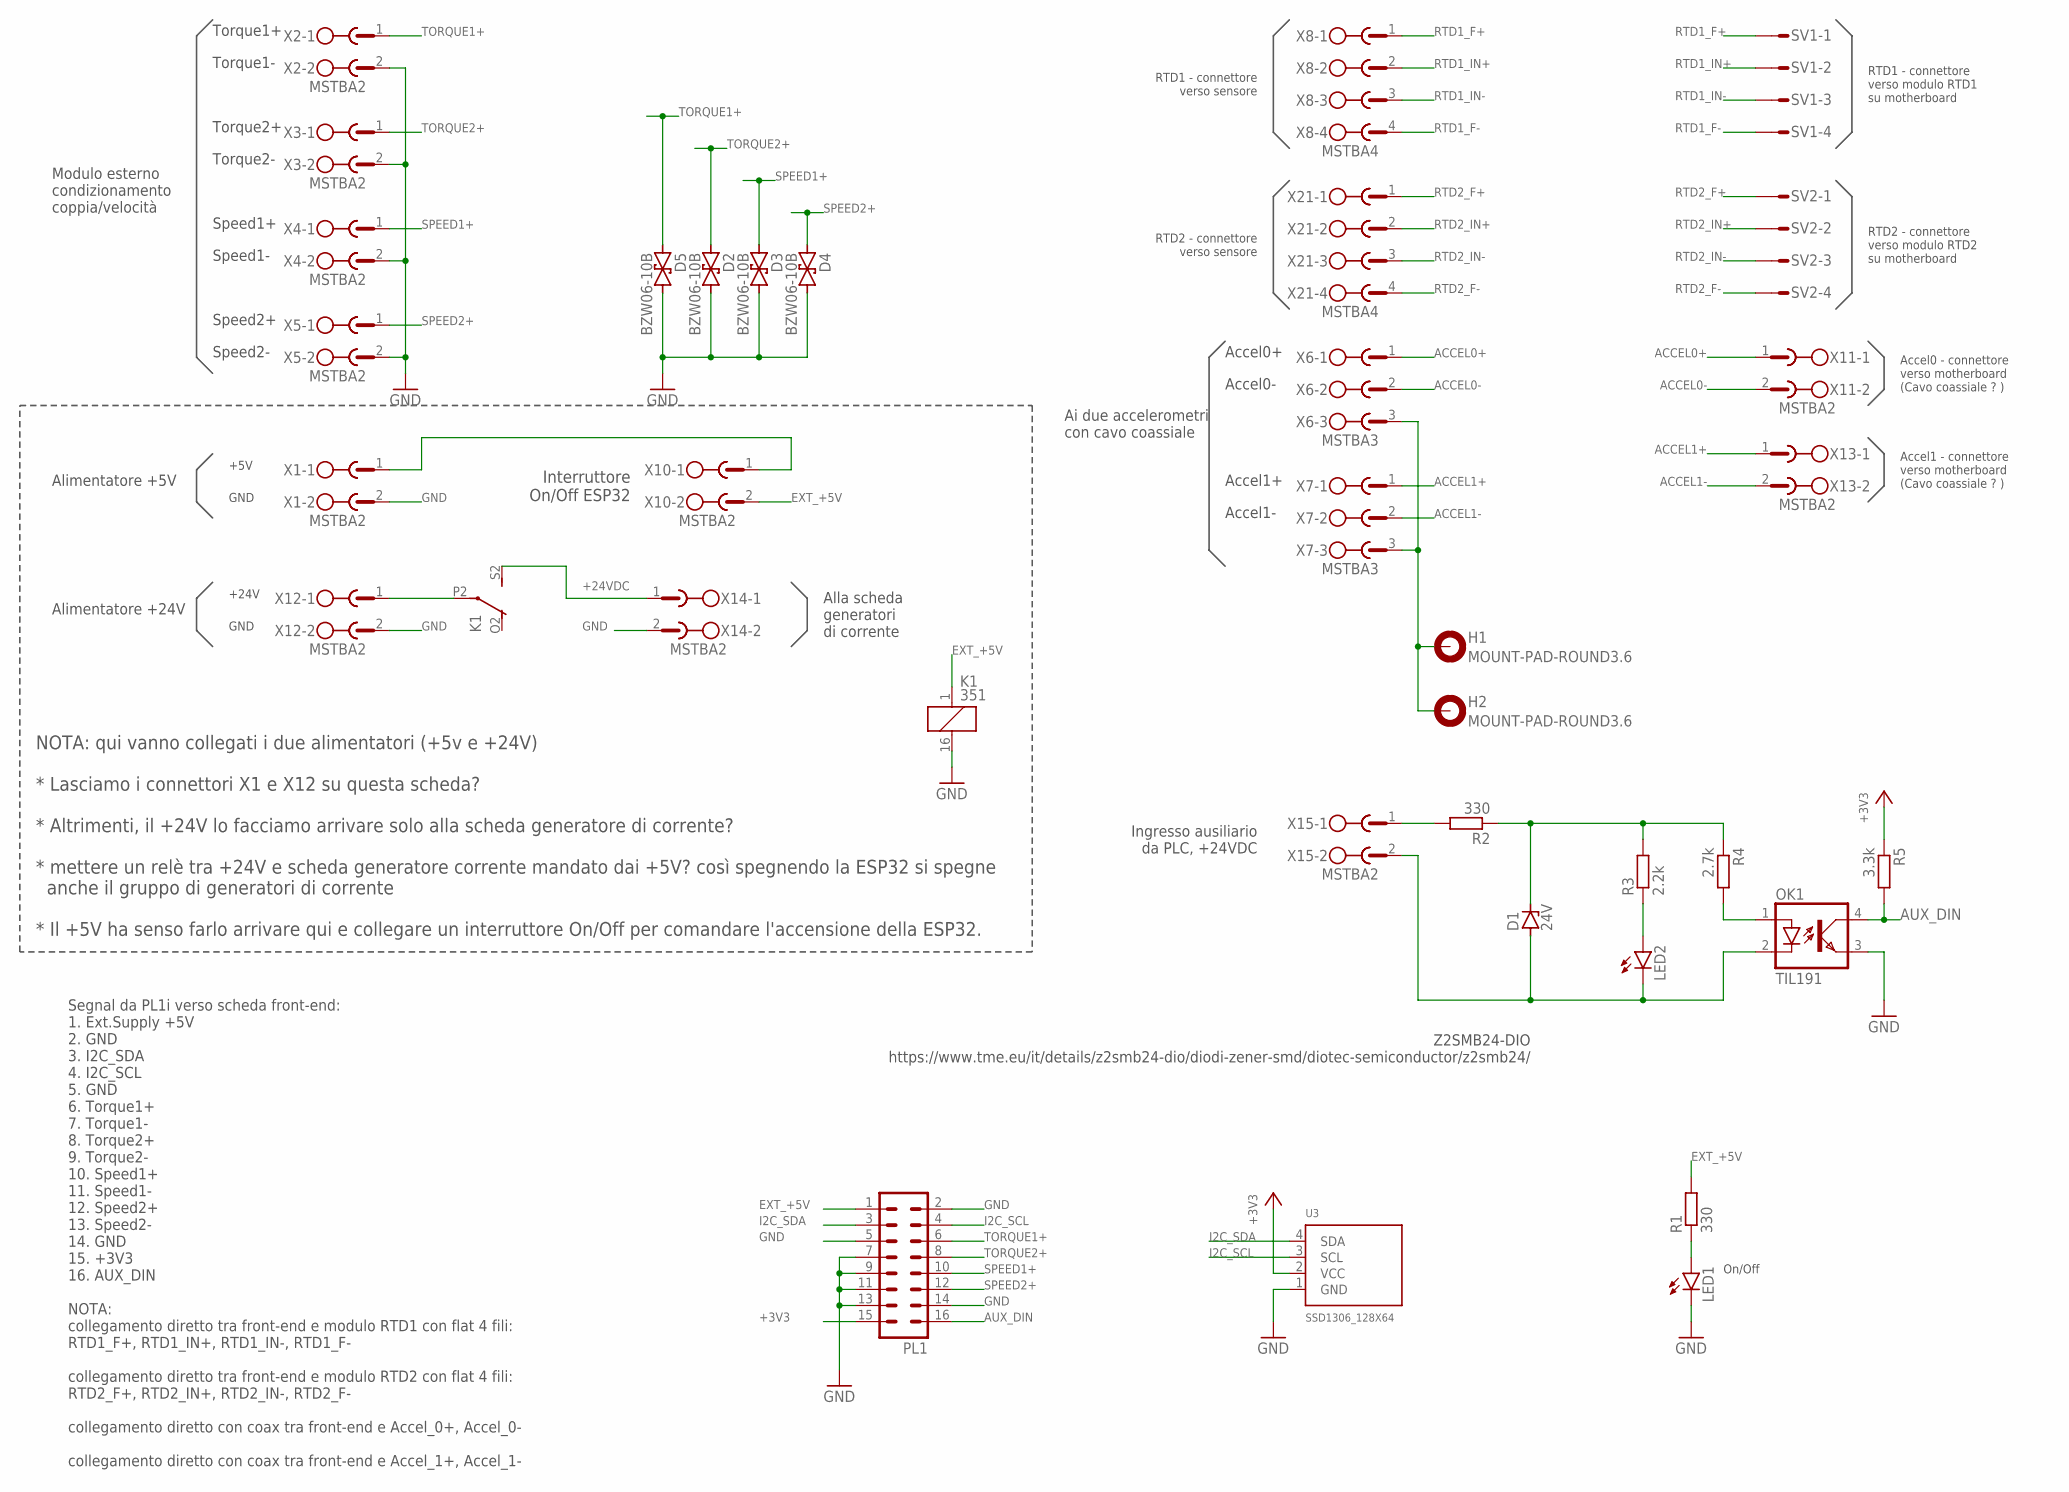
[picture p31: schematic item_2022_Frontend_02_V7.sch]

Parts:
D1: 24V; DO35Z10
D2, D3, D4, D5: BZW06-10B; F126Z12
H1, H2: MOUNT-PAD-ROUND3.6; 3,6-PAD
K1: 351
LED1, LED2: LED5MM
OK1: TIL191; DIL04
PL1: 16H
R1, R2: 330; R0805
R3: 2.2k; R0805
R4: 2.7k; R0805
R5: 3.3k; R0805
SV1, SV2: S04P
U3: SSD1306_128X64; 128X64
X1, X2, X3, X4, X5, X10, X11, X12, X13, X14, X15: MSTBA2
X6, X7: MSTBA3
X8, X21: MSTBA4

Connections:
+3V3: PL1.15, R5.1, U3.2 (VCC)
+24VDC: K1.S2 (S), X14.1
ACCEL0+: X6.1, X11.1
ACCEL0-: X6.2, X11.2
ACCEL1+: X7.1, X13.1
ACCEL1-: X7.2, X13.2
AUX_DIN: OK1.4 (COL), PL1.16, R5.2
EXT_+5V: K1.1, PL1.1, R1.2, X10.2
GND: D2.C (2), D3.C (2), D4.C (2), D5.C (2), K1.16 (2), LED1.K (C), OK1.3 (EMIT), PL1.2, PL1.5, PL1.7, PL1.9, PL1.11, PL1.13, PL1.14, U3.1 (GND), X1.2, X2.2, X3.2, X4.2, X5.2, X12.2, X14.2
I2C_SCL: PL1.4, U3.3 (SCL)
I2C_SDA: PL1.3, U3.4 (SDA)
unnamed: R2.2, X15.1
unnamed: X1.1, X10.1
unnamed: LED1.A, R1.1
unnamed: D1.C, R2.1, R3.2, R4.1
unnamed: D1.A, LED2.K (C), OK1.2 (C), X15.2
unnamed: K1.P2, X12.1
unnamed: LED2.A, R3.1
unnamed: OK1.1 (A), R4.2
PE: H1.B3,6, H2.B3,6, X6.3, X7.3
RTD1_F+: SV1.1, X8.1
RTD1_F-: SV1.4, X8.4
RTD1_IN+: SV1.2, X8.2
RTD1_IN-: SV1.3, X8.3
RTD2_F+: SV2.1, X21.1
RTD2_F-: SV2.4, X21.4
RTD2_IN+: SV2.2, X21.2
RTD2_IN-: SV2.3, X21.3
SPEED1+: D3.A (1), PL1.10, X4.1
SPEED2+: D4.A (1), PL1.12, X5.1
TORQUE1+: D5.A (1), PL1.6, X2.1
TORQUE2+: D2.A (1), PL1.8, X3.1

Notes on the sheet:
Segnal da PL1i verso scheda front-end: 1. Ext.Supply +5V 2. GND 3. I2C_SDA 4. I2C_SCL 5. GND 6. Torque1+ 7. Torque1- 8. Torque2+ 9. Torque2- 10. Speed1+ 11. Speed1- 12. Speed2+ 13. Speed2- 14. GND 15. +3V3 16. AUX_DIN NOTA: collegamento diretto tra front-end e modulo RTD1 con flat 4 fili: RTD1_F+, 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
Interruttore On/Off ESP32
Alimentatore +5V
+5V
GND
Torque1+
Torque1-
Torque2+
Torque2-
Speed1+
Speed1-
Speed2+
Speed2-
Accel0+
Accel0-
Accel1+
Accel1-
RTD1 - connettore verso sensore
RTD2 - connettore verso sensore
RTD1 - connettore verso modulo RTD1 su motherboard
RTD2 - connettore verso modulo RTD2 su motherboard
Ai due accelerometri con cavo coassiale
Modulo esterno condizionamento coppia/velocità
Alimentatore +24V
+24V
Accel0 - connettore verso motherboard (Cavo coassiale ? )
Accel1 - connettore verso motherboard (Cavo coassiale ? )
NOTA: qui vanno collegati i due alimentatori (+5v e +24V) * Lasciamo i connettori X1 e X12 su questa scheda? * Altrimenti, il +24V lo facciamo arrivare solo alla scheda generatore di corrente? * mettere un relè tra +24V e scheda generatore corrente mandato dai +5V? così spegnendo la ESP32 si spegne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
On/Off
Alla scheda generatori di corrente
Ingresso ausiliario da PLC, +24VDC
Z2SMB24-DIO https://www.tme.eu/it/details/z2smb24-dio/diodi-zener-smd/diotec-semiconductor/z2smb24/

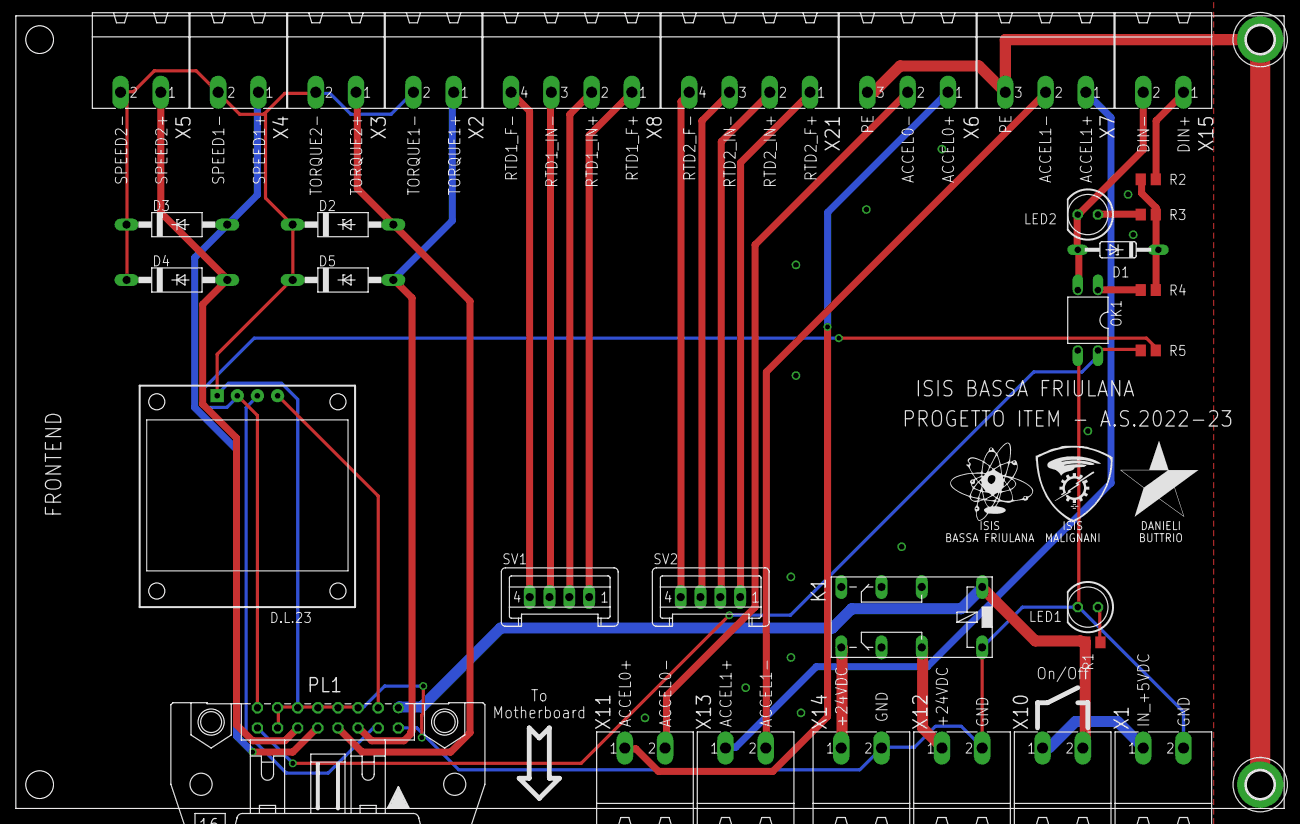
[picture p32: board item_2022_Frontend_02_V7.brd from above]

Board: 2 copper layers, 160.0 x 100.0 mm, 38 parts (0 on the bottom side), 32 nets.

Other parts of the board:
U$1: BASSA
U$2: UDINE
U$3: DANIELI
