damoreluc/ITEM_2223_git_V7/item_2022_analog_02.brd

## EAGLE design item_2022_analog_02.brd (2023-01-22)

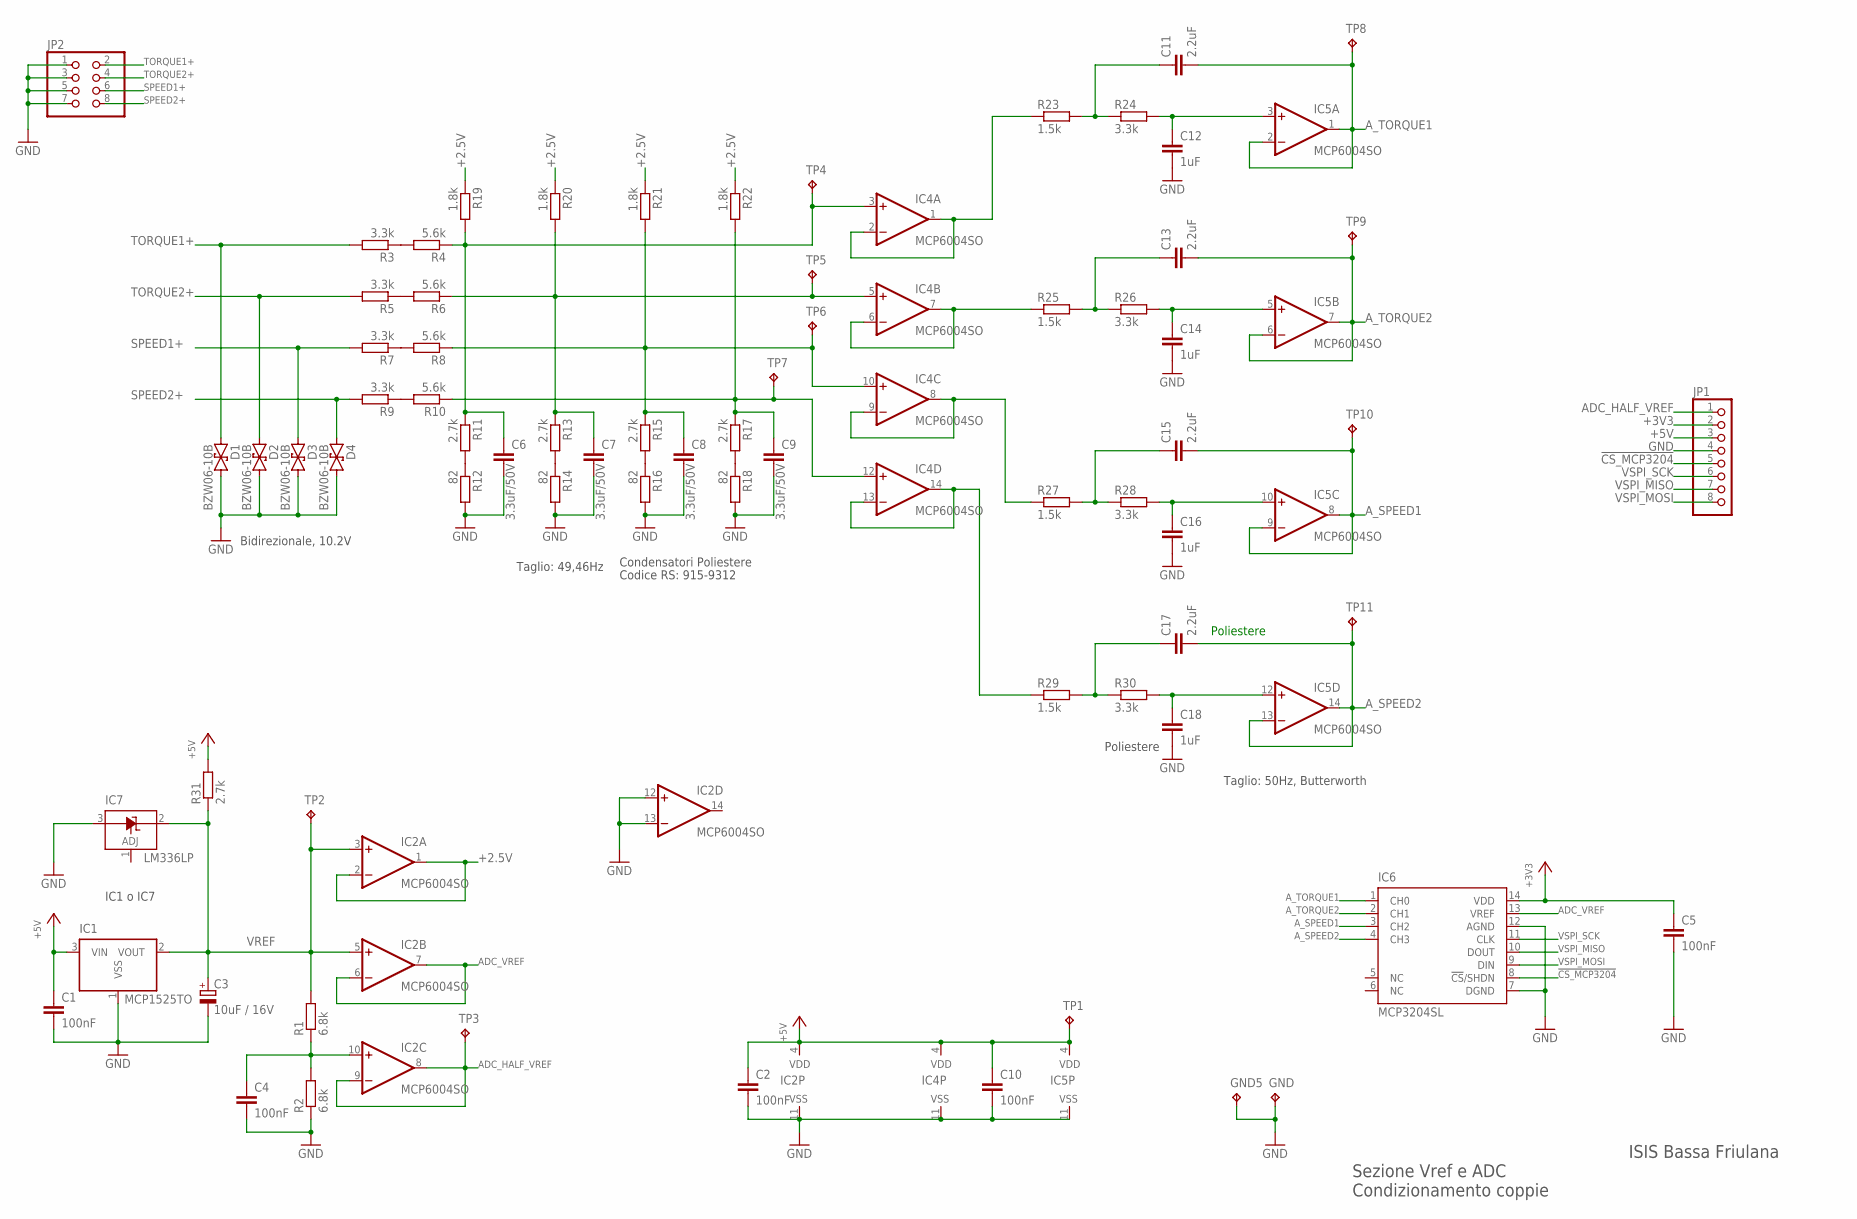
[picture p33: schematic item_2022_analog_02.sch]

Parts:
C1, C2, C4, C5, C10: 100nF; C0805
C3: 10uF / 16V; PANASONIC_C
C6, C7, C8, C9: 3.3uF/50V; C0805
C11, C13, C15, C17: 2.2uF; C0805
C12, C14, C16, C18: 1uF; C0805
D1, D2, D3, D4: BZW06-10B; F126Z12
GND, GND5: TPTP18SQ; TP18SQ
IC1: MCP1525TO; TO92
IC2, IC4, IC5: MCP6004SO; SO14
IC6: MCP3204SL; SO14
IC7: LM336LP; TO92
JP1: PINHD-1X8; 1X08
JP2: PINHD-2X4; 2X04
R1, R2: 6.8k; R0805
R3, R5, R9, R24, R26, R28, R30: 3.3k; R0805
R4, R6, R8, R10: 5.6k; R0805
R7: 3.3k; M0805
R11, R13, R15, R17, R31: 2.7k; R0805
R12, R14, R16, R18: 82; R0805
R19, R20, R21, R22: 1.8k; R0805
R23, R25, R27, R29: 1.5k; R0805
TP1, TP2, TP3: TPTP16R; TP16R
TP4, TP5, TP6, TP7, TP8, TP9, TP10, TP11: TPTP14R; TP14R

Connections:
!CS_MCP3204!: IC6.8 (!CS!/SHDN), JP1.5
+2.5V: IC2.1 (OUT), IC2.2 (-IN), R19.1, R20.1, R21.1, R22.1
+3V3: C5.1, IC6.14 (VDD), JP1.2
+5V: C1.1, C2.1, C10.1, IC1.3 (VIN), IC2.4 (VDD), IC4.4 (VDD), IC5.4 (VDD), JP1.3, R31.2, TP1.TP
ADC_HALF_VREF: IC2.8 (OUT), IC2.9 (-IN), JP1.1, TP3.TP
ADC_VREF: IC2.6 (-IN), IC2.7 (OUT), IC6.13 (VREF)
A_SPEED1: C15.2, IC5.8 (OUT), IC5.9 (-IN), IC6.3 (CH2), TP10.TP
A_SPEED2: C17.2, IC5.13 (-IN), IC5.14 (OUT), IC6.4 (CH3), TP11.TP
A_TORQUE1: C11.2, IC5.1 (OUT), IC5.2 (-IN), IC6.1 (CH0), TP8.TP
A_TORQUE2: C13.2, IC5.6 (-IN), IC5.7 (OUT), IC6.2 (CH1), TP9.TP
GND: C1.2, C2.2, C3.-, C4.2, C5.2, C6.2, C7.2, C8.2, C9.2, C10.2, C12.2, C14.2, C16.2, C18.2, D1.C (2), D2.C (2), D3.C (2), D4.C (2), GND.TP, GND5.TP, IC1.1 (VSS), IC2.11 (VSS), IC2.12 (+IN), IC2.13 (-IN), IC4.11 (VSS), IC5.11 (VSS), IC6.7 (DGND), IC6.12 (AGND), IC7.3 (A), JP1.4, JP2.1, JP2.3, JP2.5, JP2.7, R2.1, R12.2, R14.2, R16.2, R18.2
unnamed: C4.1, IC2.10 (+IN), R1.1, R2.2
unnamed: R3.1, R4.2
unnamed: R5.1, R6.2
unnamed: R7.1, R8.2
unnamed: R9.1, R10.2
unnamed: R11.2, R12.1
unnamed: C6.1, IC4.3 (+IN), R4.1, R11.1, R19.2, TP4.TP
unnamed: R13.2, R14.1
unnamed: R15.2, R16.1
unnamed: R17.2, R18.1
unnamed: C7.1, IC4.5 (+IN), R6.1, R13.1, R20.2, TP5.TP
unnamed: C8.1, IC4.10 (+IN), R8.1, R15.1, R21.2, TP6.TP
unnamed: C9.1, IC4.12 (+IN), R10.1, R17.1, R22.2, TP7.TP
unnamed: IC4.1 (OUT), IC4.2 (-IN), R23.1
unnamed: IC4.6 (-IN), IC4.7 (OUT), R25.1
unnamed: IC4.8 (OUT), IC4.9 (-IN), R27.1
unnamed: IC4.13 (-IN), IC4.14 (OUT), R29.1
unnamed: C11.1, R23.2, R24.1
unnamed: C12.1, IC5.3 (+IN), R24.2
unnamed: C13.1, R25.2, R26.1
unnamed: C14.1, IC5.5 (+IN), R26.2
unnamed: C15.1, R27.2, R28.1
unnamed: C16.1, IC5.10 (+IN), R28.2
unnamed: C17.1, R29.2, R30.1
unnamed: C18.1, IC5.12 (+IN), R30.2
SPEED1+: D3.A (1), JP2.6, R7.2
SPEED2+: D4.A (1), JP2.8, R9.2
TORQUE1+: D1.A (1), JP2.2, R3.2
TORQUE2+: D2.A (1), JP2.4, R5.2
VREF: C3.+, IC1.2 (VOUT), IC2.3 (+IN), IC2.5 (+IN), IC7.2 (C), R1.2, R31.1, TP2.TP
VSPI_MISO: IC6.10 (DOUT), JP1.7
VSPI_MOSI: IC6.9 (DIN), JP1.8
VSPI_SCK: IC6.11 (CLK), JP1.6

Notes on the sheet:
Sezione Vref e ADC Condizionamento coppie
ISIS Bassa Friulana
Condensatori Poliestere
Taglio: 50Hz, Butterworth
Poliestere
Taglio: 49,46Hz
Bidirezionale, 10.2V
Codice RS: 915-9312
IC1 o IC7

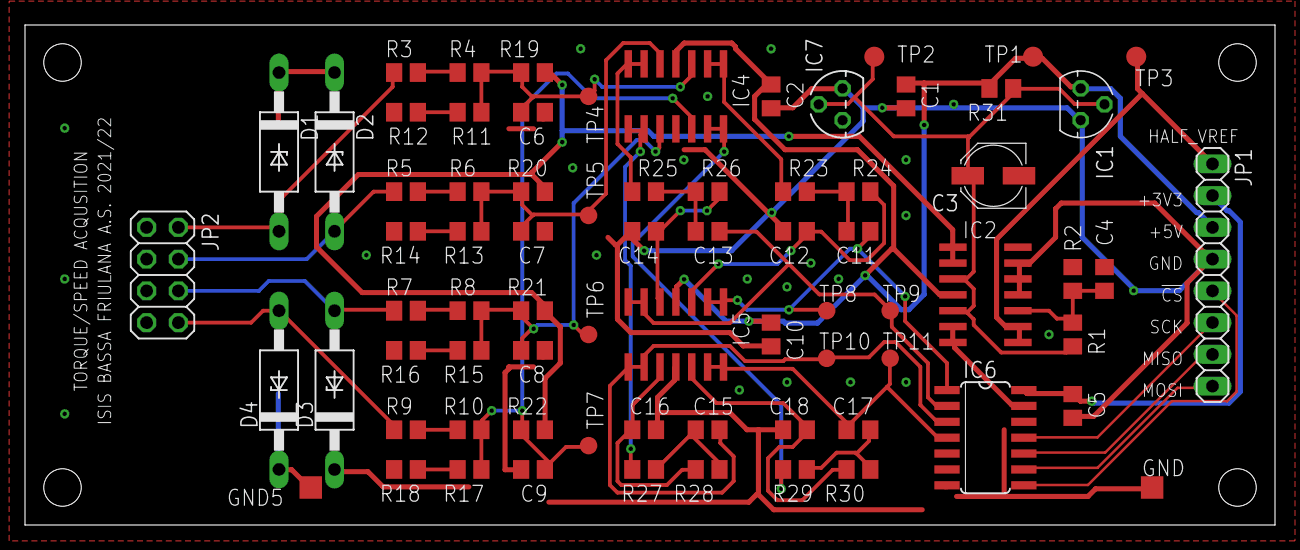
[picture p34: board item_2022_analog_02.brd from above]

Board: 2 copper layers, 100.0 x 40.0 mm, 74 parts (0 on the bottom side), 44 nets.
