damoreluc/ITEM_2223_git_V7/(commit log)

2023-01-22 aggiunta su sch condizionamento coppie
    [item_2022_Motherboard_04_V8.brd, item_2022_Motherboard_04_V8.sch]
2023-01-22 aggiunta su brd cond coppie da sbrogliare
    [item_2022_Motherboard_04_V8.brd, item_2022_Motherboard_04_V8.sch]
2023-01-28 place pcb components on grid
    [item_2022_Motherboard_04_V8.brd]
2023-01-28 changed PGA inputs
    [item_2022_Motherboard_04_V8.brd, item_2022_Motherboard_04_V8.sch]
2023-01-28 routing with changed PGA inputs
    [item_2022_Motherboard_04_V8.brd]
2023-01-28 routing with corrected pads
    [item_2022_Motherboard_04_V8.brd, item_2022_Motherboard_04_V8.sch]
2023-01-28 create gerber files
    [item_2022_Motherboard_04_V8.brd]
2023-01-29 corretto layer 21
    [item_2022_Motherboard_04_V8.brd, item_2022_Motherboard_04_V8.sch]
2023-01-29 corretto layer 21 e creato gerber
    [item_2022_Motherboard_04_V8.brd]
2023-01-29 cambio package elettrolitici smd
    [item_2022_Motherboard_04_V8.brd, item_2022_Motherboard_04_V8.sch]
2023-02-02 migliorate piste su D1
    [item_2022_Motherboard_04_V8.brd]
2023-02-02 spostati BZW su Frontend da motherboard
    [item_2022_Frontend_02_V7.brd, item_2022_Frontend_02_V7.sch, item_2022_Motherboard_04_V8.brd, item_2022_Motherboard_04_V8.sch]
2023-02-03 MCP6S28 DIL
    [item_2022_Motherboard_04_V8.brd, item_2022_Motherboard_04_V8.sch]
2023-02-03 Aggiornato frontend
    [item_2022_Frontend_02_V7.brd, item_2022_Frontend_02_V7.sch]
2023-02-04 Retrace piano GND in Motherboard
    [item_2022_Motherboard_04_V8.brd]
2023-02-04 Siglatura scheda FRONTEND
    [item_2022_Frontend_02_V7.brd, item_2022_Frontend_02_V7.sch]
2023-02-04 PDF con siglatura scheda FRONTEND
    [item_2022_Frontend_02_V7.brd]
2023-02-04 FrontEnd con PE
    [item_2022_Frontend_02_V7.brd, item_2022_Frontend_02_V7.sch, item_2022_Motherboard_04_V8.brd]
